rtreichl/Wordclock/02_Electronics/Bilder/Platine_3D_schraeg_unten.png

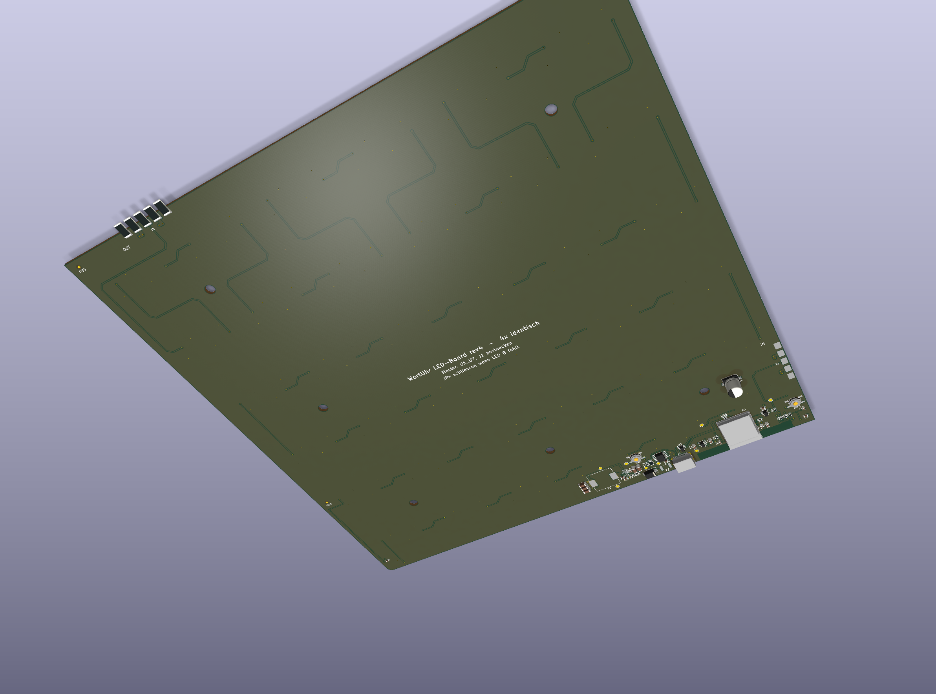
02_Electronics/Bilder/Platine_3D_schraeg_unten.png
