rtreichl/Wordclock/05_Production/03_Gitter_3D-Druck/QUALIFIKATION.md

# Qualifikationsbericht – Lichtgitter Q1–Q4

| | |
|---|---|
| Bauteil | Lichtgitter Q1–Q4 |
| Fertiger | P1S, JLC3DP |
| Datum | 2026-11-10 |
| Stand | Git `a8529da` |
| Pruefung | automatisch, `05_Production/tools/` |
| Ergebnis | **Bambu Lab P1S: FREIGEGEBEN** · **JLC3DP: FREIGEGEBEN** |

## Pruefergebnisse

| Kategorie | Pruefung | Kriterium | Messwert | P1S | JLC3DP |
|---|---|---|---|---|---|
| Geometrie | Gitter Q1 (P1S-Variante): Gueltiger Volumenkoerper | 1 gueltiger Solid | valid=True, solids=1 | ✅ bestanden | – |
| Netz | Gitter Q1 (P1S-Variante): Geschlossen und mannigfaltig | solid, keine nicht-mannigfaltigen Kanten, keine Selbstdurchdringung | solid=True, nonmanifold=False, selfint=False | ✅ bestanden | – |
| Bauraum | Gitter Q1 (P1S-Variante): Groesse in Druckorientierung | P1S <= 256^3; JLC3DP <= 250 x 250 x 300, >= 30 x 30 x 10 | 244.1 x 243.5 x 25.0 mm | ✅ bestanden | – |
| Bauraum | Gitter Q1 (P1S-Variante): Flach auf dem Druckbett | Auflageflaeche > 20 cm^2 bei z = 0 | 242 cm^2 | ✅ bestanden | – |
| Wandstaerke | Gitter Q1 (P1S-Variante): Duennste Wand (Strahlmessung, 20000 Punkte) | >= 0.84 mm | 2.50 mm bei (12.5, -173.3, 1.7) | ✅ bestanden | – |
| Bohrungen | Gitter Q1 (P1S-Variante): Kleinste Bohrung | >= 1.5 mm | Kernloch M3 2,6 mm; Magnet 3,2 mm; Lichtleiter 2,8 mm | ✅ bestanden | – |
| Passung | Gitter Q1 (P1S-Variante): Kollision mit Platine (inkl. Bauteile) | 0 mm^3 | 0.000 mm^3 | ✅ bestanden | – |
| Passung | Gitter Q1 (P1S-Variante): Ueberschneidung mit Nachbarteilen | 0 mm^3 | 0.000 mm^3 | ✅ bestanden | – |
| Passung | Gitter Q1 (P1S-Variante): Spiel Schwalbenschwanz | >= 0,15 mm (P1S, 0,4-mm-Duese) | 0,19 mm normal zur Flanke, 0,3 mm an der Stirn | ✅ bestanden | – |
| Masshaltigkeit | Gitter Q1 (P1S-Variante): Lochbild gegen Platine | Druckabweichung ~+-0,2 mm <= Lochspiel 0.65 mm | +-0,2 mm | ✅ bestanden | – |
| Geometrie | Gitter Q2 (P1S-Variante): Gueltiger Volumenkoerper | 1 gueltiger Solid | valid=True, solids=1 | ✅ bestanden | – |
| Netz | Gitter Q2 (P1S-Variante): Geschlossen und mannigfaltig | solid, keine nicht-mannigfaltigen Kanten, keine Selbstdurchdringung | solid=True, nonmanifold=False, selfint=False | ✅ bestanden | – |
| Bauraum | Gitter Q2 (P1S-Variante): Groesse in Druckorientierung | P1S <= 256^3; JLC3DP <= 250 x 250 x 300, >= 30 x 30 x 10 | 239.4 x 243.5 x 25.0 mm | ✅ bestanden | – |
| Bauraum | Gitter Q2 (P1S-Variante): Flach auf dem Druckbett | Auflageflaeche > 20 cm^2 bei z = 0 | 239 cm^2 | ✅ bestanden | – |
| Wandstaerke | Gitter Q2 (P1S-Variante): Duennste Wand (Strahlmessung, 20000 Punkte) | >= 0.84 mm | 2.50 mm bei (254.3, -54.5, 22.9) | ✅ bestanden | – |
| Bohrungen | Gitter Q2 (P1S-Variante): Kleinste Bohrung | >= 1.5 mm | Kernloch M3 2,6 mm; Magnet 3,2 mm; Lichtleiter 2,8 mm | ✅ bestanden | – |
| Passung | Gitter Q2 (P1S-Variante): Kollision mit Platine (inkl. Bauteile) | 0 mm^3 | 0.000 mm^3 | ✅ bestanden | – |
| Passung | Gitter Q2 (P1S-Variante): Ueberschneidung mit Nachbarteilen | 0 mm^3 | 0.000 mm^3 | ✅ bestanden | – |
| Passung | Gitter Q2 (P1S-Variante): Spiel Schwalbenschwanz | >= 0,15 mm (P1S, 0,4-mm-Duese) | 0,19 mm normal zur Flanke, 0,3 mm an der Stirn | ✅ bestanden | – |
| Masshaltigkeit | Gitter Q2 (P1S-Variante): Lochbild gegen Platine | Druckabweichung ~+-0,2 mm <= Lochspiel 0.65 mm | +-0,2 mm | ✅ bestanden | – |
| Geometrie | Gitter Q3 (P1S-Variante): Gueltiger Volumenkoerper | 1 gueltiger Solid | valid=True, solids=1 | ✅ bestanden | – |
| Netz | Gitter Q3 (P1S-Variante): Geschlossen und mannigfaltig | solid, keine nicht-mannigfaltigen Kanten, keine Selbstdurchdringung | solid=True, nonmanifold=False, selfint=False | ✅ bestanden | – |
| Bauraum | Gitter Q3 (P1S-Variante): Groesse in Druckorientierung | P1S <= 256^3; JLC3DP <= 250 x 250 x 300, >= 30 x 30 x 10 | 244.1 x 240.0 x 25.0 mm | ✅ bestanden | – |
| Bauraum | Gitter Q3 (P1S-Variante): Flach auf dem Druckbett | Auflageflaeche > 20 cm^2 bei z = 0 | 242 cm^2 | ✅ bestanden | – |
| Wandstaerke | Gitter Q3 (P1S-Variante): Duennste Wand (Strahlmessung, 20000 Punkte) | >= 0.84 mm | 2.50 mm bei (54.4, -253.5, 22.9) | ✅ bestanden | – |
| Bohrungen | Gitter Q3 (P1S-Variante): Kleinste Bohrung | >= 1.5 mm | Kernloch M3 2,6 mm; Magnet 3,2 mm; Lichtleiter 2,8 mm | ✅ bestanden | – |
| Passung | Gitter Q3 (P1S-Variante): Kollision mit Platine (inkl. Bauteile) | 0 mm^3 | 0.000 mm^3 | ✅ bestanden | – |
| Passung | Gitter Q3 (P1S-Variante): Ueberschneidung mit Nachbarteilen | 0 mm^3 | 0.000 mm^3 | ✅ bestanden | – |
| Passung | Gitter Q3 (P1S-Variante): Spiel Schwalbenschwanz | >= 0,15 mm (P1S, 0,4-mm-Duese) | 0,19 mm normal zur Flanke, 0,3 mm an der Stirn | ✅ bestanden | – |
| Masshaltigkeit | Gitter Q3 (P1S-Variante): Lochbild gegen Platine | Druckabweichung ~+-0,2 mm <= Lochspiel 0.65 mm | +-0,2 mm | ✅ bestanden | – |
| Geometrie | Gitter Q4 (P1S-Variante): Gueltiger Volumenkoerper | 1 gueltiger Solid | valid=True, solids=1 | ✅ bestanden | – |
| Netz | Gitter Q4 (P1S-Variante): Geschlossen und mannigfaltig | solid, keine nicht-mannigfaltigen Kanten, keine Selbstdurchdringung | solid=True, nonmanifold=False, selfint=False | ✅ bestanden | – |
| Bauraum | Gitter Q4 (P1S-Variante): Groesse in Druckorientierung | P1S <= 256^3; JLC3DP <= 250 x 250 x 300, >= 30 x 30 x 10 | 239.4 x 240.0 x 25.0 mm | ✅ bestanden | – |
| Bauraum | Gitter Q4 (P1S-Variante): Flach auf dem Druckbett | Auflageflaeche > 20 cm^2 bei z = 0 | 239 cm^2 | ✅ bestanden | – |
| Wandstaerke | Gitter Q4 (P1S-Variante): Duennste Wand (Strahlmessung, 20000 Punkte) | >= 0.84 mm | 2.50 mm bei (285.4, -253.8, 22.9) | ✅ bestanden | – |
| Bohrungen | Gitter Q4 (P1S-Variante): Kleinste Bohrung | >= 1.5 mm | Kernloch M3 2,6 mm; Magnet 3,2 mm; Lichtleiter 2,8 mm | ✅ bestanden | – |
| Passung | Gitter Q4 (P1S-Variante): Kollision mit Platine (inkl. Bauteile) | 0 mm^3 | 0.000 mm^3 | ✅ bestanden | – |
| Passung | Gitter Q4 (P1S-Variante): Ueberschneidung mit Nachbarteilen | 0 mm^3 | 0.000 mm^3 | ✅ bestanden | – |
| Passung | Gitter Q4 (P1S-Variante): Spiel Schwalbenschwanz | >= 0,15 mm (P1S, 0,4-mm-Duese) | 0,19 mm normal zur Flanke, 0,3 mm an der Stirn | ✅ bestanden | – |
| Masshaltigkeit | Gitter Q4 (P1S-Variante): Lochbild gegen Platine | Druckabweichung ~+-0,2 mm <= Lochspiel 0.65 mm | +-0,2 mm | ✅ bestanden | – |
| Geometrie | Gitter Q1 (JLC3DP-Variante): Gueltiger Volumenkoerper | 1 gueltiger Solid | valid=True, solids=1 | – | ✅ bestanden |
| Netz | Gitter Q1 (JLC3DP-Variante): Geschlossen und mannigfaltig | solid, keine nicht-mannigfaltigen Kanten, keine Selbstdurchdringung | solid=True, nonmanifold=False, selfint=False | – | ✅ bestanden |
| Bauraum | Gitter Q1 (JLC3DP-Variante): Groesse in Druckorientierung | P1S <= 256^3; JLC3DP <= 250 x 250 x 300, >= 30 x 30 x 10 | 243.9 x 243.3 x 25.0 mm | – | ✅ bestanden |
| Bauraum | Gitter Q1 (JLC3DP-Variante): Flach auf dem Druckbett | Auflageflaeche > 20 cm^2 bei z = 0 | 240 cm^2 | – | ✅ bestanden |
| Wandstaerke | Gitter Q1 (JLC3DP-Variante): Duennste Wand (Strahlmessung, 20000 Punkte) | >= 2.5 mm | 2.50 mm bei (12.5, -173.2, 1.7) | – | ✅ bestanden |
| Bohrungen | Gitter Q1 (JLC3DP-Variante): Kleinste Bohrung | >= 1.5 mm | Kernloch M3 2,6 mm; Magnet 3,2 mm; Lichtleiter 2,8 mm | – | ✅ bestanden |
| Passung | Gitter Q1 (JLC3DP-Variante): Kollision mit Platine (inkl. Bauteile) | 0 mm^3 | 0.000 mm^3 | – | ✅ bestanden |
| Passung | Gitter Q1 (JLC3DP-Variante): Ueberschneidung mit Nachbarteilen | 0 mm^3 | 0.000 mm^3 | – | ✅ bestanden |
| Passung | Gitter Q1 (JLC3DP-Variante): Spiel zwischen den Teilen (gemessen) | >= 0.5 mm Montagespiel | 0.500 mm | – | ✅ bestanden |
| Masshaltigkeit | Gitter Q1 (JLC3DP-Variante): Lochbild gegen Platine | +-0,4 % auf 218 mm, halbe Abweichung <= Lochspiel 0.65 mm | 0.44 mm | – | ✅ bestanden |
| Masshaltigkeit | Gitter Q1 (JLC3DP-Variante): Versatz der Schwalbenschwaenze entlang der Fuge | 0,4 % auf 77 mm <= Seitenspiel 0.53 mm | 0.31 mm | – | ✅ bestanden |
| Masshaltigkeit | Gitter Q1 (JLC3DP-Variante): Fuge bei Uebermass | Uebermass ueber halbe Fuge <= Lochspiel 0.65 mm | 0.23 mm | – | ✅ bestanden |
| Geometrie | Gitter Q2 (JLC3DP-Variante): Gueltiger Volumenkoerper | 1 gueltiger Solid | valid=True, solids=1 | – | ✅ bestanden |
| Netz | Gitter Q2 (JLC3DP-Variante): Geschlossen und mannigfaltig | solid, keine nicht-mannigfaltigen Kanten, keine Selbstdurchdringung | solid=True, nonmanifold=False, selfint=False | – | ✅ bestanden |
| Bauraum | Gitter Q2 (JLC3DP-Variante): Groesse in Druckorientierung | P1S <= 256^3; JLC3DP <= 250 x 250 x 300, >= 30 x 30 x 10 | 239.1 x 243.3 x 25.0 mm | – | ✅ bestanden |
| Bauraum | Gitter Q2 (JLC3DP-Variante): Flach auf dem Druckbett | Auflageflaeche > 20 cm^2 bei z = 0 | 237 cm^2 | – | ✅ bestanden |
| Wandstaerke | Gitter Q2 (JLC3DP-Variante): Duennste Wand (Strahlmessung, 20000 Punkte) | >= 2.5 mm | 2.50 mm bei (254.1, -131.1, 22.9) | – | ✅ bestanden |
| Bohrungen | Gitter Q2 (JLC3DP-Variante): Kleinste Bohrung | >= 1.5 mm | Kernloch M3 2,6 mm; Magnet 3,2 mm; Lichtleiter 2,8 mm | – | ✅ bestanden |
| Passung | Gitter Q2 (JLC3DP-Variante): Kollision mit Platine (inkl. Bauteile) | 0 mm^3 | 0.000 mm^3 | – | ✅ bestanden |
| Passung | Gitter Q2 (JLC3DP-Variante): Ueberschneidung mit Nachbarteilen | 0 mm^3 | 0.000 mm^3 | – | ✅ bestanden |
| Passung | Gitter Q2 (JLC3DP-Variante): Spiel zwischen den Teilen (gemessen) | >= 0.5 mm Montagespiel | 0.500 mm | – | ✅ bestanden |
| Masshaltigkeit | Gitter Q2 (JLC3DP-Variante): Lochbild gegen Platine | +-0,4 % auf 218 mm, halbe Abweichung <= Lochspiel 0.65 mm | 0.44 mm | – | ✅ bestanden |
| Masshaltigkeit | Gitter Q2 (JLC3DP-Variante): Versatz der Schwalbenschwaenze entlang der Fuge | 0,4 % auf 77 mm <= Seitenspiel 0.53 mm | 0.31 mm | – | ✅ bestanden |
| Masshaltigkeit | Gitter Q2 (JLC3DP-Variante): Fuge bei Uebermass | Uebermass ueber halbe Fuge <= Lochspiel 0.65 mm | 0.23 mm | – | ✅ bestanden |
| Geometrie | Gitter Q3 (JLC3DP-Variante): Gueltiger Volumenkoerper | 1 gueltiger Solid | valid=True, solids=1 | – | ✅ bestanden |
| Netz | Gitter Q3 (JLC3DP-Variante): Geschlossen und mannigfaltig | solid, keine nicht-mannigfaltigen Kanten, keine Selbstdurchdringung | solid=True, nonmanifold=False, selfint=False | – | ✅ bestanden |
| Bauraum | Gitter Q3 (JLC3DP-Variante): Groesse in Druckorientierung | P1S <= 256^3; JLC3DP <= 250 x 250 x 300, >= 30 x 30 x 10 | 243.9 x 239.8 x 25.0 mm | – | ✅ bestanden |
| Bauraum | Gitter Q3 (JLC3DP-Variante): Flach auf dem Druckbett | Auflageflaeche > 20 cm^2 bei z = 0 | 240 cm^2 | – | ✅ bestanden |
| Wandstaerke | Gitter Q3 (JLC3DP-Variante): Duennste Wand (Strahlmessung, 20000 Punkte) | >= 2.5 mm | 2.50 mm bei (138.6, -253.7, 22.9) | – | ✅ bestanden |
| Bohrungen | Gitter Q3 (JLC3DP-Variante): Kleinste Bohrung | >= 1.5 mm | Kernloch M3 2,6 mm; Magnet 3,2 mm; Lichtleiter 2,8 mm | – | ✅ bestanden |
| Passung | Gitter Q3 (JLC3DP-Variante): Kollision mit Platine (inkl. Bauteile) | 0 mm^3 | 0.000 mm^3 | – | ✅ bestanden |
| Passung | Gitter Q3 (JLC3DP-Variante): Ueberschneidung mit Nachbarteilen | 0 mm^3 | 0.000 mm^3 | – | ✅ bestanden |
| Passung | Gitter Q3 (JLC3DP-Variante): Spiel zwischen den Teilen (gemessen) | >= 0.5 mm Montagespiel | 0.500 mm | – | ✅ bestanden |
| Masshaltigkeit | Gitter Q3 (JLC3DP-Variante): Lochbild gegen Platine | +-0,4 % auf 218 mm, halbe Abweichung <= Lochspiel 0.65 mm | 0.44 mm | – | ✅ bestanden |
| Masshaltigkeit | Gitter Q3 (JLC3DP-Variante): Versatz der Schwalbenschwaenze entlang der Fuge | 0,4 % auf 77 mm <= Seitenspiel 0.53 mm | 0.31 mm | – | ✅ bestanden |
| Masshaltigkeit | Gitter Q3 (JLC3DP-Variante): Fuge bei Uebermass | Uebermass ueber halbe Fuge <= Lochspiel 0.65 mm | 0.23 mm | – | ✅ bestanden |
| Geometrie | Gitter Q4 (JLC3DP-Variante): Gueltiger Volumenkoerper | 1 gueltiger Solid | valid=True, solids=1 | – | ✅ bestanden |
| Netz | Gitter Q4 (JLC3DP-Variante): Geschlossen und mannigfaltig | solid, keine nicht-mannigfaltigen Kanten, keine Selbstdurchdringung | solid=True, nonmanifold=False, selfint=False | – | ✅ bestanden |
| Bauraum | Gitter Q4 (JLC3DP-Variante): Groesse in Druckorientierung | P1S <= 256^3; JLC3DP <= 250 x 250 x 300, >= 30 x 30 x 10 | 239.1 x 239.8 x 25.0 mm | – | ✅ bestanden |
| Bauraum | Gitter Q4 (JLC3DP-Variante): Flach auf dem Druckbett | Auflageflaeche > 20 cm^2 bei z = 0 | 237 cm^2 | – | ✅ bestanden |
| Wandstaerke | Gitter Q4 (JLC3DP-Variante): Duennste Wand (Strahlmessung, 20000 Punkte) | >= 2.5 mm | 2.50 mm bei (254.2, -445.6, 22.9) | – | ✅ bestanden |
| Bohrungen | Gitter Q4 (JLC3DP-Variante): Kleinste Bohrung | >= 1.5 mm | Kernloch M3 2,6 mm; Magnet 3,2 mm; Lichtleiter 2,8 mm | – | ✅ bestanden |
| Passung | Gitter Q4 (JLC3DP-Variante): Kollision mit Platine (inkl. Bauteile) | 0 mm^3 | 0.000 mm^3 | – | ✅ bestanden |
| Passung | Gitter Q4 (JLC3DP-Variante): Ueberschneidung mit Nachbarteilen | 0 mm^3 | 0.000 mm^3 | – | ✅ bestanden |
| Passung | Gitter Q4 (JLC3DP-Variante): Spiel zwischen den Teilen (gemessen) | >= 0.5 mm Montagespiel | 0.500 mm | – | ✅ bestanden |
| Masshaltigkeit | Gitter Q4 (JLC3DP-Variante): Lochbild gegen Platine | +-0,4 % auf 218 mm, halbe Abweichung <= Lochspiel 0.65 mm | 0.44 mm | – | ✅ bestanden |
| Masshaltigkeit | Gitter Q4 (JLC3DP-Variante): Versatz der Schwalbenschwaenze entlang der Fuge | 0,4 % auf 77 mm <= Seitenspiel 0.53 mm | 0.31 mm | – | ✅ bestanden |
| Masshaltigkeit | Gitter Q4 (JLC3DP-Variante): Fuge bei Uebermass | Uebermass ueber halbe Fuge <= Lochspiel 0.65 mm | 0.23 mm | – | ✅ bestanden |

## Hinweise und offene Punkte

- **Gitter Q1 (P1S-Variante): Duennste Wand (Strahlmessung, 20000 Punkte):** Duenne Stellen: Waende der Schwalbenschwanz-Taschen und um die Magnetbohrungen.
- **Gitter Q1 (P1S-Variante): Kleinste Bohrung:** FDM-Bohrungen fallen etwas kleiner aus: Magnetbohrungen ggf. mit 3,2-mm-Bohrer nacharbeiten.
- **Gitter Q2 (P1S-Variante): Duennste Wand (Strahlmessung, 20000 Punkte):** Duenne Stellen: Waende der Schwalbenschwanz-Taschen und um die Magnetbohrungen.
- **Gitter Q2 (P1S-Variante): Kleinste Bohrung:** FDM-Bohrungen fallen etwas kleiner aus: Magnetbohrungen ggf. mit 3,2-mm-Bohrer nacharbeiten.
- **Gitter Q3 (P1S-Variante): Duennste Wand (Strahlmessung, 20000 Punkte):** Duenne Stellen: Waende der Schwalbenschwanz-Taschen und um die Magnetbohrungen.
- **Gitter Q3 (P1S-Variante): Kleinste Bohrung:** FDM-Bohrungen fallen etwas kleiner aus: Magnetbohrungen ggf. mit 3,2-mm-Bohrer nacharbeiten.
- **Gitter Q4 (P1S-Variante): Duennste Wand (Strahlmessung, 20000 Punkte):** Duenne Stellen: Waende der Schwalbenschwanz-Taschen und um die Magnetbohrungen.
- **Gitter Q4 (P1S-Variante): Kleinste Bohrung:** FDM-Bohrungen fallen etwas kleiner aus: Magnetbohrungen ggf. mit 3,2-mm-Bohrer nacharbeiten.
- **Gitter Q1 (JLC3DP-Variante): Duennste Wand (Strahlmessung, 20000 Punkte):** Duenne Stellen: Waende der Schwalbenschwanz-Taschen und um die Magnetbohrungen.
- **Gitter Q1 (JLC3DP-Variante): Kleinste Bohrung:** FDM-Bohrungen fallen etwas kleiner aus: Magnetbohrungen ggf. mit 3,2-mm-Bohrer nacharbeiten.
- **Gitter Q1 (JLC3DP-Variante): Spiel zwischen den Teilen (gemessen):** Zapfen parallel zur Tasche verkleinert, Fuge 0,5 mm; Hinterschnitt 0,5 mm je Seite.
- **Gitter Q1 (JLC3DP-Variante): Versatz der Schwalbenschwaenze entlang der Fuge:** Annahme: alle 4 Teile in einer Bestellung aus demselben Material, Teile richten sich am mittleren Zapfen jeder Fuge aus.
- **Gitter Q2 (JLC3DP-Variante): Duennste Wand (Strahlmessung, 20000 Punkte):** Duenne Stellen: Waende der Schwalbenschwanz-Taschen und um die Magnetbohrungen.
- **Gitter Q2 (JLC3DP-Variante): Kleinste Bohrung:** FDM-Bohrungen fallen etwas kleiner aus: Magnetbohrungen ggf. mit 3,2-mm-Bohrer nacharbeiten.
- **Gitter Q2 (JLC3DP-Variante): Spiel zwischen den Teilen (gemessen):** Zapfen parallel zur Tasche verkleinert, Fuge 0,5 mm; Hinterschnitt 0,5 mm je Seite.
- **Gitter Q2 (JLC3DP-Variante): Versatz der Schwalbenschwaenze entlang der Fuge:** Annahme: alle 4 Teile in einer Bestellung aus demselben Material, Teile richten sich am mittleren Zapfen jeder Fuge aus.
- **Gitter Q3 (JLC3DP-Variante): Duennste Wand (Strahlmessung, 20000 Punkte):** Duenne Stellen: Waende der Schwalbenschwanz-Taschen und um die Magnetbohrungen.
- **Gitter Q3 (JLC3DP-Variante): Kleinste Bohrung:** FDM-Bohrungen fallen etwas kleiner aus: Magnetbohrungen ggf. mit 3,2-mm-Bohrer nacharbeiten.
- **Gitter Q3 (JLC3DP-Variante): Spiel zwischen den Teilen (gemessen):** Zapfen parallel zur Tasche verkleinert, Fuge 0,5 mm; Hinterschnitt 0,5 mm je Seite.
- **Gitter Q3 (JLC3DP-Variante): Versatz der Schwalbenschwaenze entlang der Fuge:** Annahme: alle 4 Teile in einer Bestellung aus demselben Material, Teile richten sich am mittleren Zapfen jeder Fuge aus.
- **Gitter Q4 (JLC3DP-Variante): Duennste Wand (Strahlmessung, 20000 Punkte):** Duenne Stellen: Waende der Schwalbenschwanz-Taschen und um die Magnetbohrungen.
- **Gitter Q4 (JLC3DP-Variante): Kleinste Bohrung:** FDM-Bohrungen fallen etwas kleiner aus: Magnetbohrungen ggf. mit 3,2-mm-Bohrer nacharbeiten.
- **Gitter Q4 (JLC3DP-Variante): Spiel zwischen den Teilen (gemessen):** Zapfen parallel zur Tasche verkleinert, Fuge 0,5 mm; Hinterschnitt 0,5 mm je Seite.
- **Gitter Q4 (JLC3DP-Variante): Versatz der Schwalbenschwaenze entlang der Fuge:** Annahme: alle 4 Teile in einer Bestellung aus demselben Material, Teile richten sich am mittleren Zapfen jeder Fuge aus.
- Druck: PLA, 0,4-mm-Duese, Gitter mit der Vorderseite (z = 25) auf dem Bett, Rueckrahmen mit der Wandseite auf dem Bett.

## Freigegebene Dateien

| Datei | SHA256 |
|---|---|
| `Gitter_Q1_obenlinks.step` | `7725c478193fb764…` |
| `Gitter_Q1_obenlinks_JLC3DP.step` | `16964a987c3249e7…` |
| `Gitter_Q1_obenlinks_JLC3DP_druckfertig.3mf` | `90f5346fd77986e1…` |
| `Gitter_Q1_obenlinks_druckfertig.3mf` | `179a4d64ef6c6e47…` |
| `Gitter_Q2_obenrechts.step` | `113b9d3d01cc0ba6…` |
| `Gitter_Q2_obenrechts_JLC3DP.step` | `8c0787b24e400f75…` |
| `Gitter_Q2_obenrechts_JLC3DP_druckfertig.3mf` | `8688b861642d8da3…` |
| `Gitter_Q2_obenrechts_druckfertig.3mf` | `f466d78a61dc06a5…` |
| `Gitter_Q3_untenlinks.step` | `57159257ab917b6e…` |
| `Gitter_Q3_untenlinks_JLC3DP.step` | `51162a58c96c1e39…` |
| `Gitter_Q3_untenlinks_JLC3DP_druckfertig.3mf` | `dc0893f47630a0c0…` |
| `Gitter_Q3_untenlinks_druckfertig.3mf` | `17754dc1e6e4d6c3…` |
| `Gitter_Q4_untenrechts.step` | `a61be4029f274bc2…` |
| `Gitter_Q4_untenrechts_JLC3DP.step` | `d2efce433491f0bc…` |
| `Gitter_Q4_untenrechts_JLC3DP_druckfertig.3mf` | `432d5da8599d5e3b…` |
| `Gitter_Q4_untenrechts_druckfertig.3mf` | `a79ab730cee3b6b5…` |

## Grundlage (Fertigerangaben, abgerufen 2026-11-07)

- [Bambu Lab P1S Spezifikation](https://wiki.bambulab.com/en/p1/manual/unboxing-p1s)
- [JLC3DP 3D Printing Design Guideline](https://jlc3dp.com/help/article/3D-Printing-Design-Guideline)
