rtreichl/Wordclock/05_Production/04_Rueckrahmen_3D-Druck/QUALIFIKATION.md

# Qualifikationsbericht – Rückrahmen (8 Leisten, 2 Druckplatten)

| | |
|---|---|
| Bauteil | Rückrahmen (8 Leisten, 2 Druckplatten) |
| Fertiger | P1S, JLC3DP |
| Datum | 2026-11-10 |
| Stand | Git `a8529da` |
| Pruefung | automatisch, `05_Production/tools/` |
| Ergebnis | **Bambu Lab P1S: FREIGEGEBEN** · **JLC3DP: FREIGEGEBEN** |

## Pruefergebnisse

| Kategorie | Pruefung | Kriterium | Messwert | P1S | JLC3DP |
|---|---|---|---|---|---|
| Geometrie | Rueckrahmen Q1_obenlinks_lang: Gueltiger Volumenkoerper | 1 gueltiger Solid | valid=True, solids=1 | ✅ bestanden | ✅ bestanden |
| Netz | Rueckrahmen Q1_obenlinks_lang: Geschlossen und mannigfaltig | solid, keine nicht-mannigfaltigen Kanten, keine Selbstdurchdringung | solid=True, nonmanifold=False, selfint=False | ✅ bestanden | ✅ bestanden |
| Bauraum | Rueckrahmen Q1_obenlinks_lang: Groesse in Druckorientierung | P1S <= 256^3; JLC3DP <= 250 x 250 x 300, >= 30 x 30 x 10 | 240.4 x 56.0 x 13.4 mm | ✅ bestanden | ✅ bestanden |
| Bauraum | Rueckrahmen Q1_obenlinks_lang: Flach auf dem Druckbett | Auflageflaeche > 20 cm^2 bei z = 0 | 132 cm^2 | ✅ bestanden | ✅ bestanden |
| Wandstaerke | Rueckrahmen Q1_obenlinks_lang: Duennste Wand (Strahlmessung, 1792 Punkte) | P1S >= 0.84 mm; JLC3DP >= 2.5 mm | 2.54 mm bei (216.4, -57.5, 2.3) | ✅ bestanden | ✅ bestanden |
| Passung | Rueckrahmen Q1_obenlinks_lang: Kollision mit Gitter | 0 mm^3 | 0.000 mm^3 | ✅ bestanden | ✅ bestanden |
| Bohrungen | Rueckrahmen Q1_obenlinks_lang: Kleinste Bohrung | JLC3DP >= 1.5 mm | Durchgang M3 3,4 mm; Schluesselloch 4,6/9 mm | ✅ bestanden | ✅ bestanden |
| Geometrie | Rueckrahmen Q1_obenlinks_kurz: Gueltiger Volumenkoerper | 1 gueltiger Solid | valid=True, solids=1 | ✅ bestanden | ✅ bestanden |
| Netz | Rueckrahmen Q1_obenlinks_kurz: Geschlossen und mannigfaltig | solid, keine nicht-mannigfaltigen Kanten, keine Selbstdurchdringung | solid=True, nonmanifold=False, selfint=False | ✅ bestanden | ✅ bestanden |
| Bauraum | Rueckrahmen Q1_obenlinks_kurz: Groesse in Druckorientierung | P1S <= 256^3; JLC3DP <= 250 x 250 x 300, >= 30 x 30 x 10 | 56.0 x 183.6 x 13.4 mm | ✅ bestanden | ✅ bestanden |
| Bauraum | Rueckrahmen Q1_obenlinks_kurz: Flach auf dem Druckbett | Auflageflaeche > 20 cm^2 bei z = 0 | 102 cm^2 | ✅ bestanden | ✅ bestanden |
| Wandstaerke | Rueckrahmen Q1_obenlinks_kurz: Duennste Wand (Strahlmessung, 1028 Punkte) | P1S >= 0.84 mm; JLC3DP >= 2.5 mm | 2.54 mm bei (59.5, -138.7, 2.3) | ✅ bestanden | ✅ bestanden |
| Passung | Rueckrahmen Q1_obenlinks_kurz: Kollision mit Gitter | 0 mm^3 | 0.000 mm^3 | ✅ bestanden | ✅ bestanden |
| Bohrungen | Rueckrahmen Q1_obenlinks_kurz: Kleinste Bohrung | JLC3DP >= 1.5 mm | Durchgang M3 3,4 mm; Schluesselloch 4,6/9 mm | ✅ bestanden | ✅ bestanden |
| Geometrie | Rueckrahmen Q2_obenrechts_lang: Gueltiger Volumenkoerper | 1 gueltiger Solid | valid=True, solids=1 | ✅ bestanden | ✅ bestanden |
| Netz | Rueckrahmen Q2_obenrechts_lang: Geschlossen und mannigfaltig | solid, keine nicht-mannigfaltigen Kanten, keine Selbstdurchdringung | solid=True, nonmanifold=False, selfint=False | ✅ bestanden | ✅ bestanden |
| Bauraum | Rueckrahmen Q2_obenrechts_lang: Groesse in Druckorientierung | P1S <= 256^3; JLC3DP <= 250 x 250 x 300, >= 30 x 30 x 10 | 239.2 x 56.0 x 13.4 mm | ✅ bestanden | ✅ bestanden |
| Bauraum | Rueckrahmen Q2_obenrechts_lang: Flach auf dem Druckbett | Auflageflaeche > 20 cm^2 bei z = 0 | 132 cm^2 | ✅ bestanden | ✅ bestanden |
| Wandstaerke | Rueckrahmen Q2_obenrechts_lang: Duennste Wand (Strahlmessung, 1772 Punkte) | P1S >= 0.84 mm; JLC3DP >= 2.5 mm | 2.54 mm bei (369.9, -56.0, 1.2) | ✅ bestanden | ✅ bestanden |
| Passung | Rueckrahmen Q2_obenrechts_lang: Kollision mit Gitter | 0 mm^3 | 0.000 mm^3 | ✅ bestanden | ✅ bestanden |
| Bohrungen | Rueckrahmen Q2_obenrechts_lang: Kleinste Bohrung | JLC3DP >= 1.5 mm | Durchgang M3 3,4 mm; Schluesselloch 4,6/9 mm | ✅ bestanden | ✅ bestanden |
| Geometrie | Rueckrahmen Q2_obenrechts_kurz: Gueltiger Volumenkoerper | 1 gueltiger Solid | valid=True, solids=1 | ✅ bestanden | ✅ bestanden |
| Netz | Rueckrahmen Q2_obenrechts_kurz: Geschlossen und mannigfaltig | solid, keine nicht-mannigfaltigen Kanten, keine Selbstdurchdringung | solid=True, nonmanifold=False, selfint=False | ✅ bestanden | ✅ bestanden |
| Bauraum | Rueckrahmen Q2_obenrechts_kurz: Groesse in Druckorientierung | P1S <= 256^3; JLC3DP <= 250 x 250 x 300, >= 30 x 30 x 10 | 56.0 x 183.6 x 13.4 mm | ✅ bestanden | ✅ bestanden |
| Bauraum | Rueckrahmen Q2_obenrechts_kurz: Flach auf dem Druckbett | Auflageflaeche > 20 cm^2 bei z = 0 | 101 cm^2 | ✅ bestanden | ✅ bestanden |
| Wandstaerke | Rueckrahmen Q2_obenrechts_kurz: Duennste Wand (Strahlmessung, 1048 Punkte) | P1S >= 0.84 mm; JLC3DP >= 2.5 mm | 2.54 mm bei (441.8, -138.7, 1.2) | ✅ bestanden | ✅ bestanden |
| Passung | Rueckrahmen Q2_obenrechts_kurz: Kollision mit Gitter | 0 mm^3 | 0.000 mm^3 | ✅ bestanden | ✅ bestanden |
| Bohrungen | Rueckrahmen Q2_obenrechts_kurz: Kleinste Bohrung | JLC3DP >= 1.5 mm | Durchgang M3 3,4 mm; Schluesselloch 4,6/9 mm | ✅ bestanden | ✅ bestanden |
| Geometrie | Rueckrahmen Q3_untenlinks_lang: Gueltiger Volumenkoerper | 1 gueltiger Solid | valid=True, solids=1 | ✅ bestanden | ✅ bestanden |
| Netz | Rueckrahmen Q3_untenlinks_lang: Geschlossen und mannigfaltig | solid, keine nicht-mannigfaltigen Kanten, keine Selbstdurchdringung | solid=True, nonmanifold=False, selfint=False | ✅ bestanden | ✅ bestanden |
| Bauraum | Rueckrahmen Q3_untenlinks_lang: Groesse in Druckorientierung | P1S <= 256^3; JLC3DP <= 250 x 250 x 300, >= 30 x 30 x 10 | 240.4 x 56.0 x 13.4 mm | ✅ bestanden | ✅ bestanden |
| Bauraum | Rueckrahmen Q3_untenlinks_lang: Flach auf dem Druckbett | Auflageflaeche > 20 cm^2 bei z = 0 | 134 cm^2 | ✅ bestanden | ✅ bestanden |
| Wandstaerke | Rueckrahmen Q3_untenlinks_lang: Duennste Wand (Strahlmessung, 1536 Punkte) | P1S >= 0.84 mm; JLC3DP >= 2.5 mm | 2.54 mm bei (133.3, -446.1, 2.3) | ✅ bestanden | ✅ bestanden |
| Passung | Rueckrahmen Q3_untenlinks_lang: Kollision mit Gitter | 0 mm^3 | 0.000 mm^3 | ✅ bestanden | ✅ bestanden |
| Bohrungen | Rueckrahmen Q3_untenlinks_lang: Kleinste Bohrung | JLC3DP >= 1.5 mm | Durchgang M3 3,4 mm; Schluesselloch 4,6/9 mm | ✅ bestanden | ✅ bestanden |
| Geometrie | Rueckrahmen Q3_untenlinks_kurz: Gueltiger Volumenkoerper | 1 gueltiger Solid | valid=True, solids=1 | ✅ bestanden | ✅ bestanden |
| Netz | Rueckrahmen Q3_untenlinks_kurz: Geschlossen und mannigfaltig | solid, keine nicht-mannigfaltigen Kanten, keine Selbstdurchdringung | solid=True, nonmanifold=False, selfint=False | ✅ bestanden | ✅ bestanden |
| Bauraum | Rueckrahmen Q3_untenlinks_kurz: Groesse in Druckorientierung | P1S <= 256^3; JLC3DP <= 250 x 250 x 300, >= 30 x 30 x 10 | 56.0 x 183.6 x 13.4 mm | ✅ bestanden | ✅ bestanden |
| Bauraum | Rueckrahmen Q3_untenlinks_kurz: Flach auf dem Druckbett | Auflageflaeche > 20 cm^2 bei z = 0 | 101 cm^2 | ✅ bestanden | ✅ bestanden |
| Wandstaerke | Rueckrahmen Q3_untenlinks_kurz: Duennste Wand (Strahlmessung, 1048 Punkte) | P1S >= 0.84 mm; JLC3DP >= 2.5 mm | 2.54 mm bei (58.2, -284.2, 2.3) | ✅ bestanden | ✅ bestanden |
| Passung | Rueckrahmen Q3_untenlinks_kurz: Kollision mit Gitter | 0 mm^3 | 0.000 mm^3 | ✅ bestanden | ✅ bestanden |
| Bohrungen | Rueckrahmen Q3_untenlinks_kurz: Kleinste Bohrung | JLC3DP >= 1.5 mm | Durchgang M3 3,4 mm; Schluesselloch 4,6/9 mm | ✅ bestanden | ✅ bestanden |
| Geometrie | Rueckrahmen Q4_untenrechts_lang: Gueltiger Volumenkoerper | 1 gueltiger Solid | valid=True, solids=1 | ✅ bestanden | ✅ bestanden |
| Netz | Rueckrahmen Q4_untenrechts_lang: Geschlossen und mannigfaltig | solid, keine nicht-mannigfaltigen Kanten, keine Selbstdurchdringung | solid=True, nonmanifold=False, selfint=False | ✅ bestanden | ✅ bestanden |
| Bauraum | Rueckrahmen Q4_untenrechts_lang: Groesse in Druckorientierung | P1S <= 256^3; JLC3DP <= 250 x 250 x 300, >= 30 x 30 x 10 | 239.2 x 56.0 x 13.4 mm | ✅ bestanden | ✅ bestanden |
| Bauraum | Rueckrahmen Q4_untenrechts_lang: Flach auf dem Druckbett | Auflageflaeche > 20 cm^2 bei z = 0 | 127 cm^2 | ✅ bestanden | ✅ bestanden |
| Wandstaerke | Rueckrahmen Q4_untenrechts_lang: Duennste Wand (Strahlmessung, 1624 Punkte) | P1S >= 0.84 mm; JLC3DP >= 2.5 mm | 2.54 mm bei (369.9, -444.0, 2.3) | ✅ bestanden | ✅ bestanden |
| Passung | Rueckrahmen Q4_untenrechts_lang: Kollision mit Gitter | 0 mm^3 | 0.000 mm^3 | ✅ bestanden | ✅ bestanden |
| Bohrungen | Rueckrahmen Q4_untenrechts_lang: Kleinste Bohrung | JLC3DP >= 1.5 mm | Durchgang M3 3,4 mm; Schluesselloch 4,6/9 mm | ✅ bestanden | ✅ bestanden |
| Geometrie | Rueckrahmen Q4_untenrechts_kurz: Gueltiger Volumenkoerper | 1 gueltiger Solid | valid=True, solids=1 | ✅ bestanden | ✅ bestanden |
| Netz | Rueckrahmen Q4_untenrechts_kurz: Geschlossen und mannigfaltig | solid, keine nicht-mannigfaltigen Kanten, keine Selbstdurchdringung | solid=True, nonmanifold=False, selfint=False | ✅ bestanden | ✅ bestanden |
| Bauraum | Rueckrahmen Q4_untenrechts_kurz: Groesse in Druckorientierung | P1S <= 256^3; JLC3DP <= 250 x 250 x 300, >= 30 x 30 x 10 | 56.0 x 183.6 x 13.4 mm | ✅ bestanden | ✅ bestanden |
| Bauraum | Rueckrahmen Q4_untenrechts_kurz: Flach auf dem Druckbett | Auflageflaeche > 20 cm^2 bei z = 0 | 102 cm^2 | ✅ bestanden | ✅ bestanden |
| Wandstaerke | Rueckrahmen Q4_untenrechts_kurz: Duennste Wand (Strahlmessung, 1028 Punkte) | P1S >= 0.84 mm; JLC3DP >= 2.5 mm | 2.54 mm bei (442.8, -284.2, 2.3) | ✅ bestanden | ✅ bestanden |
| Passung | Rueckrahmen Q4_untenrechts_kurz: Kollision mit Gitter | 0 mm^3 | 0.000 mm^3 | ✅ bestanden | ✅ bestanden |
| Bohrungen | Rueckrahmen Q4_untenrechts_kurz: Kleinste Bohrung | JLC3DP >= 1.5 mm | Durchgang M3 3,4 mm; Schluesselloch 4,6/9 mm | ✅ bestanden | ✅ bestanden |
| Bauraum | Druckplatten P1S: Rueckrahmen_Druckplatte1_lange_Leisten.3mf | <= 256 x 256 mm | 240.4 x 239.0 x 13.4 mm, solid=True | ✅ bestanden | – |
| Bauraum | Druckplatten P1S: Rueckrahmen_Druckplatte2_kurze_Leisten.3mf | <= 256 x 256 mm | 183.6 x 239.0 x 13.4 mm, solid=True | ✅ bestanden | – |

## Hinweise und offene Punkte

- Druck: PLA, 0,4-mm-Duese, Gitter mit der Vorderseite (z = 25) auf dem Bett, Rueckrahmen mit der Wandseite auf dem Bett.

## Freigegebene Dateien

| Datei | SHA256 |
|---|---|
| `Rueckrahmen_Druckplatte1_lange_Leisten.3mf` | `4fffa3f2a7c0ab02…` |
| `Rueckrahmen_Druckplatte2_kurze_Leisten.3mf` | `cd0ee39d4455c04a…` |
| `Rueckrahmen_Q1_obenlinks_kurz.step` | `99528059c08c30a2…` |
| `Rueckrahmen_Q1_obenlinks_lang.step` | `600fd471a78d4eb7…` |
| `Rueckrahmen_Q2_obenrechts_kurz.step` | `e918c6035d7c9521…` |
| `Rueckrahmen_Q2_obenrechts_lang.step` | `7eed7f04a02f106d…` |
| `Rueckrahmen_Q3_untenlinks_kurz.step` | `e402e935e3c285b7…` |
| `Rueckrahmen_Q3_untenlinks_lang.step` | `f9db8c83b3353f21…` |
| `Rueckrahmen_Q4_untenrechts_kurz.step` | `460c64799af1df21…` |
| `Rueckrahmen_Q4_untenrechts_lang.step` | `87ab05c4ed5b20d8…` |

## Grundlage (Fertigerangaben, abgerufen 2026-11-07)

- [Bambu Lab P1S Spezifikation](https://wiki.bambulab.com/en/p1/manual/unboxing-p1s)
- [JLC3DP 3D Printing Design Guideline](https://jlc3dp.com/help/article/3D-Printing-Design-Guideline)
