rtreichl/Wordclock/01_Mechanic/Magnet_Positionen_Zusammenbau.csv

Nr | X_mm | Y_mm | Bohrung
1 | 58.04 | -16.79 | D3.2 x 6.1 tief
2 | 96.56 | -16.79 | D3.2 x 6.1 tief
3 | 173.59 | -16.79 | D3.2 x 6.1 tief
4 | 212.11 | -16.79 | D3.2 x 6.1 tief
5 | 289.15 | -16.79 | D3.2 x 6.1 tief
6 | 327.66 | -16.79 | D3.2 x 6.1 tief
7 | 404.70 | -16.79 | D3.2 x 6.1 tief
8 | 443.22 | -16.79 | D3.2 x 6.1 tief
9 | 58.04 | -483.21 | D3.2 x 6.1 tief
10 | 96.56 | -483.21 | D3.2 x 6.1 tief
11 | 173.59 | -483.21 | D3.2 x 6.1 tief
12 | 212.11 | -483.21 | D3.2 x 6.1 tief
13 | 289.15 | -483.21 | D3.2 x 6.1 tief
14 | 327.66 | -483.21 | D3.2 x 6.1 tief
15 | 404.70 | -483.21 | D3.2 x 6.1 tief
16 | 443.22 | -483.21 | D3.2 x 6.1 tief
17 | 16.79 | -57.98 | D3.2 x 6.1 tief
18 | 16.79 | -96.39 | D3.2 x 6.1 tief
19 | 16.79 | -173.19 | D3.2 x 6.1 tief
20 | 16.79 | -211.60 | D3.2 x 6.1 tief
21 | 16.79 | -288.40 | D3.2 x 6.1 tief
22 | 16.79 | -326.81 | D3.2 x 6.1 tief
23 | 16.79 | -403.61 | D3.2 x 6.1 tief
24 | 16.79 | -442.02 | D3.2 x 6.1 tief
25 | 483.84 | -57.98 | D3.2 x 6.1 tief
26 | 483.84 | -96.39 | D3.2 x 6.1 tief
27 | 483.84 | -173.19 | D3.2 x 6.1 tief
28 | 483.84 | -211.60 | D3.2 x 6.1 tief
29 | 483.84 | -288.40 | D3.2 x 6.1 tief
30 | 483.84 | -326.81 | D3.2 x 6.1 tief
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
