rtreichl/Wordclock/02_Electronics/LED_Sollpositionen_Zusammenbau.csv

Spalte | Zeile | X_mm | Y_mm
1 | 1 | 38.780 | -38.780
2 | 1 | 77.298 | -38.780
3 | 1 | 115.816 | -38.780
4 | 1 | 154.333 | -38.780
5 | 1 | 192.851 | -38.780
6 | 1 | 231.369 | -38.780
7 | 1 | 269.886 | -38.780
8 | 1 | 308.404 | -38.780
9 | 1 | 346.922 | -38.780
10 | 1 | 385.439 | -38.780
11 | 1 | 423.957 | -38.780
12 | 1 | 462.475 | -38.780
1 | 2 | 38.780 | -77.183
2 | 2 | 77.298 | -77.183
3 | 2 | 115.816 | -77.183
4 | 2 | 154.333 | -77.183
5 | 2 | 192.851 | -77.183
6 | 2 | 231.369 | -77.183
7 | 2 | 269.886 | -77.183
8 | 2 | 308.404 | -77.183
9 | 2 | 346.922 | -77.183
10 | 2 | 385.439 | -77.183
11 | 2 | 423.957 | -77.183
12 | 2 | 462.475 | -77.183
1 | 3 | 38.780 | -115.587
2 | 3 | 77.298 | -115.587
3 | 3 | 115.816 | -115.587
4 | 3 | 154.333 | -115.587
5 | 3 | 192.851 | -115.587
6 | 3 | 231.369 | -115.587
7 | 3 | 269.886 | -115.587
8 | 3 | 308.404 | -115.587
9 | 3 | 346.922 | -115.587
10 | 3 | 385.439 | -115.587
11 | 3 | 423.957 | -115.587
12 | 3 | 462.475 | -115.587
1 | 4 | 38.780 | -153.991
2 | 4 | 77.298 | -153.991
3 | 4 | 115.816 | -153.991
4 | 4 | 154.333 | -153.991
5 | 4 | 192.851 | -153.991
6 | 4 | 231.369 | -153.991
7 | 4 | 269.886 | -153.991
8 | 4 | 308.404 | -153.991
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
