rtreichl/Wordclock/02_Electronics/Bilder/Platine_3D_oben.png

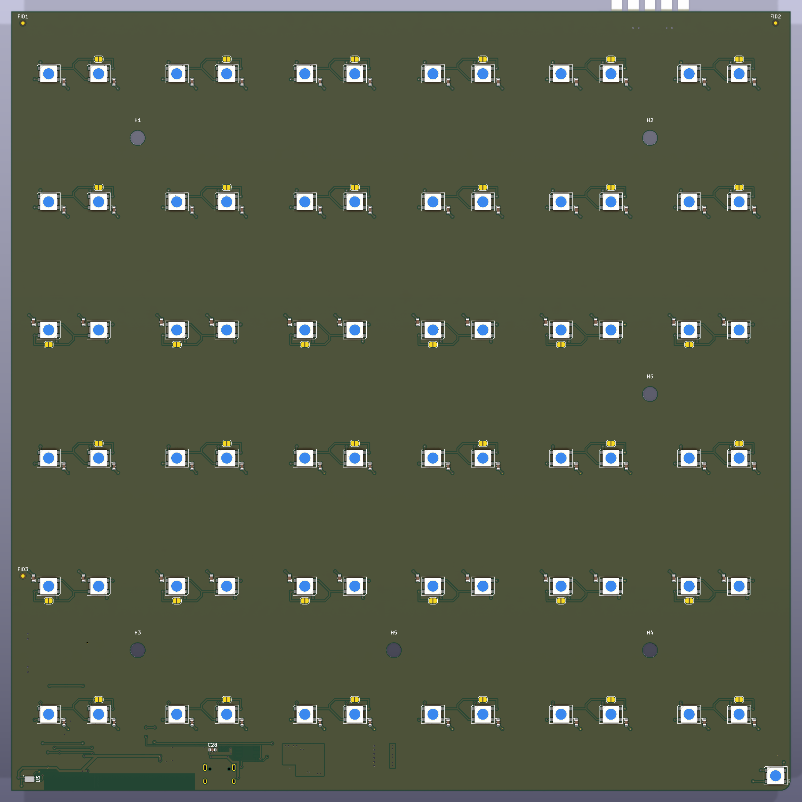
02_Electronics/Bilder/Platine_3D_oben.png
