rtreichl/Wordclock/02_Electronics/Bilder/Platine_3D_unten.png

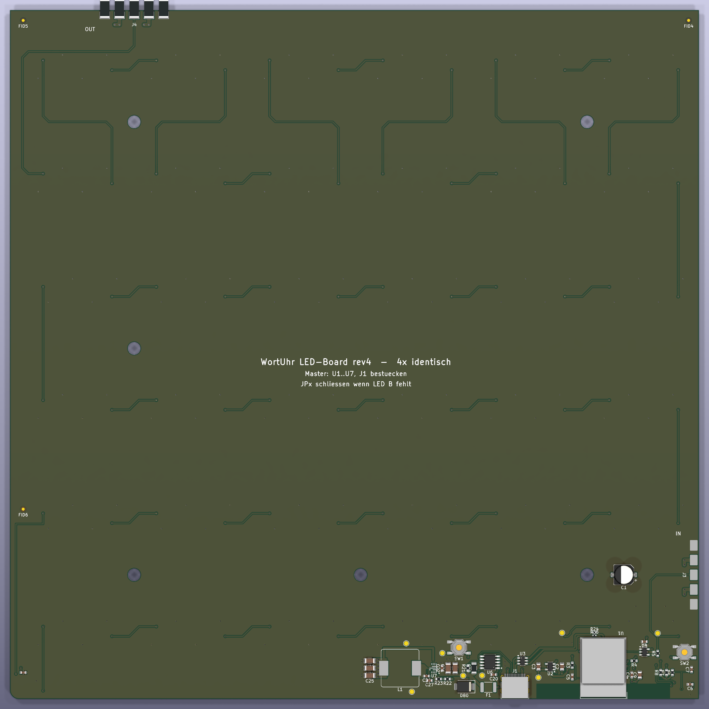
02_Electronics/Bilder/Platine_3D_unten.png
