rtreichl/Wordclock/02_Electronics/Bilder/Platzierung_Wandler_USB.png

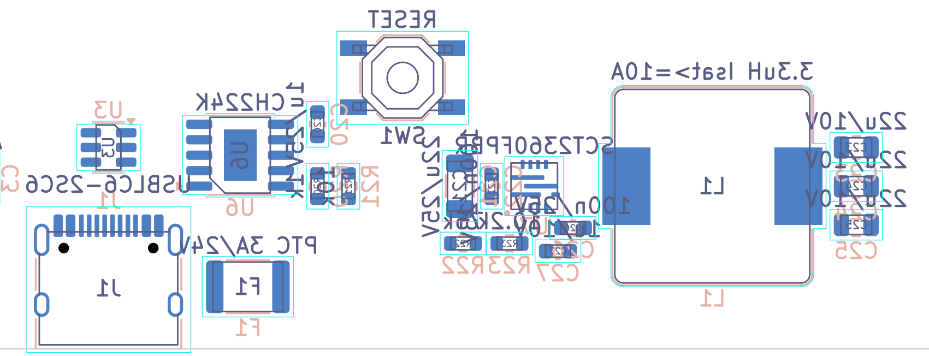
02_Electronics/Bilder/Platzierung_Wandler_USB.png
