rtreichl/Wordclock/02_Electronics/Bilder/Routing_Master_Oberseite.png

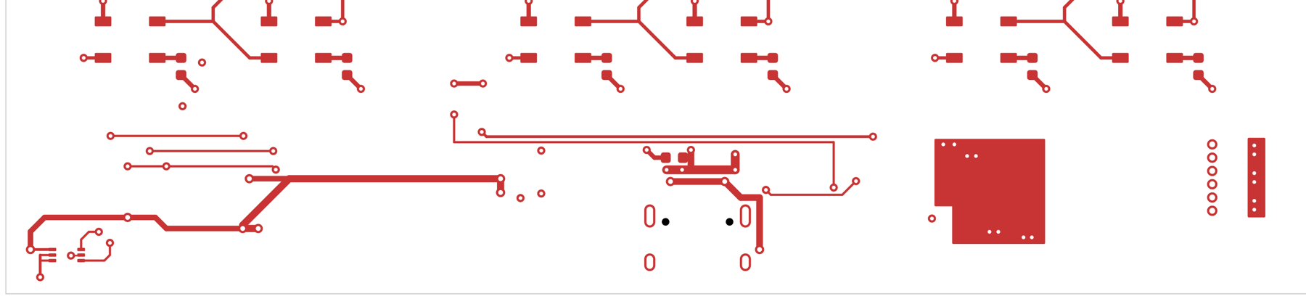
02_Electronics/Bilder/Routing_Master_Oberseite.png
