rtreichl/Wordclock/02_Electronics/Bilder/Routing_Master_Unterseite.png

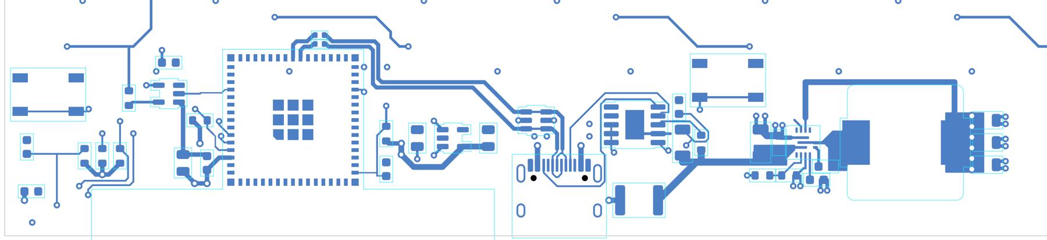
02_Electronics/Bilder/Routing_Master_Unterseite.png
