rtreichl/Wordclock/02_Electronics/Bilder/Routing_USB_Oberseite.png

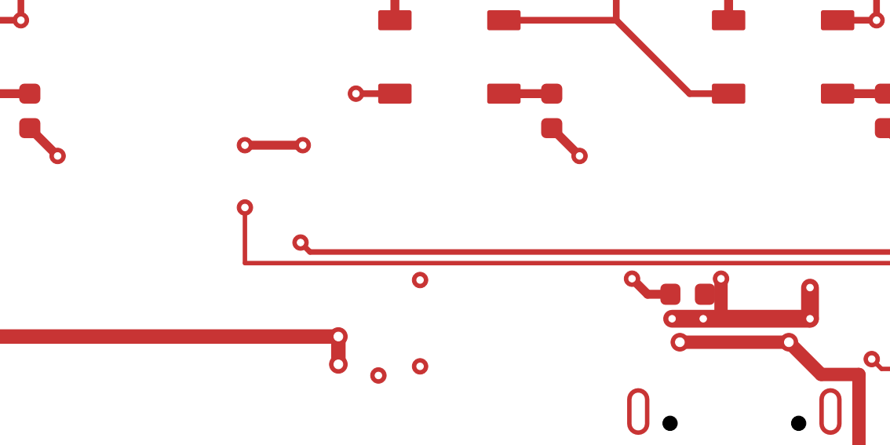
02_Electronics/Bilder/Routing_USB_Oberseite.png
