rtreichl/Wordclock/02_Electronics/Bilder/Routing_USB_Unterseite.png

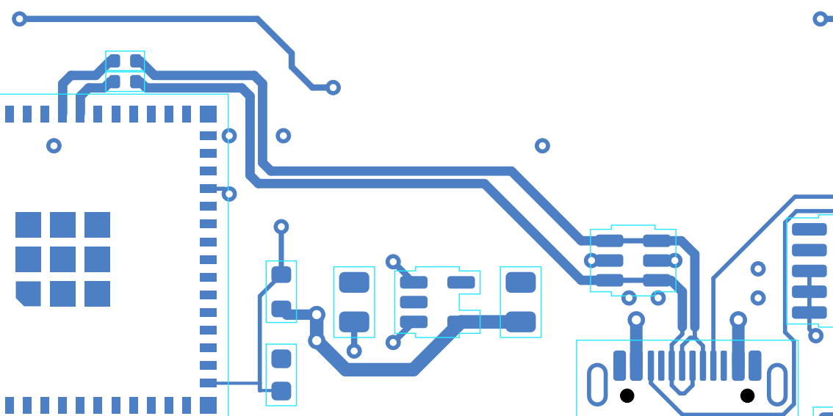
02_Electronics/Bilder/Routing_USB_Unterseite.png
