rtreichl/Wordclock/02_Electronics/Bilder/Routing_Wandler_Oberseite.png

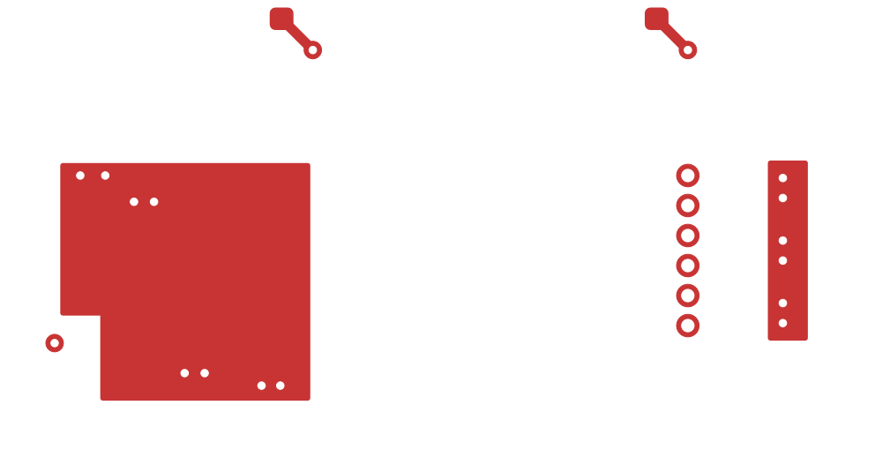
02_Electronics/Bilder/Routing_Wandler_Oberseite.png
