rtreichl/Wordclock/02_Electronics/Bilder/Routing_Wandler_Unterseite.png

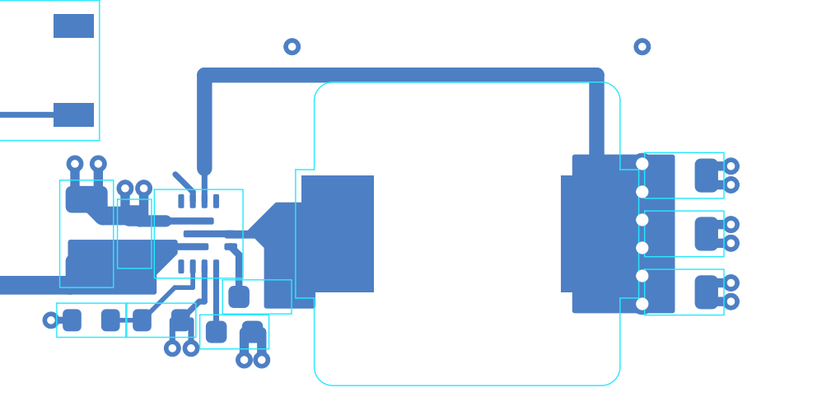
02_Electronics/Bilder/Routing_Wandler_Unterseite.png
