rtreichl/Wordclock/04_Rendering/WortUhr_angle.png

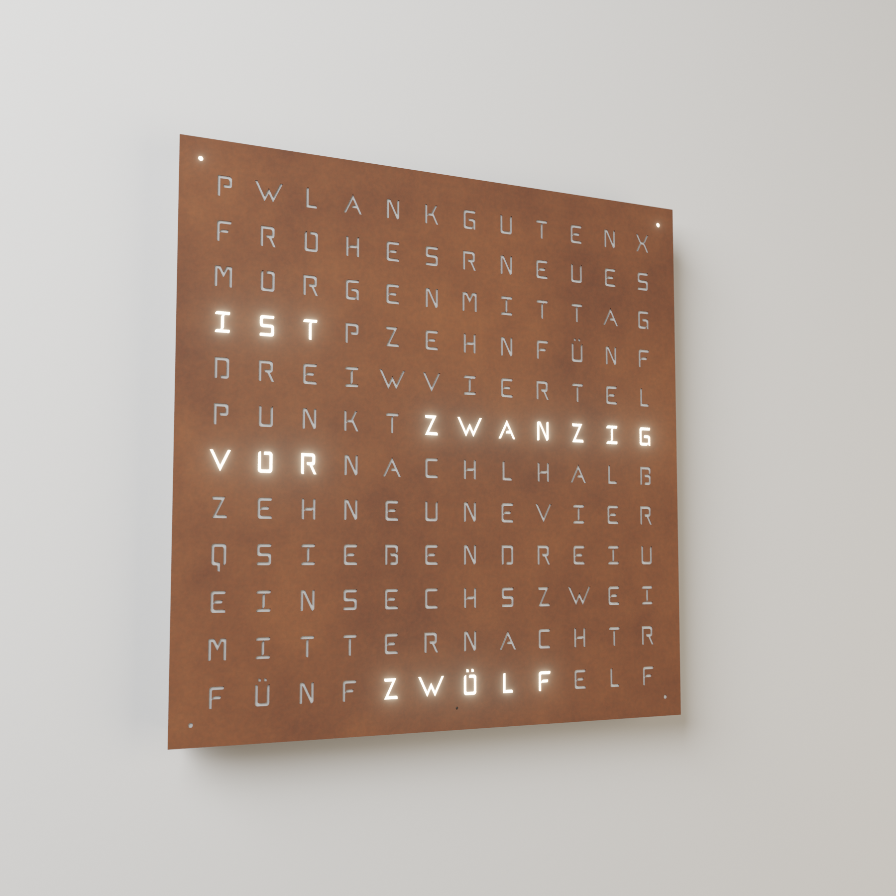
04_Rendering/WortUhr_angle.png
