rtreichl/Wordclock/04_Rendering/WortUhr_front.png

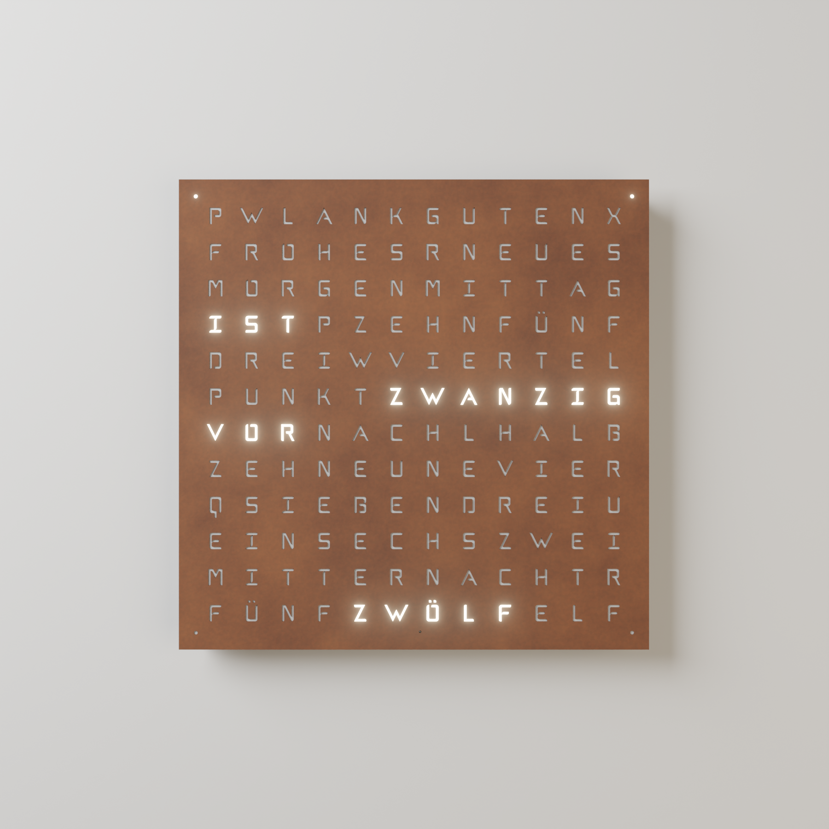
04_Rendering/WortUhr_front.png
