rtreichl/Wordclock/04_Rendering/WortUhr_front_blau_dunkel.png

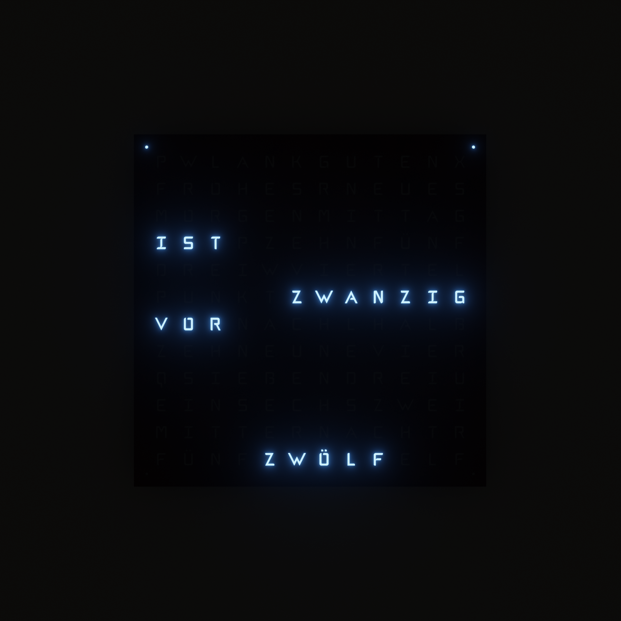
04_Rendering/WortUhr_front_blau_dunkel.png
