rtreichl/Wordclock/05_Production/05_Platine_JLCPCB/BOM_DigiKey.csv

Digi-Key Part Number | Manufacturer Part Number | Quantity | Customer Reference | Description
493-2165-1-ND | UWT1A101MCL1GB | 4 | C1 | 100u/10V CP_Elec_6.3x7.7
587-6025-1-ND | TMK212BBJ106MG-T | 2 | C2,C3 | 10u C_0805_2012Metric
399-C0603C104K5RACTUCT-ND | C0603C104K5RACTU | 296 | C4,C6,C8,C28,C101,C102,C103,C104,C105,C106,C107,C108,C109,C1 | 100n C_0603_1608Metric
399-C0603C105K3RACTUCT-ND | C0603C105K3RACTU | 2 | C5,C7 | 1u C_0603_1608Metric
399-C0805C226M8PACTUCT-ND | C0805C226M8PACTU | 1 | C9 | 22u/10V C_0805_2012Metric
399-C0603C105K3RACTUCT-ND | C0603C105K3RACTU | 1 | C20 | 1u/25V C_0603_1608Metric
311-3522-1-ND | CC1206MKX5R8BB226 | 5 | C21,C23,C24,C25,C29 | 22u/25V C_1206_3216Metric
399-C0603C104K5RACTUCT-ND | C0603C104K5RACTU | 2 | C22,C26 | 100n/25V C_0603_1608Metric
399-C0603C105K3RACTUCT-ND | C0603C105K3RACTU | 1 | C27 | 1u/10V C_0603_1608Metric
18-1812L300/24SLERCT-ND | 1812L300/24SLER | 1 | F1 | 1812L300/24SLER Fuse_1812_4532Metric
SRP1265A-3R3MCT-ND | SRP1265A-3R3M | 1 | L1 | SRP1265A-3R3M L_Bourns_SRP1245A
P10.0KHCT-ND | ERJ-3EKF1002V | 3 | R3,R4,R21 | 10k R_0603_1608Metric
P33.0HCT-ND | ERJ-3EKF33R0V | 1 | R5 | 33 R_0603_1608Metric
P1.00KHCT-ND | ERJ-3EKF1001V | 1 | R6 | 1k R_0603_1608Metric
P4.70KHCT-ND | ERJ-3EKF4701V | 2 | R7,R8 | 4k7 R_0603_1608Metric
311-1.00KFRCT-ND | RC1206FR-071KL | 1 | R20 | 1k R_1206_3216Metric
P75.0KHCT-ND | ERJ-3EKF7502V | 1 | R22 | 75k R_0603_1608Metric
P10.2KHCT-ND | ERJ-3EKF1022V | 1 | R23 | 10.2k R_0603_1608Metric
P22.0LCT-ND | ERJ-2RKF22R0X | 2 | R24,R25 | 22 R_0402_1005Metric
EG2531CT-ND | TL3342F160QG/TR | 1 | SW1 | RESET SW_SPST_TL3342
EG2531CT-ND | TL3342F160QG/TR | 1 | SW2 | BOOT SW_SPST_TL3342
5407-ESP32-S3-MINI-1-N8CT-ND | ESP32-S3-MINI-1-N8 | 1 | U1 | ESP32-S3-MINI-1-N8 ESP32-S2-MINI-1
AP2112K-3.3TRG1DICT-ND | AP2112K-3.3TRG1 | 1 | U2 | AP2112K-3.3 SOT-23-5
497-5235-1-ND | USBLC6-2SC6 | 1 | U3 | USBLC6-2SC6 SOT-23-6
296-4708-1-ND | SN74AHCT1G125DBVR | 1 | U4 | 74AHCT1G125 SOT-23-5
BH1750FVICT-ND | BH1750FVI-TR | 1 | U5 | BH1750FVI WSOF6I_BH1750
