rtreichl/Wordclock/05_Production/05_Platine_JLCPCB/BOM_Master.csv

Comment | Designator | Footprint | Quantity | LCSC Part #
100u/10V | C1 | CP_Elec_6.3x7.7 | 1
10u | C2,C3 | C_0805_2012Metric | 2
100n | C4,C6,C8,C28,C101,C102,C103,C104,C105,C106,C107,C108,C109,C110,C111,C112,C113,C114,C115,C116,C117,C118,C119,C120,C121,C122,C123,C124,C125,C126,C127,C128,C129,C130,C131,C132,C133,C134,C135,C136,C137,C138,C139,C140,C141,C142,C143,C144,C145,C146,C147,C148,C149,C150,C151,C152,C153,C154,C155,C156,C157,C158,C159,C160,C161,C162,C163,C164,C165,C166,C167,C168,C169,C170,C171,C172,C175 | C_0603_1608Metric | 77
1u | C5,C7 | C_0603_1608Metric | 2
22u/10V | C9 | C_0805_2012Metric | 1
1u/25V | C20 | C_0603_1608Metric | 1
22u/25V | C21,C23,C24,C25,C29 | C_1206_3216Metric | 5
100n/25V | C22,C26 | C_0603_1608Metric | 2
1u/10V | C27 | C_0603_1608Metric | 1
SK6812RGBW | D1,D2,D3,D4,D5,D6,D7,D8,D9,D10,D11,D12,D13,D14,D15,D16,D17,D18,D19,D20,D21,D22,D23,D24,D25,D26,D27,D28,D29,D30,D31,D32,D33,D34,D35,D36,D37,D38,D39,D40,D41,D42,D43,D44,D45,D46,D47,D48,D49,D50,D51,D52,D53,D54,D55,D56,D57,D58,D59,D60,D61,D62,D63,D64,D65,D66,D67,D68,D69,D70,D71,D72,D75 | LED_WS2812B_PLCC4_5.0x5.0mm_P3.2mm | 73
SMBJ16A | D80 | D_SMB | 1
1812L300/24SLER | F1 | Fuse_1812_4532Metric | 1
USB-C | J1 | USB_C_Receptacle_HRO_TYPE-C-31-M-12 | 1 | C165948
SRP1265A-3R3M | L1 | L_Bourns_SRP1245A | 1 | C1329348
10k | R3,R4,R21 | R_0603_1608Metric | 3
33 | R5 | R_0603_1608Metric | 1
1k | R6 | R_0603_1608Metric | 1
4k7 | R7,R8 | R_0603_1608Metric | 2
1k | R20 | R_1206_3216Metric | 1
75k | R22 | R_0603_1608Metric | 1
10.2k | R23 | R_0603_1608Metric | 1
22 | R24,R25 | R_0402_1005Metric | 2
RESET | SW1 | SW_SPST_TL3342 | 1
BOOT | SW2 | SW_SPST_TL3342 | 1
ESP32-S3-MINI-1-N8 | U1 | ESP32-S2-MINI-1 | 1
AP2112K-3.3 | U2 | SOT-23-5 | 1 | C51118
USBLC6-2SC6 | U3 | SOT-23-6 | 1 | C7519
74AHCT1G125 | U4 | SOT-23-5 | 1
BH1750FVI | U5 | WSOF6I_BH1750 | 1
CH224K | U6 | SSOP-10-1EP_3.9x4.9mm_P1mm_EP2.1x3.3mm | 1 | C970725
SCT2360FPBR | U7 | QFN-12_SCT2360 | 1 | C2693821
