rtreichl/Wordclock/05_Production/05_Platine_JLCPCB/BOM_Separat_Beschaffung.csv

Manufacturer Part Number | Quantity | Reference | Description | LCSC
SMBJ16A | 1 | D80 | SMBJ16A D_SMB
TYPE-C-31-M-12 | 1 | J1 | USB-C USB_C_Receptacle_HRO_TYPE-C-31-M-12 | C165948
CH224K | 1 | U6 | CH224K SSOP-10-1EP_3.9x4.9mm_P1mm_EP2.1x3.3mm | C970725
SCT2360FPBR | 1 | U7 | SCT2360FPBR QFN-12_SCT2360 | C2693821
