rtreichl/Wordclock/00_Design/Frontplatte-500mm-Sencilla.dxf

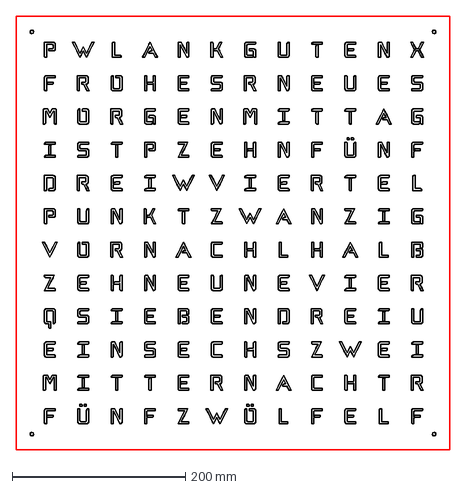
[picture p15: CAD file, 2026-11-08]
00_Design/Frontplatte-500mm-Sencilla.dxf
500.0 x 500.0 mm
