rtreichl/Wordclock/01_Mechanic/Diffusor/Diffusor_Minutenpunkt_D5.6x2.step

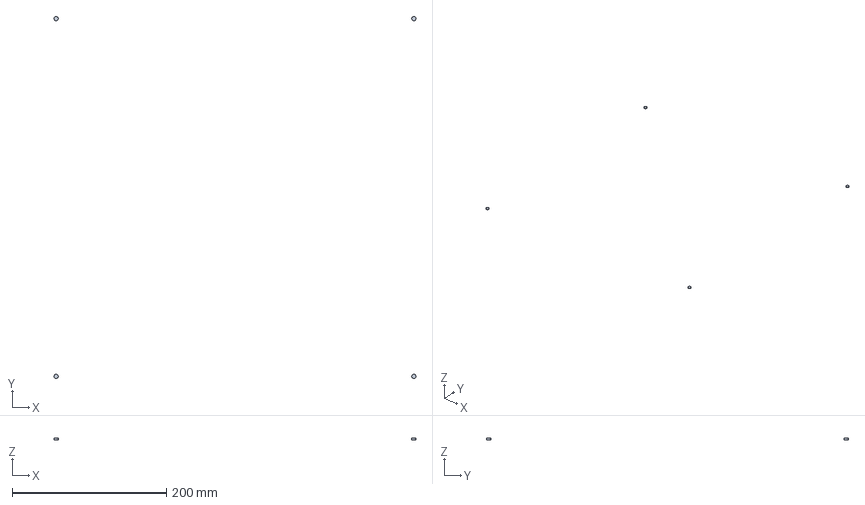
[picture p16: CAD file, 2026-11-08]
01_Mechanic/Diffusor/Diffusor_Minutenpunkt_D5.6x2.step
469.6 x 469.6 x 2.00 mm
