rtreichl/Wordclock/01_Mechanic/FrontPlatte-Bestellung.FCStd

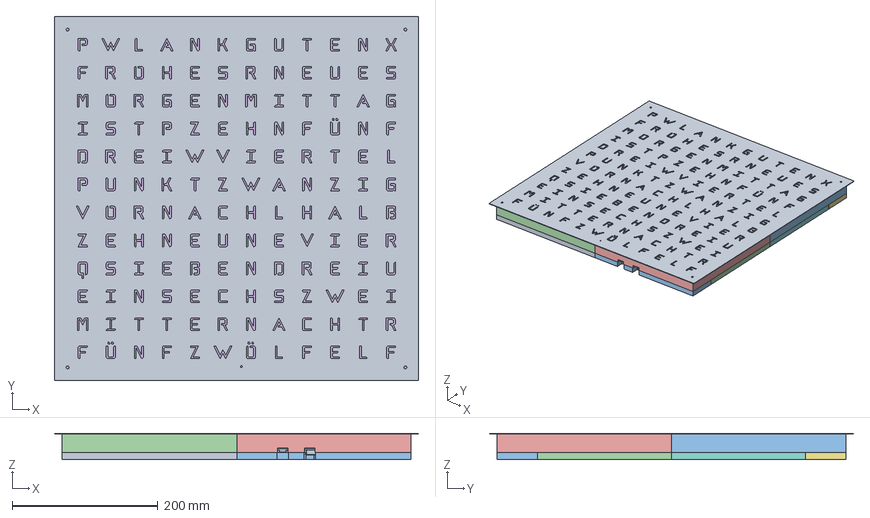
[picture p17: CAD file, 2026-11-10]
01_Mechanic/FrontPlatte-Bestellung.FCStd
500.0 x 500.0 x 36.0 mm
Frontplatte_1mm
Gitter_Q1_obenlinks
Gitter_Q2_obenrechts
Gitter_Q3_untenlinks
Gitter_Q4_untenrechts
Diffusor_144x_30x30x2
Magnete_48x_3x6
Lichtleiter_Mentor_1282.1000
PCB_Q4_Master
PCB_Q2
PCB_Q1
PCB_Q3
Rueckrahmen_Q1_obenlinks_lang
Rueckrahmen_Q1_obenlinks_kurz
Rueckrahmen_Q2_obenrechts_lang
Rueckrahmen_Q2_obenrechts_kurz
Rueckrahmen_Q3_untenlinks_lang
Rueckrahmen_Q3_untenlinks_kurz
Rueckrahmen_Q4_untenrechts_lang
Rueckrahmen_Q4_untenrechts_kurz
Diffusor_Minuten
