rtreichl/Wordclock/01_Mechanic/Frontplatte/Frontplatte_1mm_mit_Lichtleiter.dxf

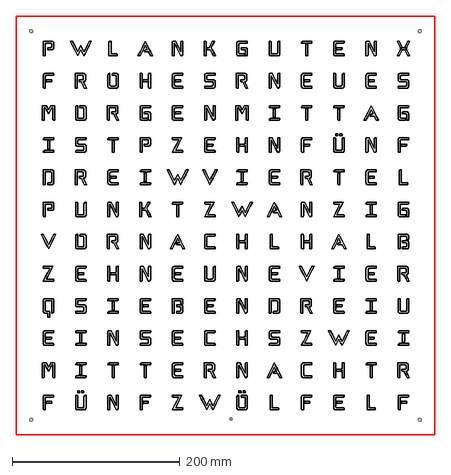
[picture p18: CAD file, 2026-11-08]
01_Mechanic/Frontplatte/Frontplatte_1mm_mit_Lichtleiter.dxf
500.0 x 500.0 mm
