rtreichl/Wordclock/01_Mechanic/Gitter/Gitter_Q2_obenrechts_druckfertig.3mf

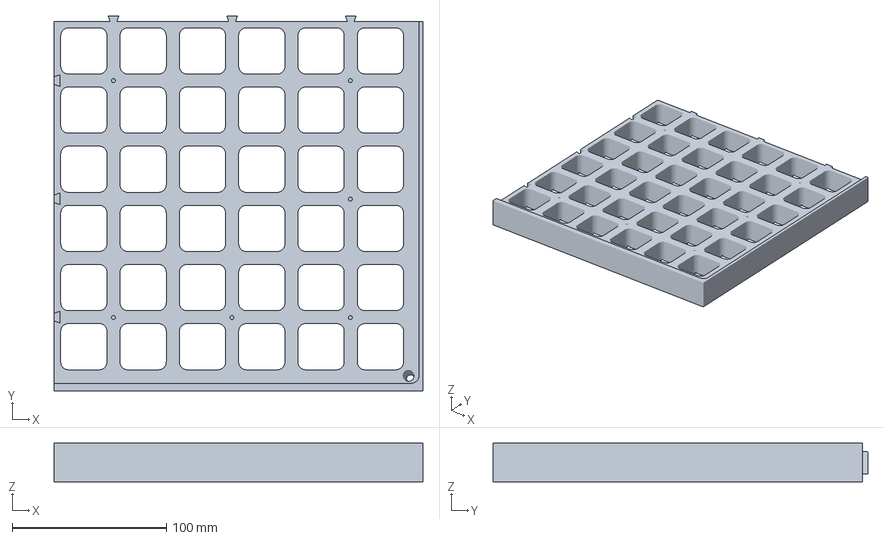
[picture p19: CAD file, 2026-11-08]
01_Mechanic/Gitter/Gitter_Q2_obenrechts_druckfertig.3mf
239.4 x 243.5 x 25.0 mm
