rtreichl/Wordclock/01_Mechanic/Rueckrahmen/Rueckrahmen_Q4_untenrechts_lang.step

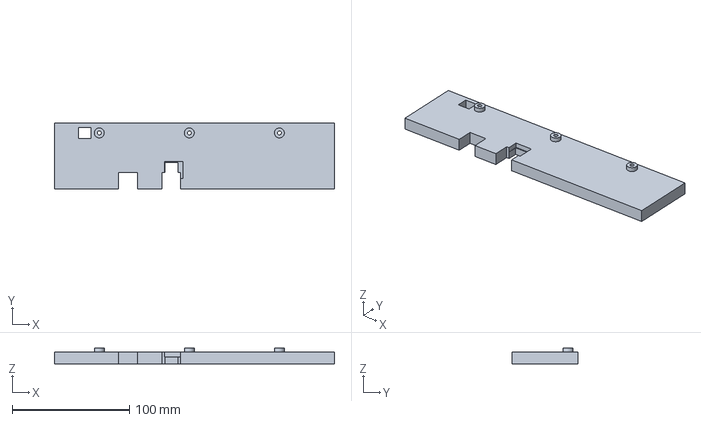
[picture p20: CAD file, 2026-11-09]
01_Mechanic/Rueckrahmen/Rueckrahmen_Q4_untenrechts_lang.step
239.2 x 56.0 x 13.4 mm
