rtreichl/Wordclock/02_Electronics/KiCad/3dmodels/ESP32-S3-MINI-1_Platzhalter.step

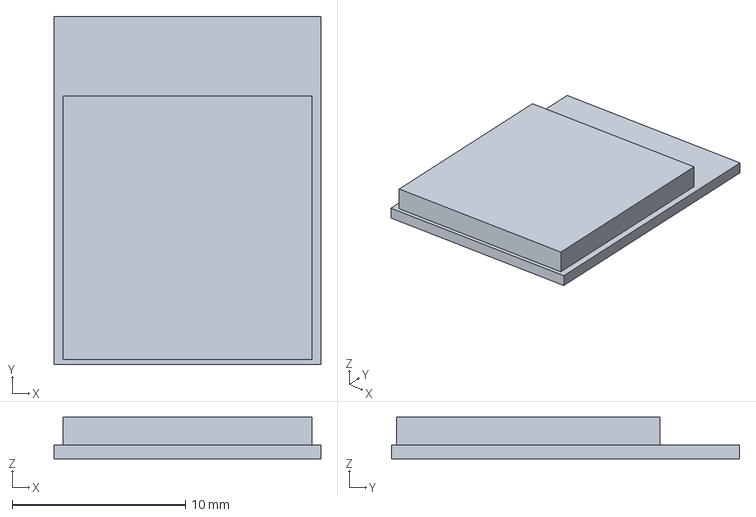
[picture p21: CAD file, 2026-11-07]
02_Electronics/KiCad/3dmodels/ESP32-S3-MINI-1_Platzhalter.step
15.4 x 20.1 x 2.40 mm
