rtreichl/Wordclock/04_Rendering/meshes/pcb_PCB_Q2.stl

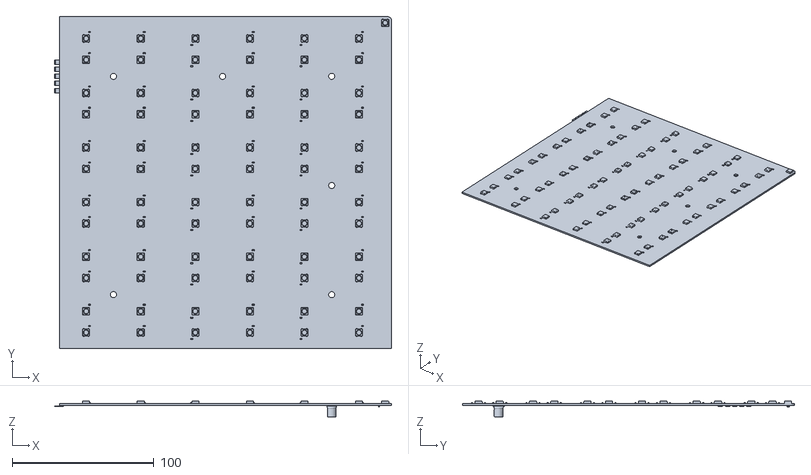
[picture p22: CAD file, 2026-11-10]
04_Rendering/meshes/pcb_PCB_Q2.stl
237.7 x 234.0 x 11.0
