rtreichl/Wordclock/05_Production/01_Frontplatte_Laser/Frontplatte_Corten_1mm_R12.dxf

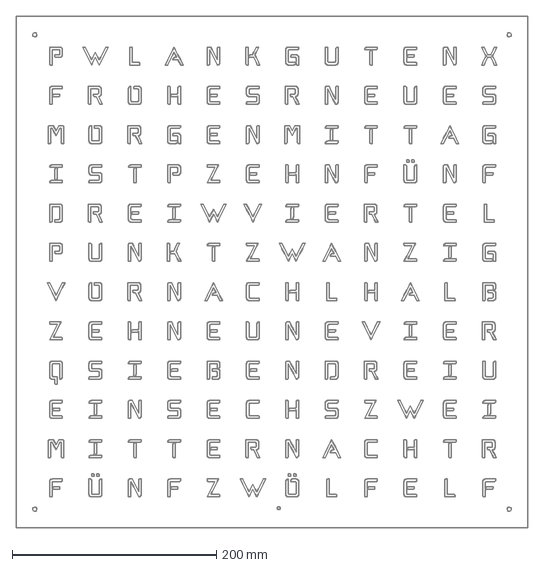
[picture p23: CAD file, 2026-11-08]
05_Production/01_Frontplatte_Laser/Frontplatte_Corten_1mm_R12.dxf
500.0 x 500.0 mm
