rtreichl/Wordclock/05_Production/02_Diffusor_Laser/Diffusor_Minutenpunkt_D5.6_R12.dxf

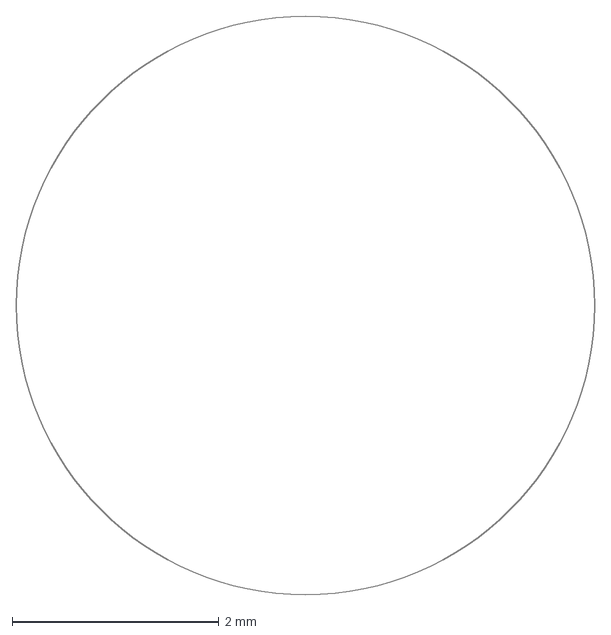
[picture p24: CAD file, 2026-11-08]
05_Production/02_Diffusor_Laser/Diffusor_Minutenpunkt_D5.6_R12.dxf
5.60 x 5.60 mm
