rtreichl/Wordclock/05_Production/04_Rueckrahmen_3D-Druck/Rueckrahmen_Druckplatte1_lange_Leisten.3mf

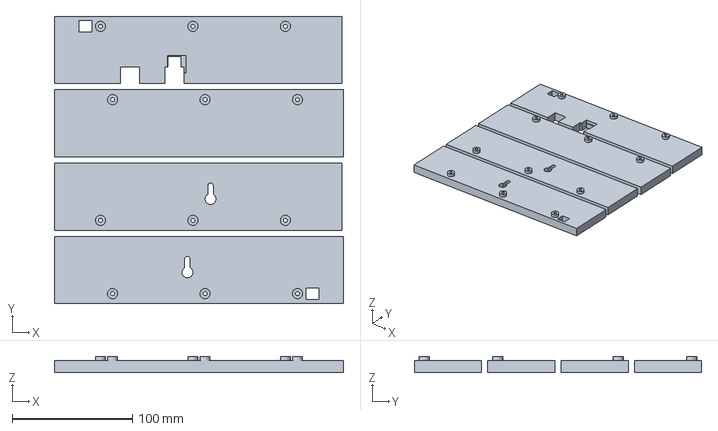
[picture p25: CAD file, 2026-11-09]
05_Production/04_Rueckrahmen_3D-Druck/Rueckrahmen_Druckplatte1_lange_Leisten.3mf
240.4 x 239.0 x 13.4 mm
