rtreichl/Wordclock/Export/Diffusor_35x35.dxf

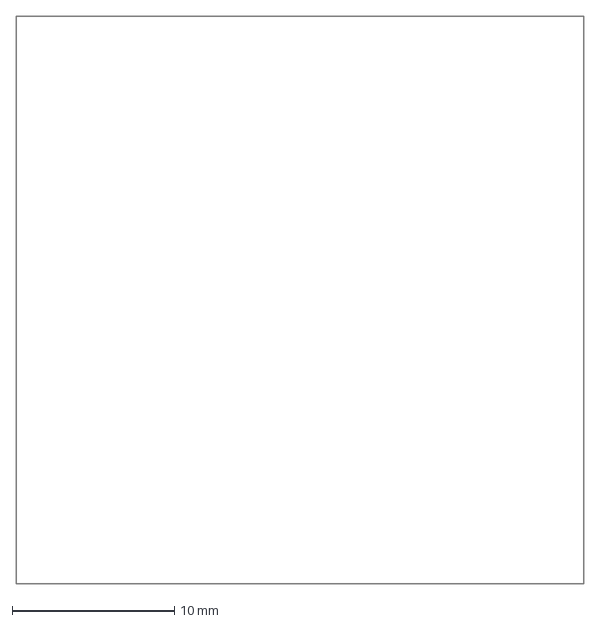
[picture p26: CAD file, 2026-11-07]
Export/Diffusor_35x35.dxf
35.0 x 35.0 mm
