rtreichl/Wordclock/Unbenannt-Slice001.3.step

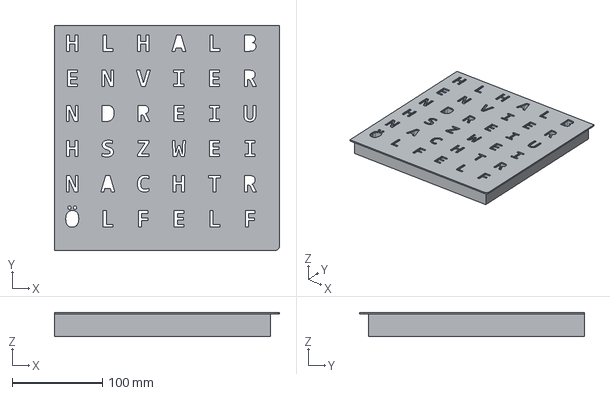
[picture p27: CAD file, 2026-11-07]
Unbenannt-Slice001.3.step
250.0 x 250.0 x 27.0 mm
