rtreichl/Wordclock/01_Mechanic/Diffusor/Diffusor_30x30x2.step

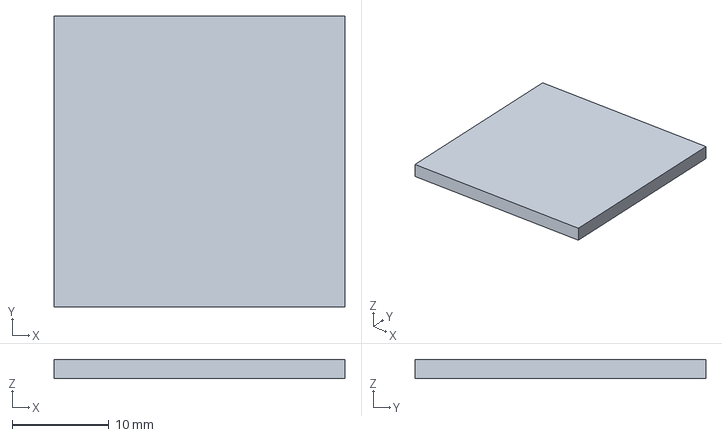
[picture p28: CAD file, 2026-11-07]
01_Mechanic/Diffusor/Diffusor_30x30x2.step
30.0 x 30.0 x 2.00 mm
