rtreichl/Wordclock/01_Mechanic/Frontplatte/Frontplatte_1mm.step

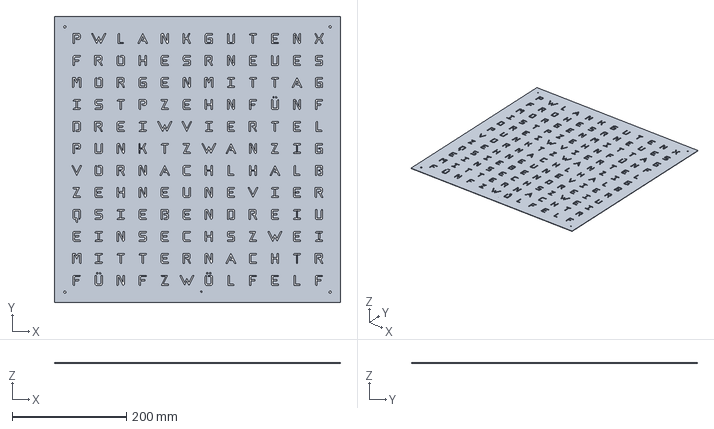
[picture p29: CAD file, 2026-11-08]
01_Mechanic/Frontplatte/Frontplatte_1mm.step
500.0 x 500.0 x 1.00 mm
