rtreichl/Wordclock/02_Electronics/KiCad/3dmodels/BH1750_WSOF6I_Platzhalter.step

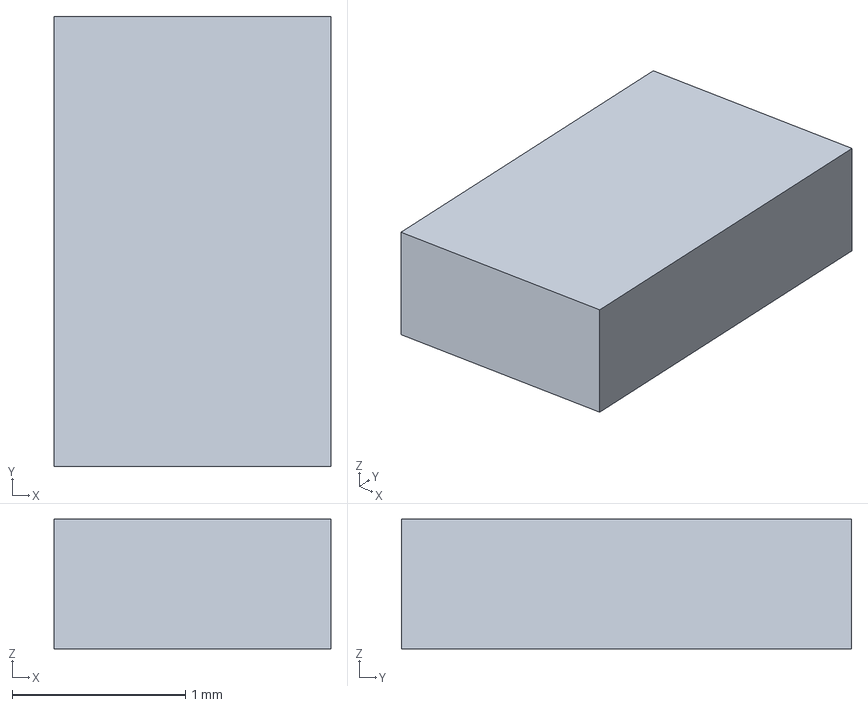
[picture p30: CAD file, 2026-11-07]
02_Electronics/KiCad/3dmodels/BH1750_WSOF6I_Platzhalter.step
1.60 x 2.60 x 0.75 mm
