rtreichl/Wordclock/05_Production/02_Diffusor_Laser/Diffusor_30x30_R12.dxf

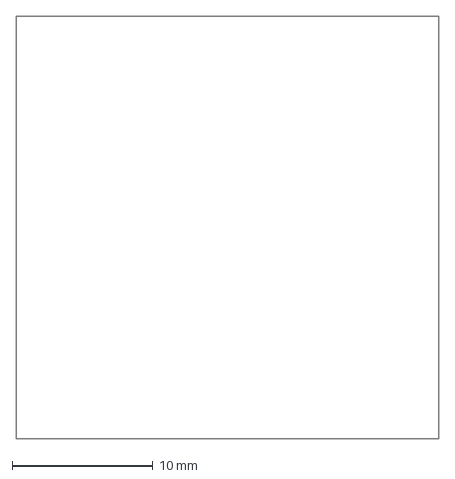
[picture p31: CAD file, 2026-11-08]
05_Production/02_Diffusor_Laser/Diffusor_30x30_R12.dxf
30.0 x 30.0 mm
