rtreichl/Wordclock/Export/Diffusor_35x35x2.step

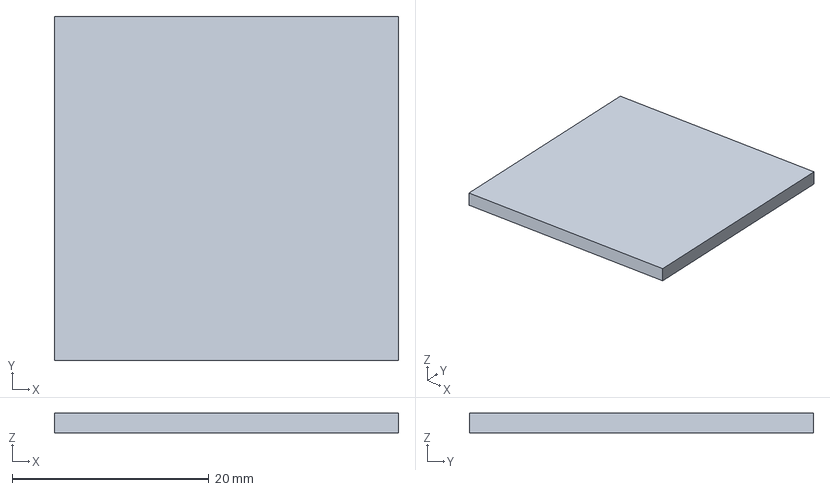
[picture p32: CAD file, 2026-11-07]
Export/Diffusor_35x35x2.step
35.0 x 35.0 x 2.00 mm
