rtreichl/Wordclock/Unbenannt.FCStd

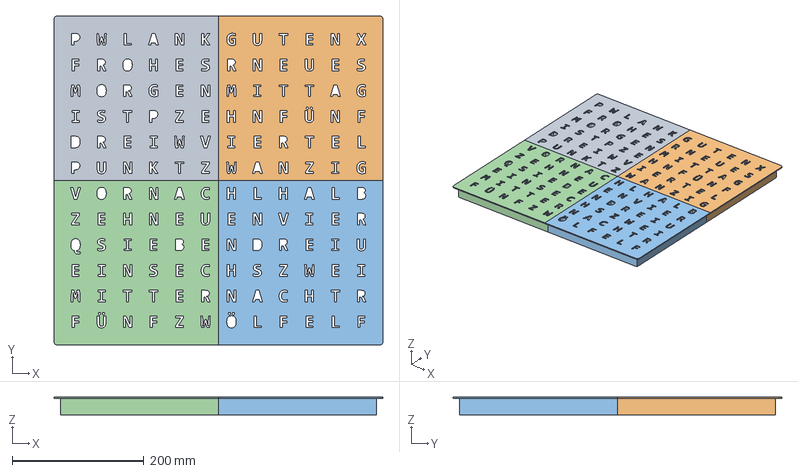
[picture p33: CAD file, 2026-11-07]
Unbenannt.FCStd
500.0 x 500.0 x 27.0 mm
Körper
Körper001
Körper002
Körper003
