rtreichl/Wordclock/01_Mechanic/Diffusor/Diffusor_30x30.dxf

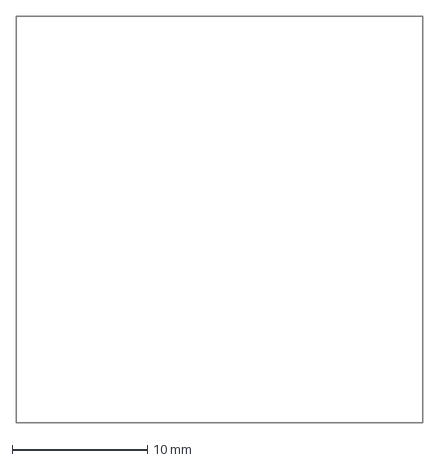
[picture p34: CAD file, 2026-11-07]
01_Mechanic/Diffusor/Diffusor_30x30.dxf
30.0 x 30.0 mm
