rtreichl/Wordclock/02_Electronics/KiCad/3dmodels/USB_C_HRO_TYPE-C-31-M-12_Platzhalter.step

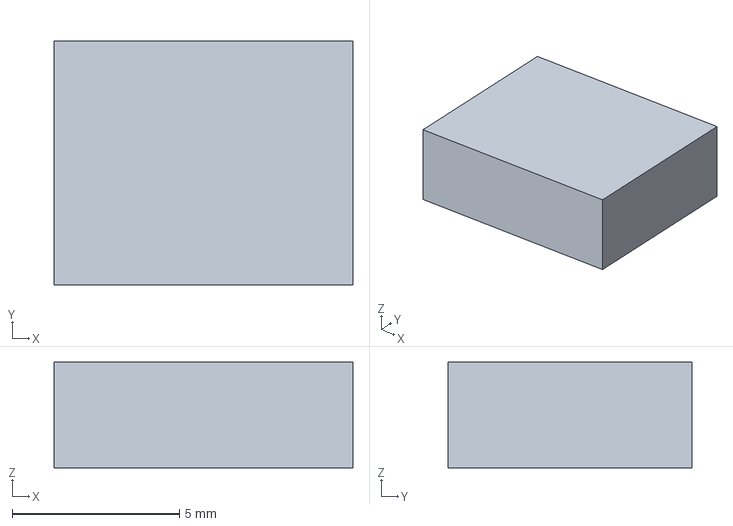
[picture p35: CAD file, 2026-11-07]
02_Electronics/KiCad/3dmodels/USB_C_HRO_TYPE-C-31-M-12_Platzhalter.step
8.94 x 7.30 x 3.16 mm
