rtreichl/Wordclock/05_Production/04_Rueckrahmen_3D-Druck/Rueckrahmen_Q2_obenrechts_kurz.step

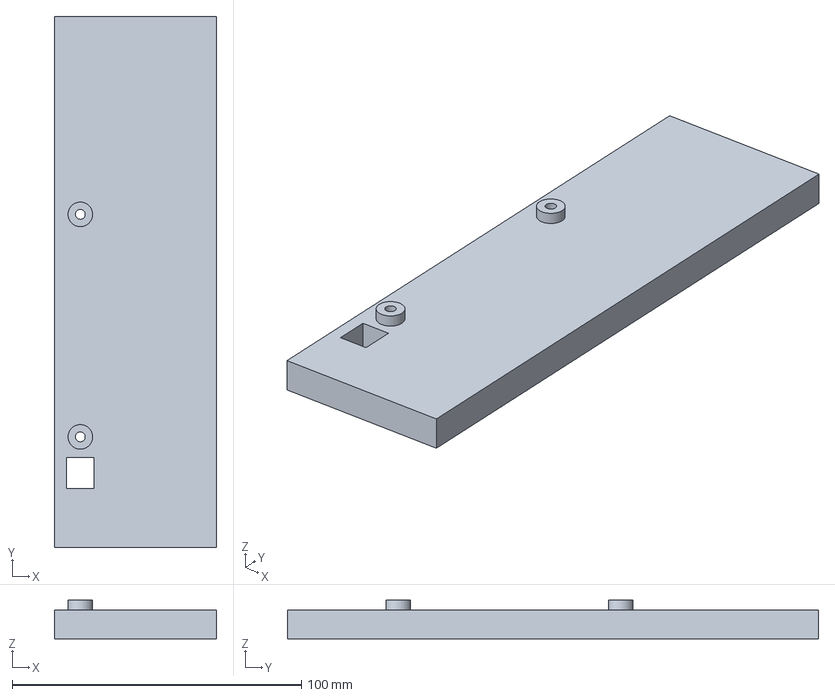
[picture p36: CAD file, 2026-11-07]
05_Production/04_Rueckrahmen_3D-Druck/Rueckrahmen_Q2_obenrechts_kurz.step
56.0 x 183.6 x 13.4 mm
