rtreichl/Wordclock/04_Rendering/meshes/rueckrahmen.stl

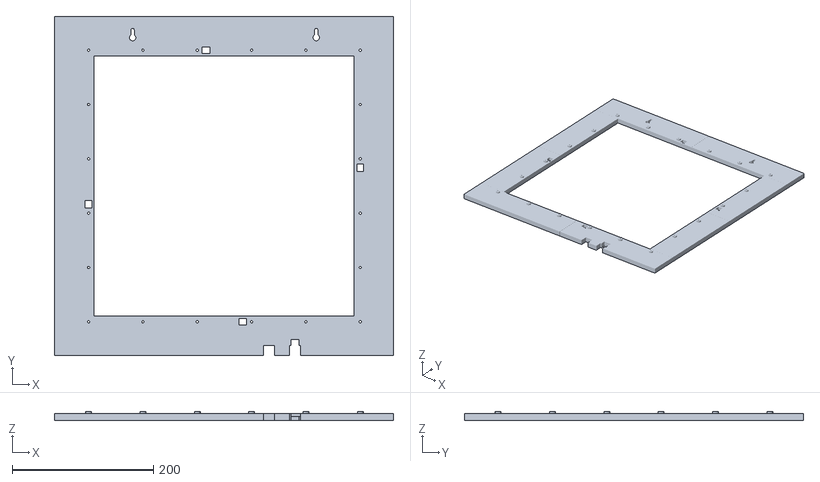
[picture p37: CAD file, 2026-11-10]
04_Rendering/meshes/rueckrahmen.stl
480.0 x 480.0 x 13.5
