rtreichl/Wordclock/05_Production/04_Rueckrahmen_3D-Druck/Rueckrahmen_Q1_obenlinks_lang.step

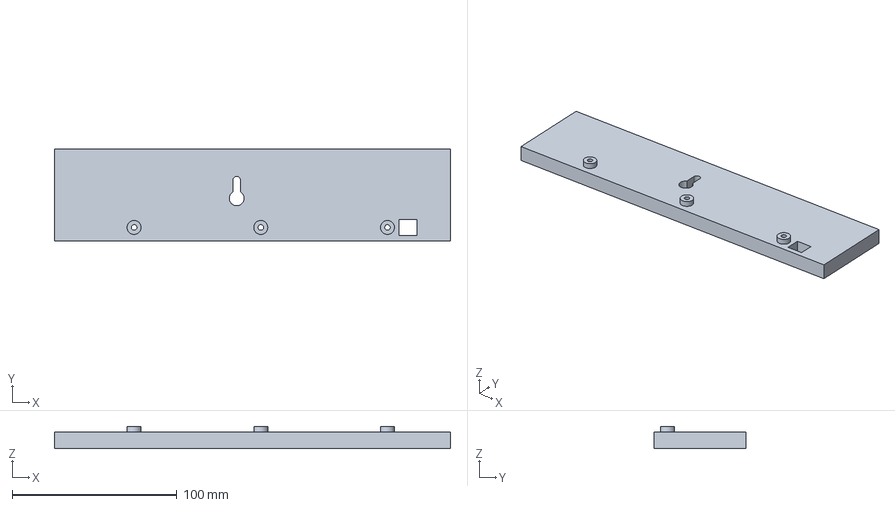
[picture p38: CAD file, 2026-11-07]
05_Production/04_Rueckrahmen_3D-Druck/Rueckrahmen_Q1_obenlinks_lang.step
240.4 x 56.0 x 13.4 mm
