rtreichl/Wordclock/FrontPlatte.FCStd

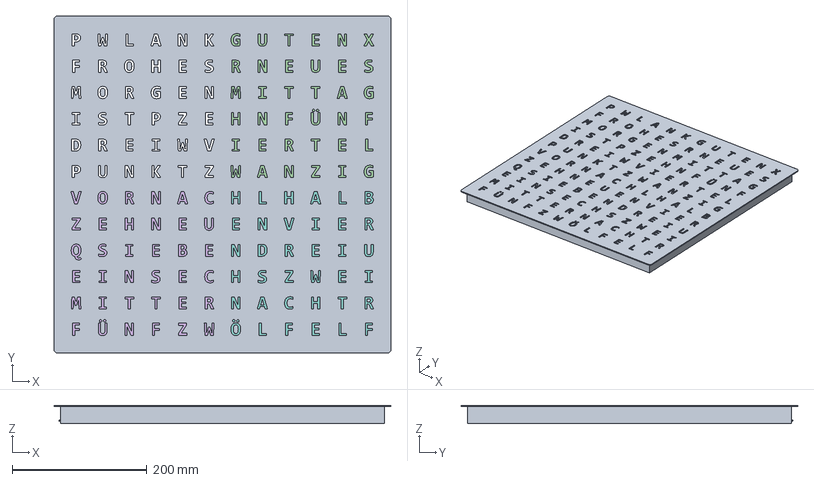
[picture p39: CAD file, 2026-11-07]
FrontPlatte.FCStd
500.0 x 500.0 x 27.0 mm
Körper
LED_WS2812B_PLCC4_5.0x5.0mm_P3.2mm
LED_WS2812B_PLCC4_5.0x5.0mm_P3.2mm003
WortUhr_PCB001
LED_WS2812B_PLCC4_5.0x5.0mm_P3.2mm005
WortUhr_PCB002
LED_WS2812B_PLCC4_5.0x5.0mm_P3.2mm007
WortUhr_PCB003
