rtreichl/Wordclock/FrontPlatte-Körper.step

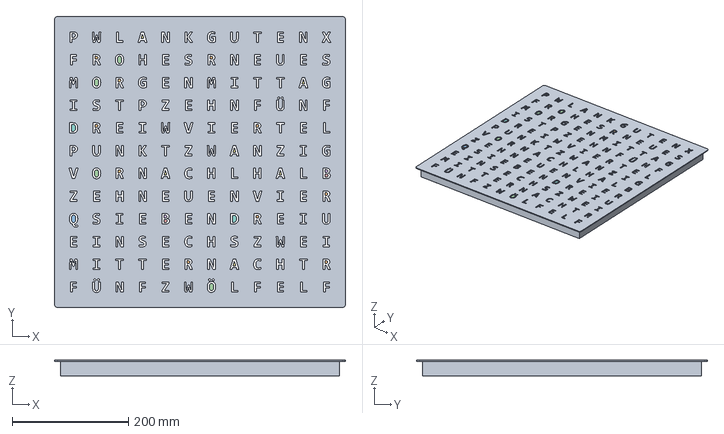
[picture p41: CAD file, 2026-11-07]
FrontPlatte-Körper.step
500.0 x 500.0 x 27.0 mm
