rtreichl/Wordclock/05_Production/04_Rueckrahmen_3D-Druck/Rueckrahmen_Druckplatte2_kurze_Leisten.3mf

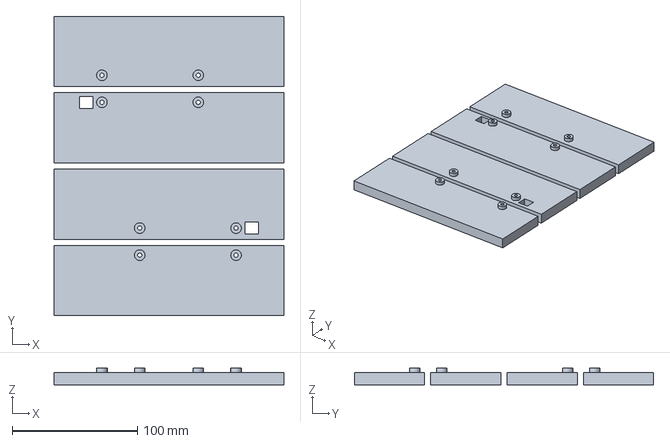
[picture p42: CAD file, 2026-11-07]
05_Production/04_Rueckrahmen_3D-Druck/Rueckrahmen_Druckplatte2_kurze_Leisten.3mf
183.6 x 239.0 x 13.4 mm
