rtreichl/Wordclock/04_Rendering/meshes/diffusor_an.stl

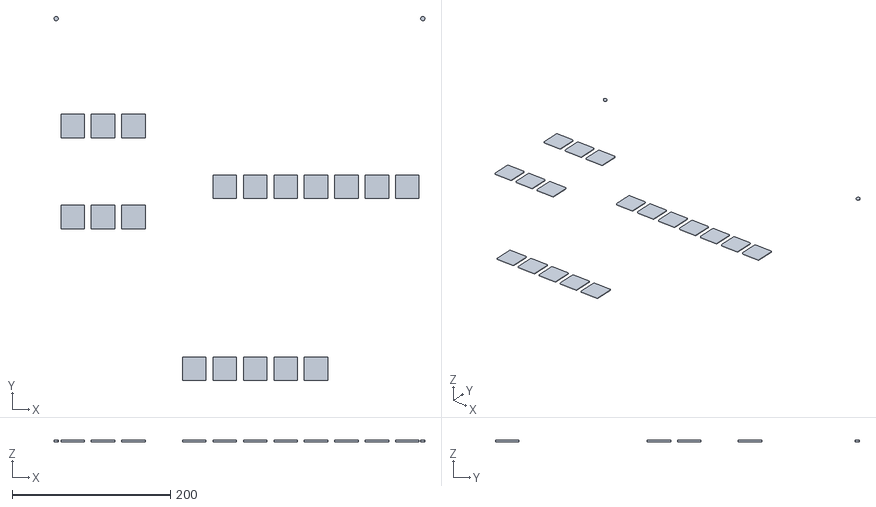
[picture p43: CAD file, 2026-11-08]
04_Rendering/meshes/diffusor_an.stl
469.6 x 461.0 x 2.00
