rtreichl/Wordclock/04_Rendering/meshes/lichtleiter.stl

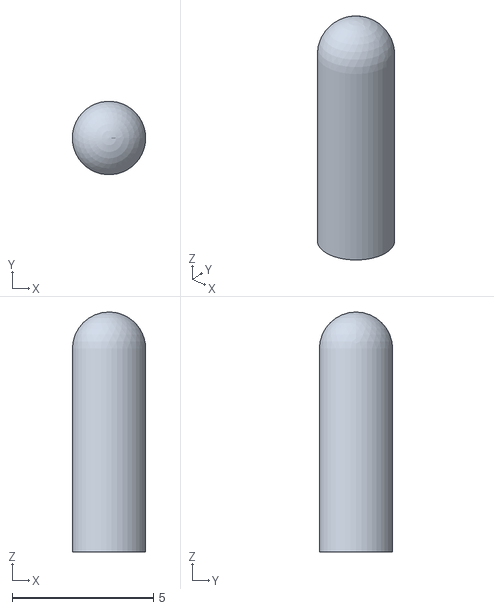
[picture p44: CAD file, 2026-11-07]
04_Rendering/meshes/lichtleiter.stl
2.60 x 2.59 x 8.50
