rtreichl/Wordclock/(list of files, cad)

Other CAD files:
01_Mechanic/Gitter/JLC3DP/Gitter_Q3_untenlinks_JLC3DP_druckfertig.3mf
05_Production/03_Gitter_3D-Druck/Gitter_Q3_untenlinks_JLC3DP_druckfertig.3mf
05_Production/05_Platine_JLCPCB/LED-Board_master.step
01_Mechanic/Gitter/Gitter_Q1_obenlinks_druckfertig.3mf
01_Mechanic/Gitter/JLC3DP/Gitter_Q1_obenlinks_JLC3DP_druckfertig.3mf
04_Rendering/meshes/pcb_PCB_Q3.stl
05_Production/03_Gitter_3D-Druck/Gitter_Q2_obenrechts_JLC3DP_druckfertig.3mf
05_Production/05_Platine_JLCPCB/LED-Board_slave.step
01_Mechanic/Gitter/Gitter_Q2_obenrechts.step
01_Mechanic/Gitter/JLC3DP/Gitter_Q4_untenrechts_JLC3DP.step
04_Rendering/meshes/pcb_PCB_Q1.stl
05_Production/03_Gitter_3D-Druck/Gitter_Q1_obenlinks_JLC3DP.step
Unbenannt-Slice001.1.step
01_Mechanic/Gitter/Gitter_Q3_untenlinks_druckfertig.3mf
01_Mechanic/Gitter/JLC3DP/Gitter_Q3_untenlinks_JLC3DP.step
05_Production/03_Gitter_3D-Druck/Gitter_Q1_obenlinks_druckfertig.3mf
Unbenannt-Slice001.4.step
01_Mechanic/Gitter/Gitter_Q1_obenlinks.step
01_Mechanic/Gitter/JLC3DP/Gitter_Q4_untenrechts_JLC3DP_druckfertig.3mf
04_Rendering/meshes/pcb_PCB_Q4_Master.stl
05_Production/03_Gitter_3D-Druck/Gitter_Q4_untenrechts_JLC3DP.step
05_Production/04_Rueckrahmen_3D-Druck/Rueckrahmen_Q1_obenlinks_kurz.step
01_Mechanic/Gitter/Gitter_Q4_untenrechts_druckfertig.3mf
01_Mechanic/Gitter/JLC3DP/Gitter_Q2_obenrechts_JLC3DP_druckfertig.3mf
04_Rendering/meshes/gitter_Q3_untenlinks.stl
05_Production/03_Gitter_3D-Druck/Gitter_Q1_obenlinks_JLC3DP_druckfertig.3mf
05_Production/04_Rueckrahmen_3D-Druck/Rueckrahmen_Q2_obenrechts_lang.step
Unbenannt-Slice001.2.step
01_Mechanic/Gitter/Gitter_Q3_untenlinks.step
01_Mechanic/Gitter/JLC3DP/Gitter_Q2_obenrechts_JLC3DP.step
05_Production/03_Gitter_3D-Druck/Gitter_Q2_obenrechts.step
05_Production/04_Rueckrahmen_3D-Druck/Rueckrahmen_Q3_untenlinks_lang.step
01_Mechanic/Gitter/Gitter_Q4_untenrechts.step
01_Mechanic/Gitter/JLC3DP/Gitter_Q1_obenlinks_JLC3DP.step
04_Rendering/meshes/gitter_Q2_obenrechts.stl
05_Production/03_Gitter_3D-Druck/Gitter_Q3_untenlinks_druckfertig.3mf
05_Production/04_Rueckrahmen_3D-Druck/Rueckrahmen_Q3_untenlinks_kurz.step
04_Rendering/meshes/gitter_Q4_untenrechts.stl
05_Production/04_Rueckrahmen_3D-Druck/Rueckrahmen_Q4_untenrechts_kurz.step
04_Rendering/meshes/frontplatte.stl
05_Production/03_Gitter_3D-Druck/Gitter_Q1_obenlinks.step
05_Production/03_Gitter_3D-Druck/Gitter_Q2_obenrechts_JLC3DP.step
04_Rendering/meshes/gitter_Q1_obenlinks.stl
05_Production/03_Gitter_3D-Druck/Gitter_Q4_untenrechts.step
05_Production/03_Gitter_3D-Druck/Gitter_Q3_untenlinks_JLC3DP.step
05_Production/03_Gitter_3D-Druck/Gitter_Q4_untenrechts_JLC3DP_druckfertig.3mf
05_Production/03_Gitter_3D-Druck/Gitter_Q4_untenrechts_druckfertig.3mf
05_Production/03_Gitter_3D-Druck/Gitter_Q3_untenlinks.step
04_Rendering/WortUhr_Szene.blend
99_Archive/Unbenannt-Slice001.1.3mf
99_Archive/Unbenannt-Slice001.1.step
99_Archive/Unbenannt-Slice001.2.step
99_Archive/Unbenannt-Slice001.4.step
Unbenannt-Slice001.1.3mf
