rtreichl/Wordclock/02_Electronics/Bilder/Platine_Lagen.pdf

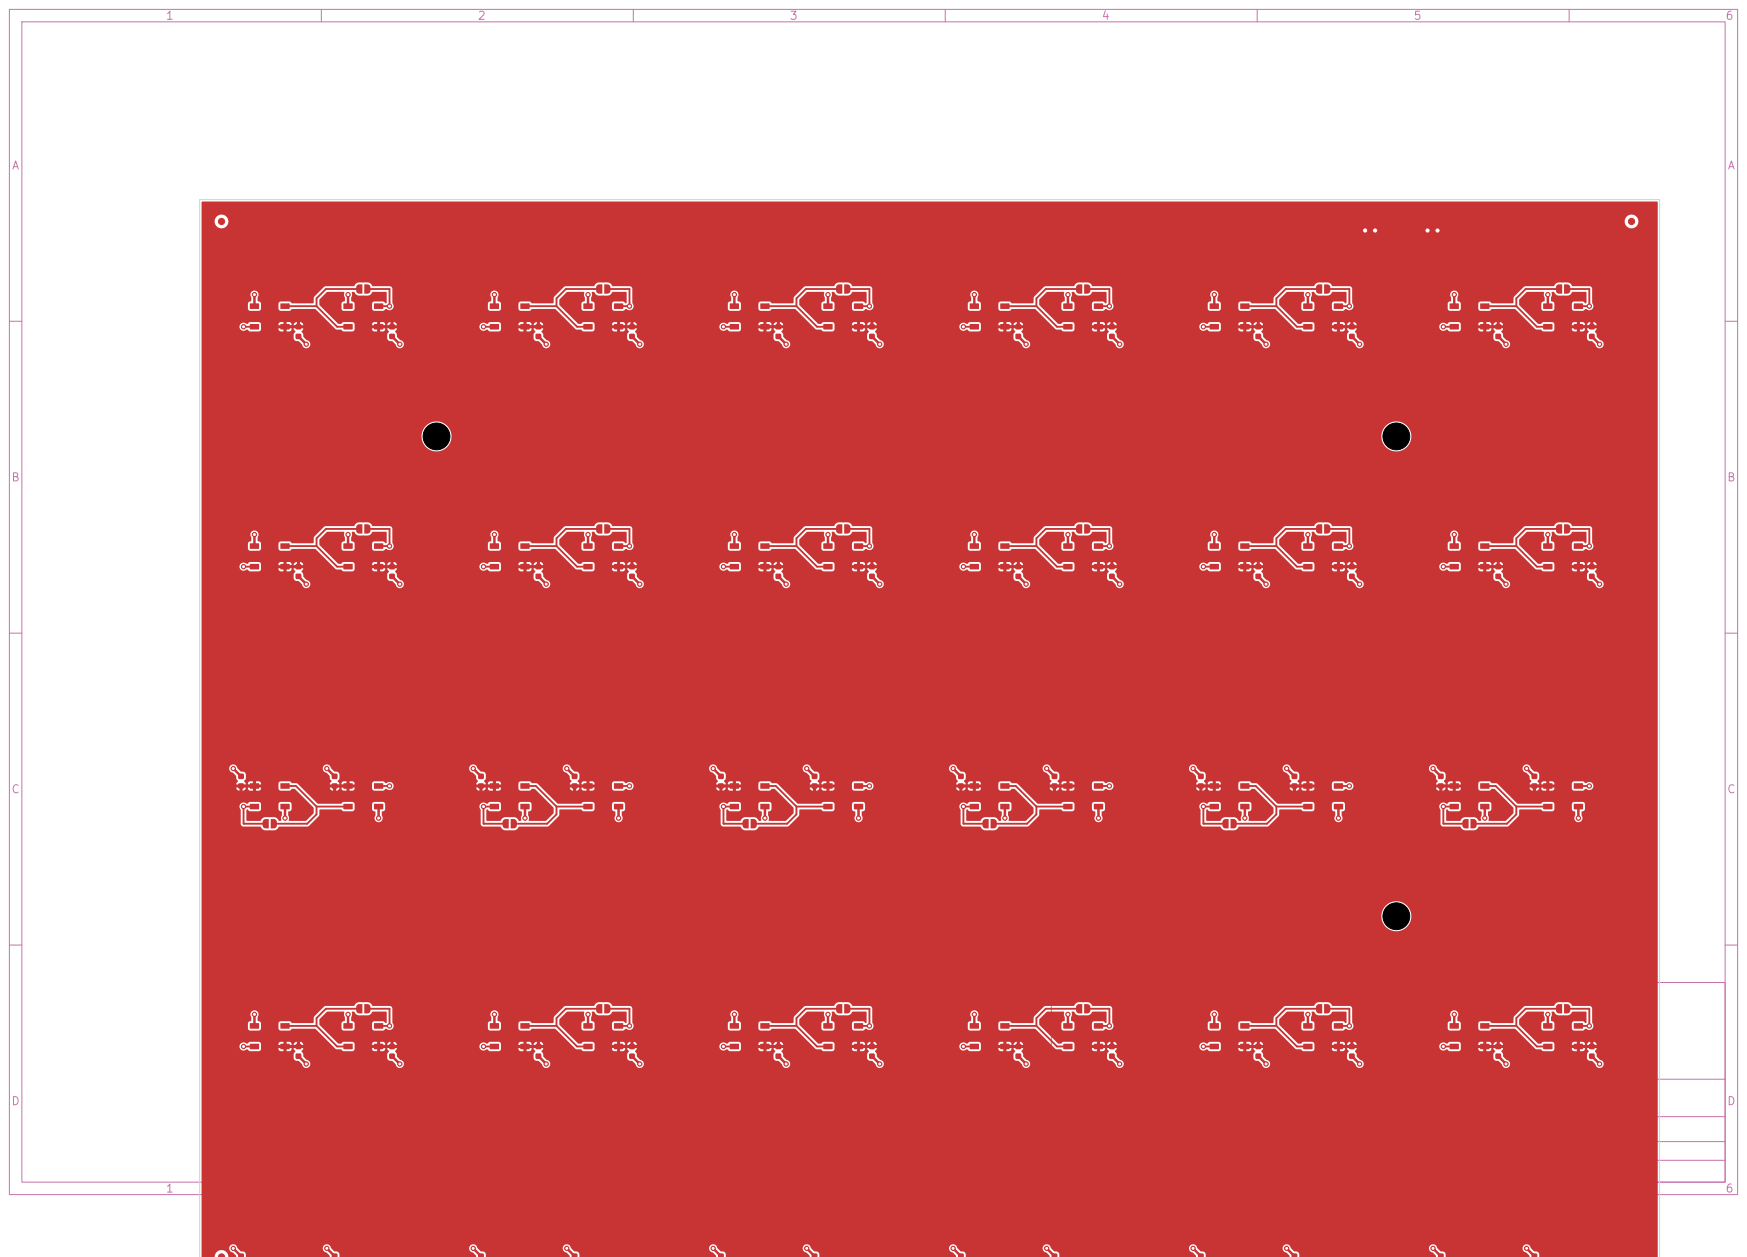
[picture p45: page 1]

Sheet: File: WortUhr.kicad_pcb | D Date:

Title:
Size: A4 | Rev:
KiCad E.D.A. 10.0.6 | Id: 1/8

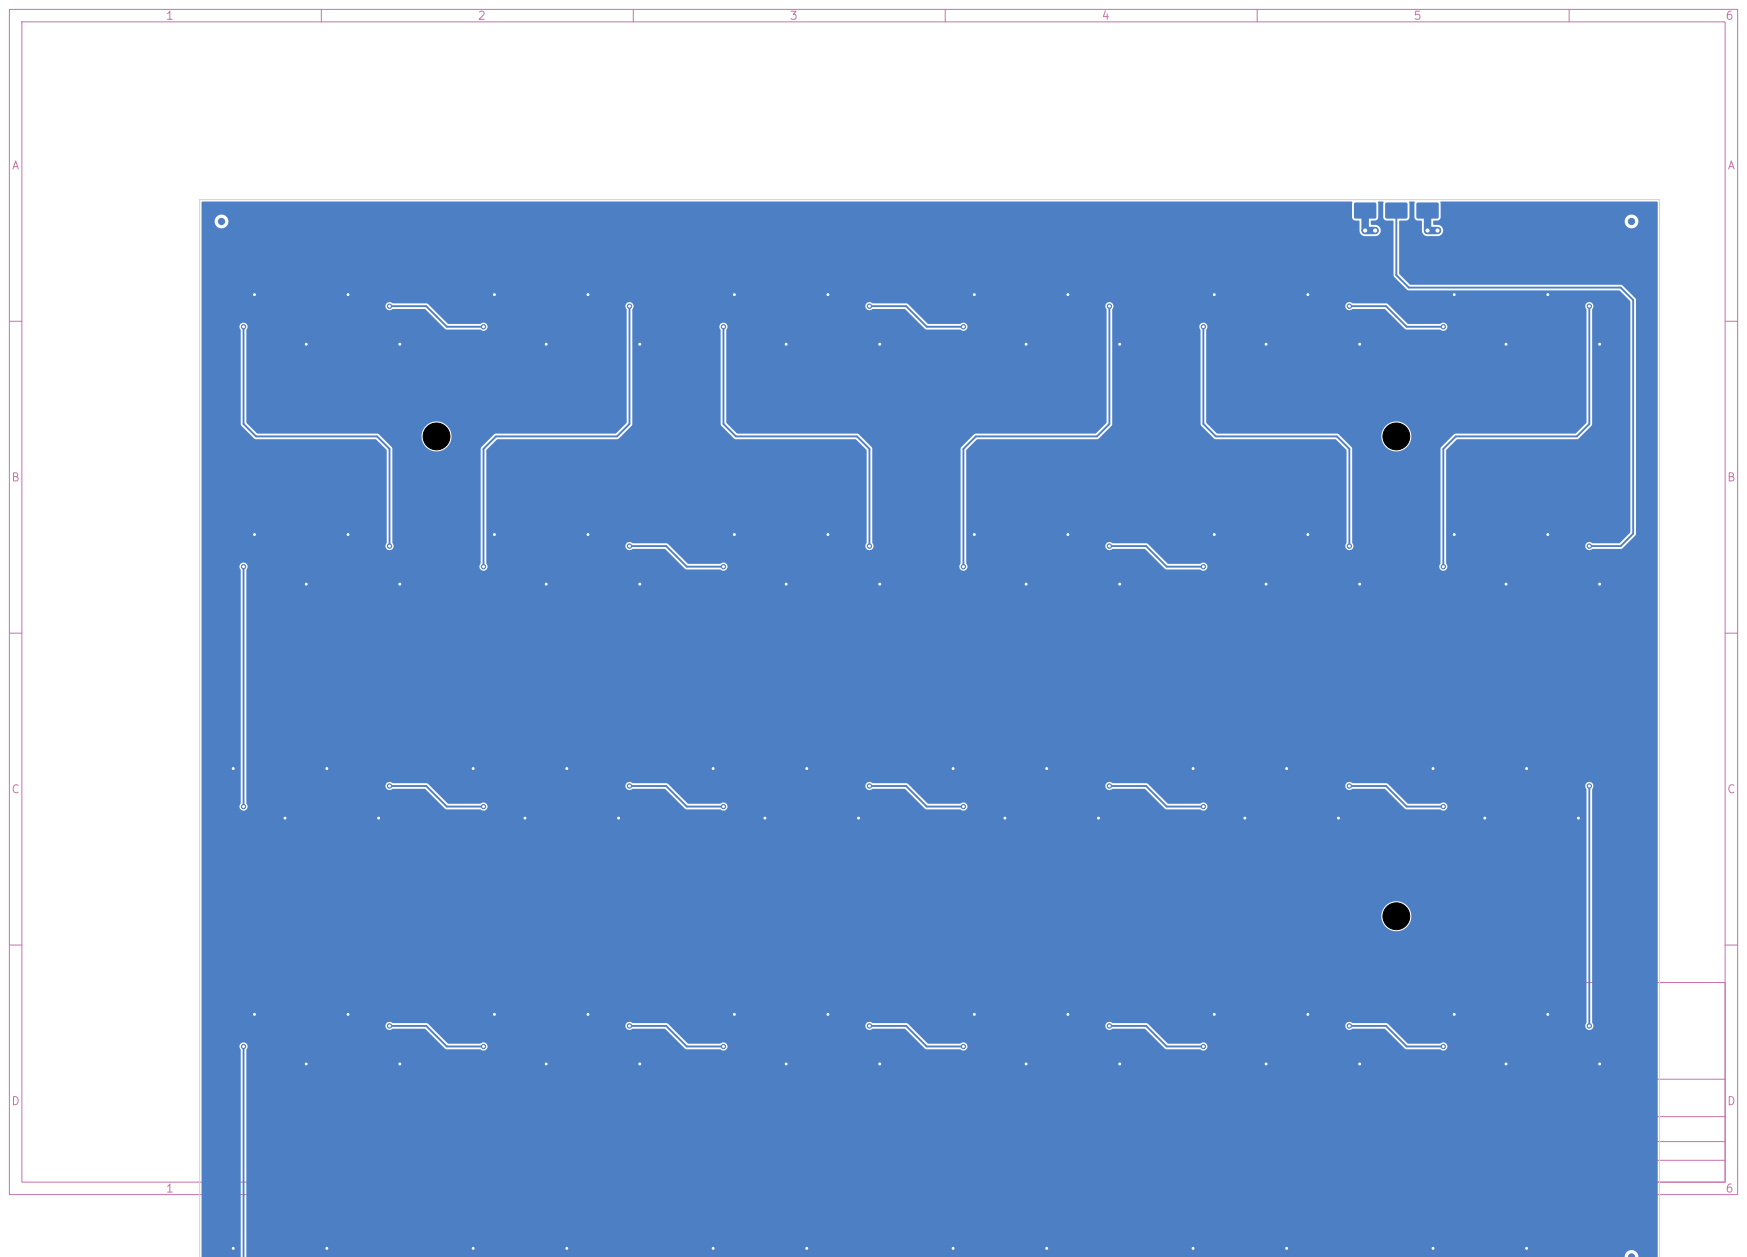
[picture p46: page 2]

Sheet: File: WortUhr.kicad_pcb | D Date:

Title:

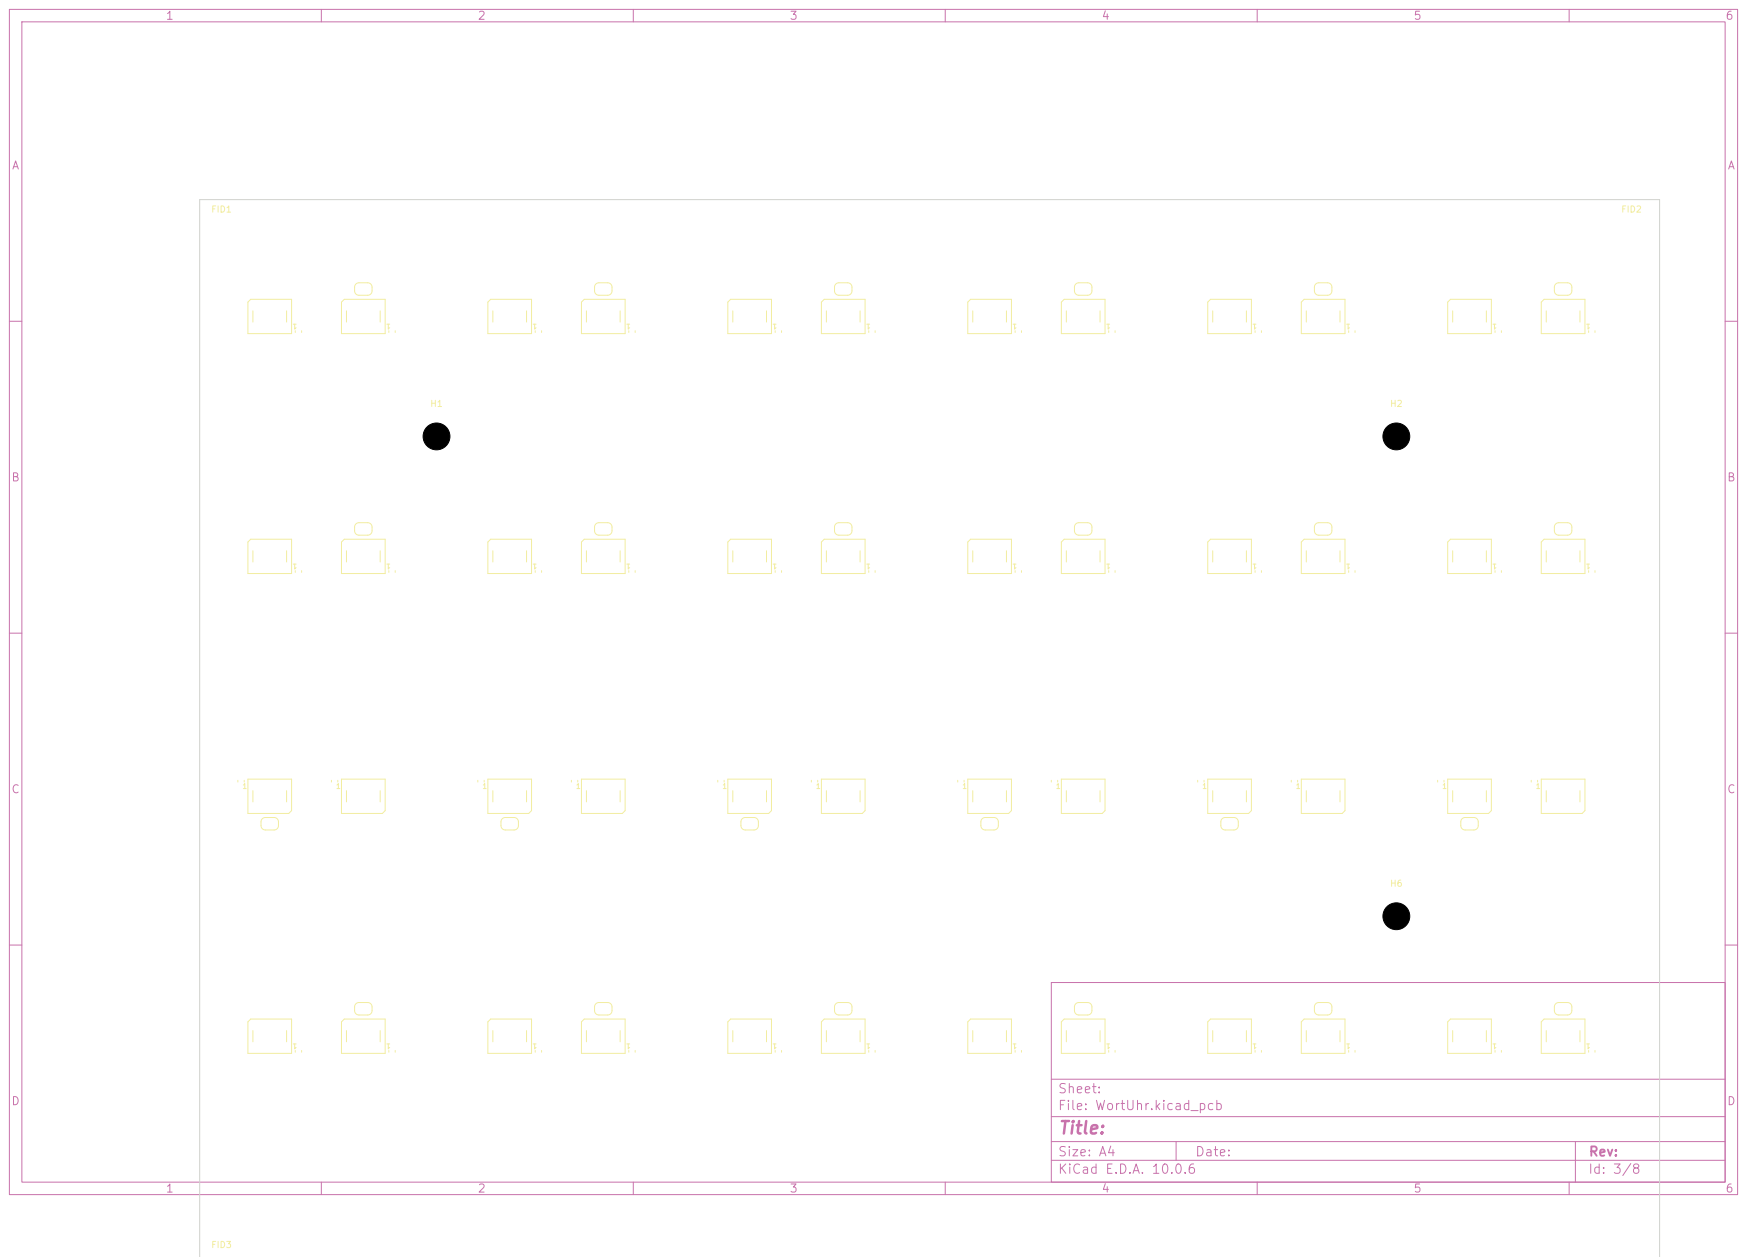
[picture p47: page 3]

Sheet: File: WortUhr.kicad_pcb | D Date:

Title:

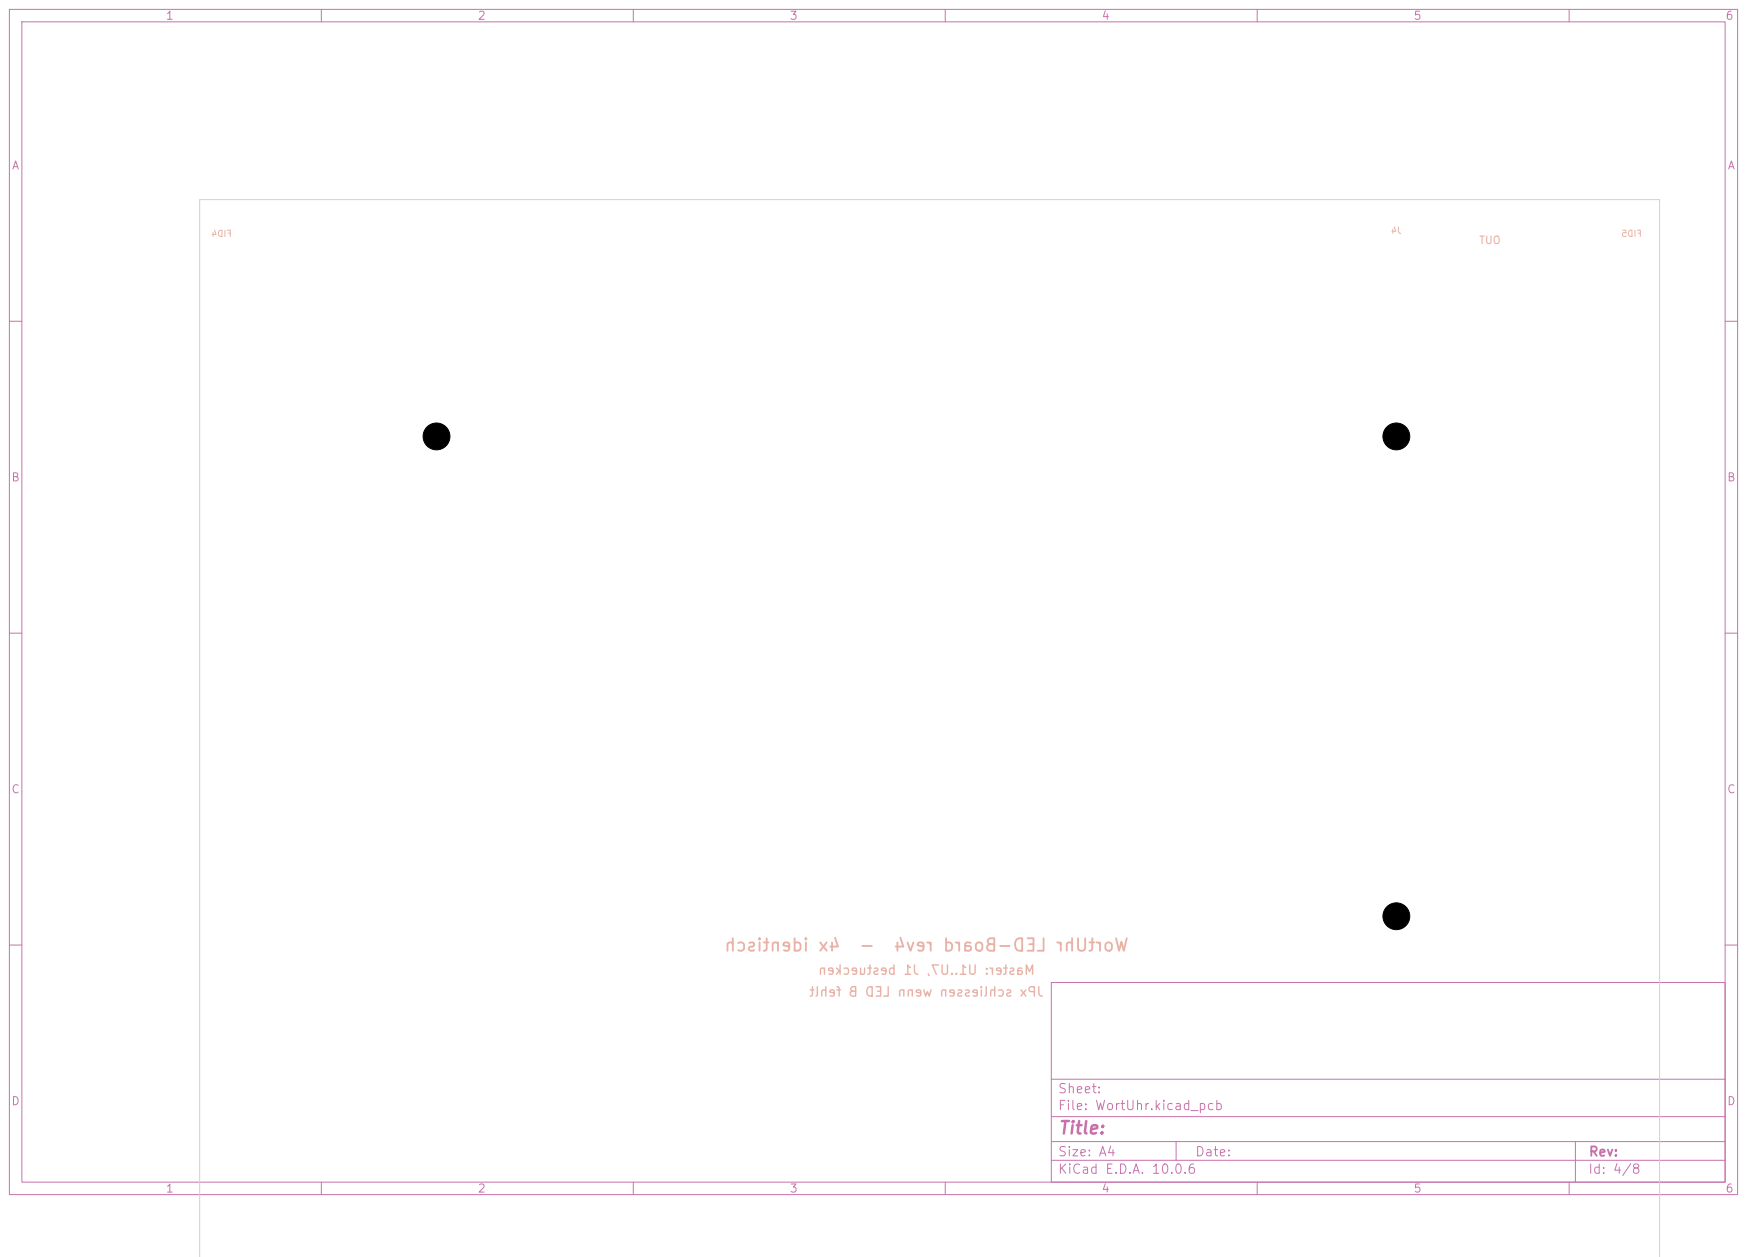
[picture p48: page 4]

Sheet: File: WortUhr.kicad_pcb | D Date:

Title:

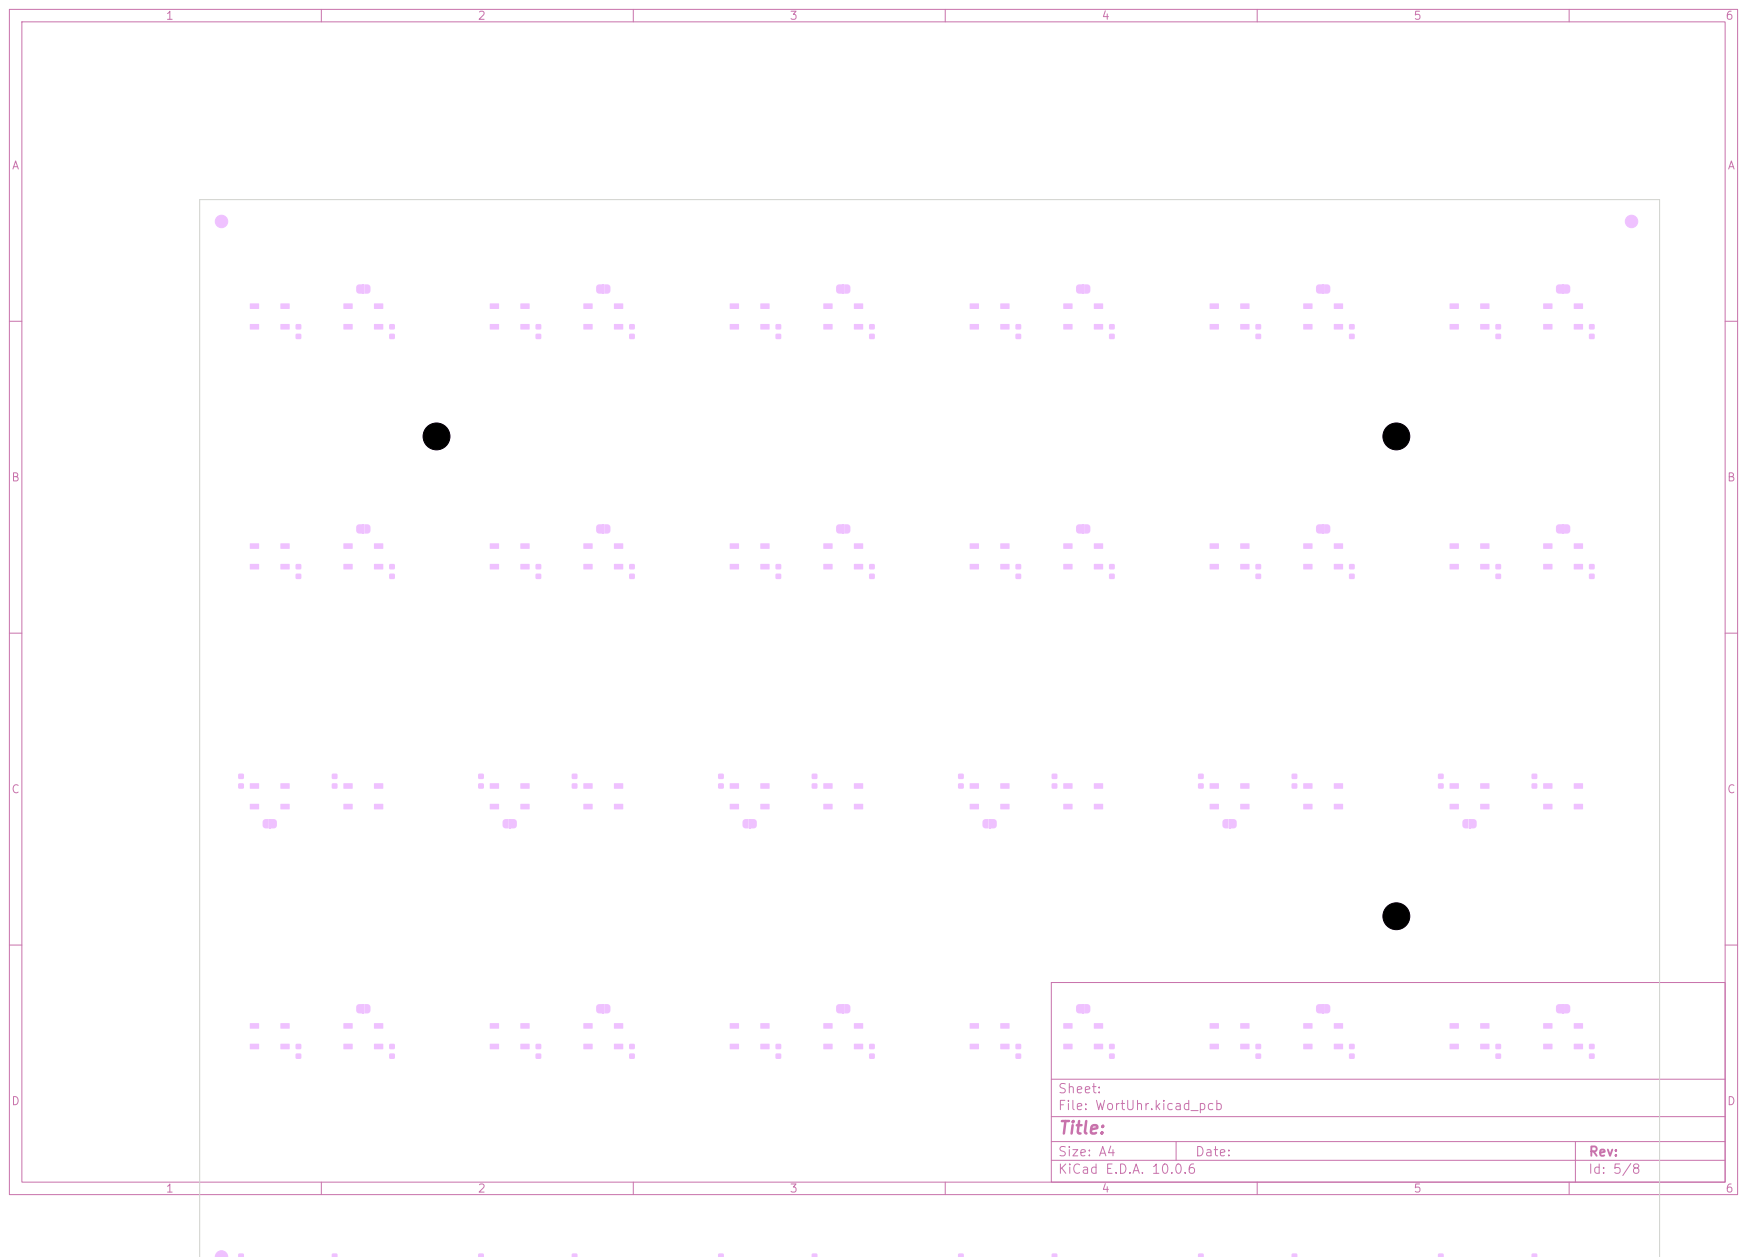
[picture p49: page 5]

Sheet: File: WortUhr.kicad_pcb | D Date:

Title:

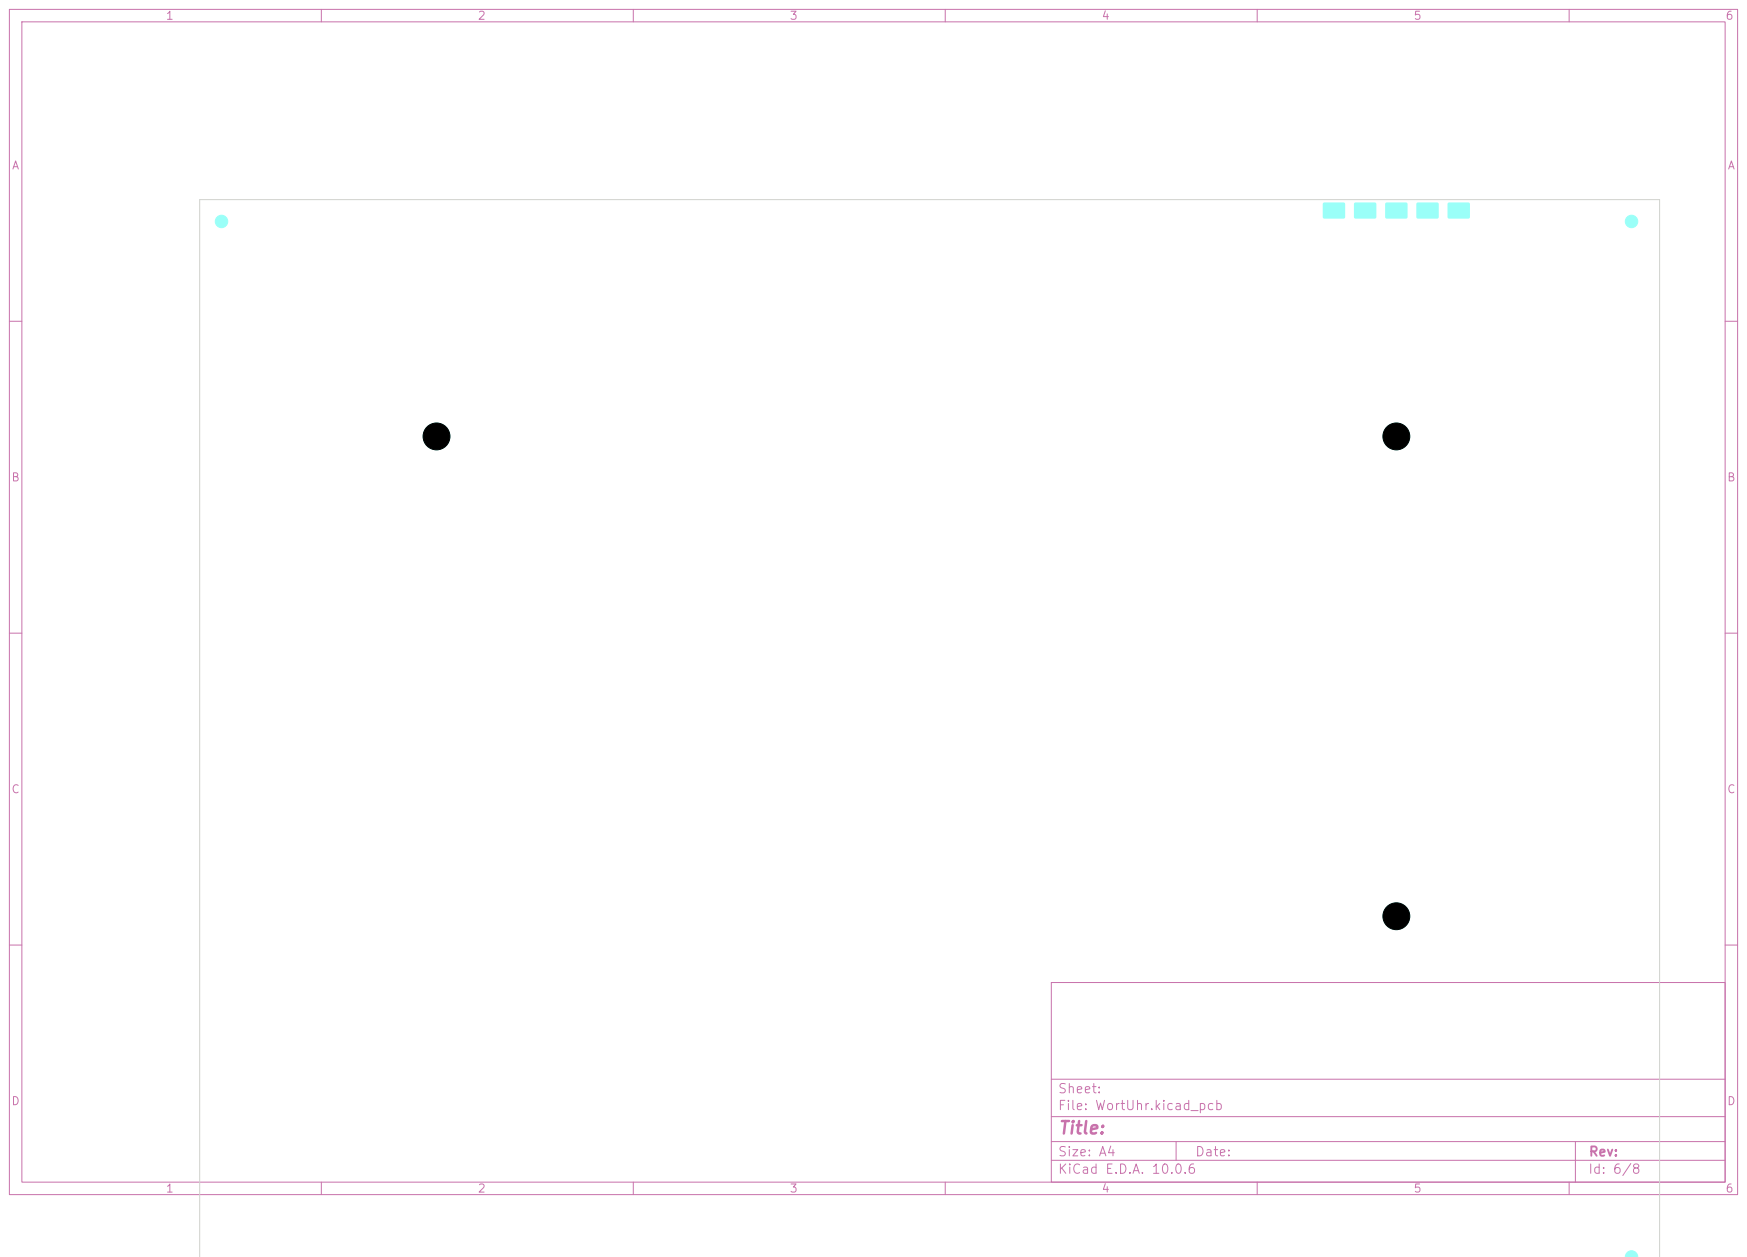
[picture p50: page 6]

Sheet: File: WortUhr.kicad_pcb | D Date:

Title:

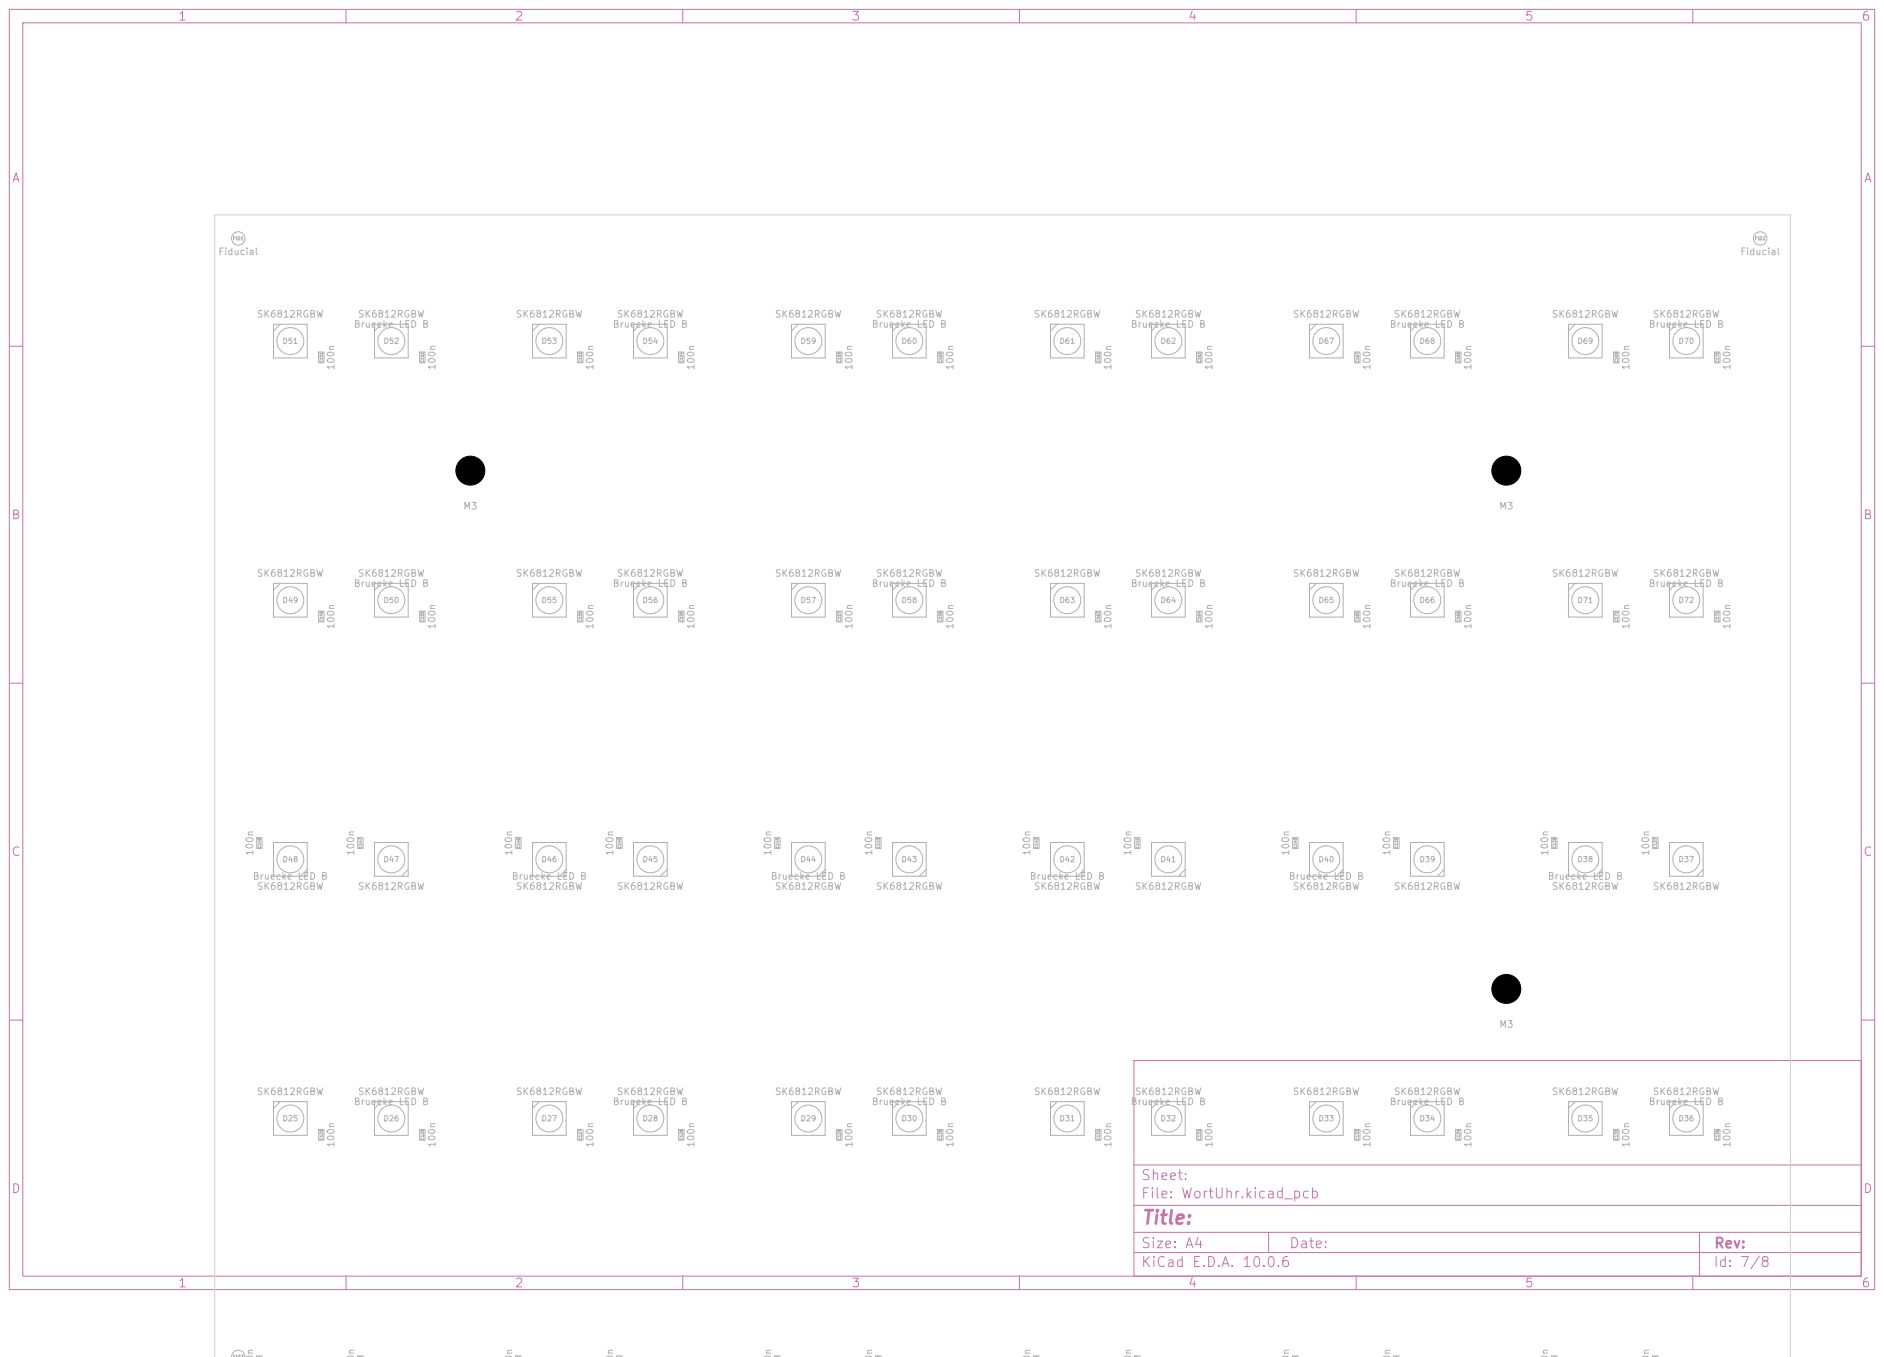
[picture p51: page 7]

File: WortUhr.kicad_pcb | D Date:
Title:

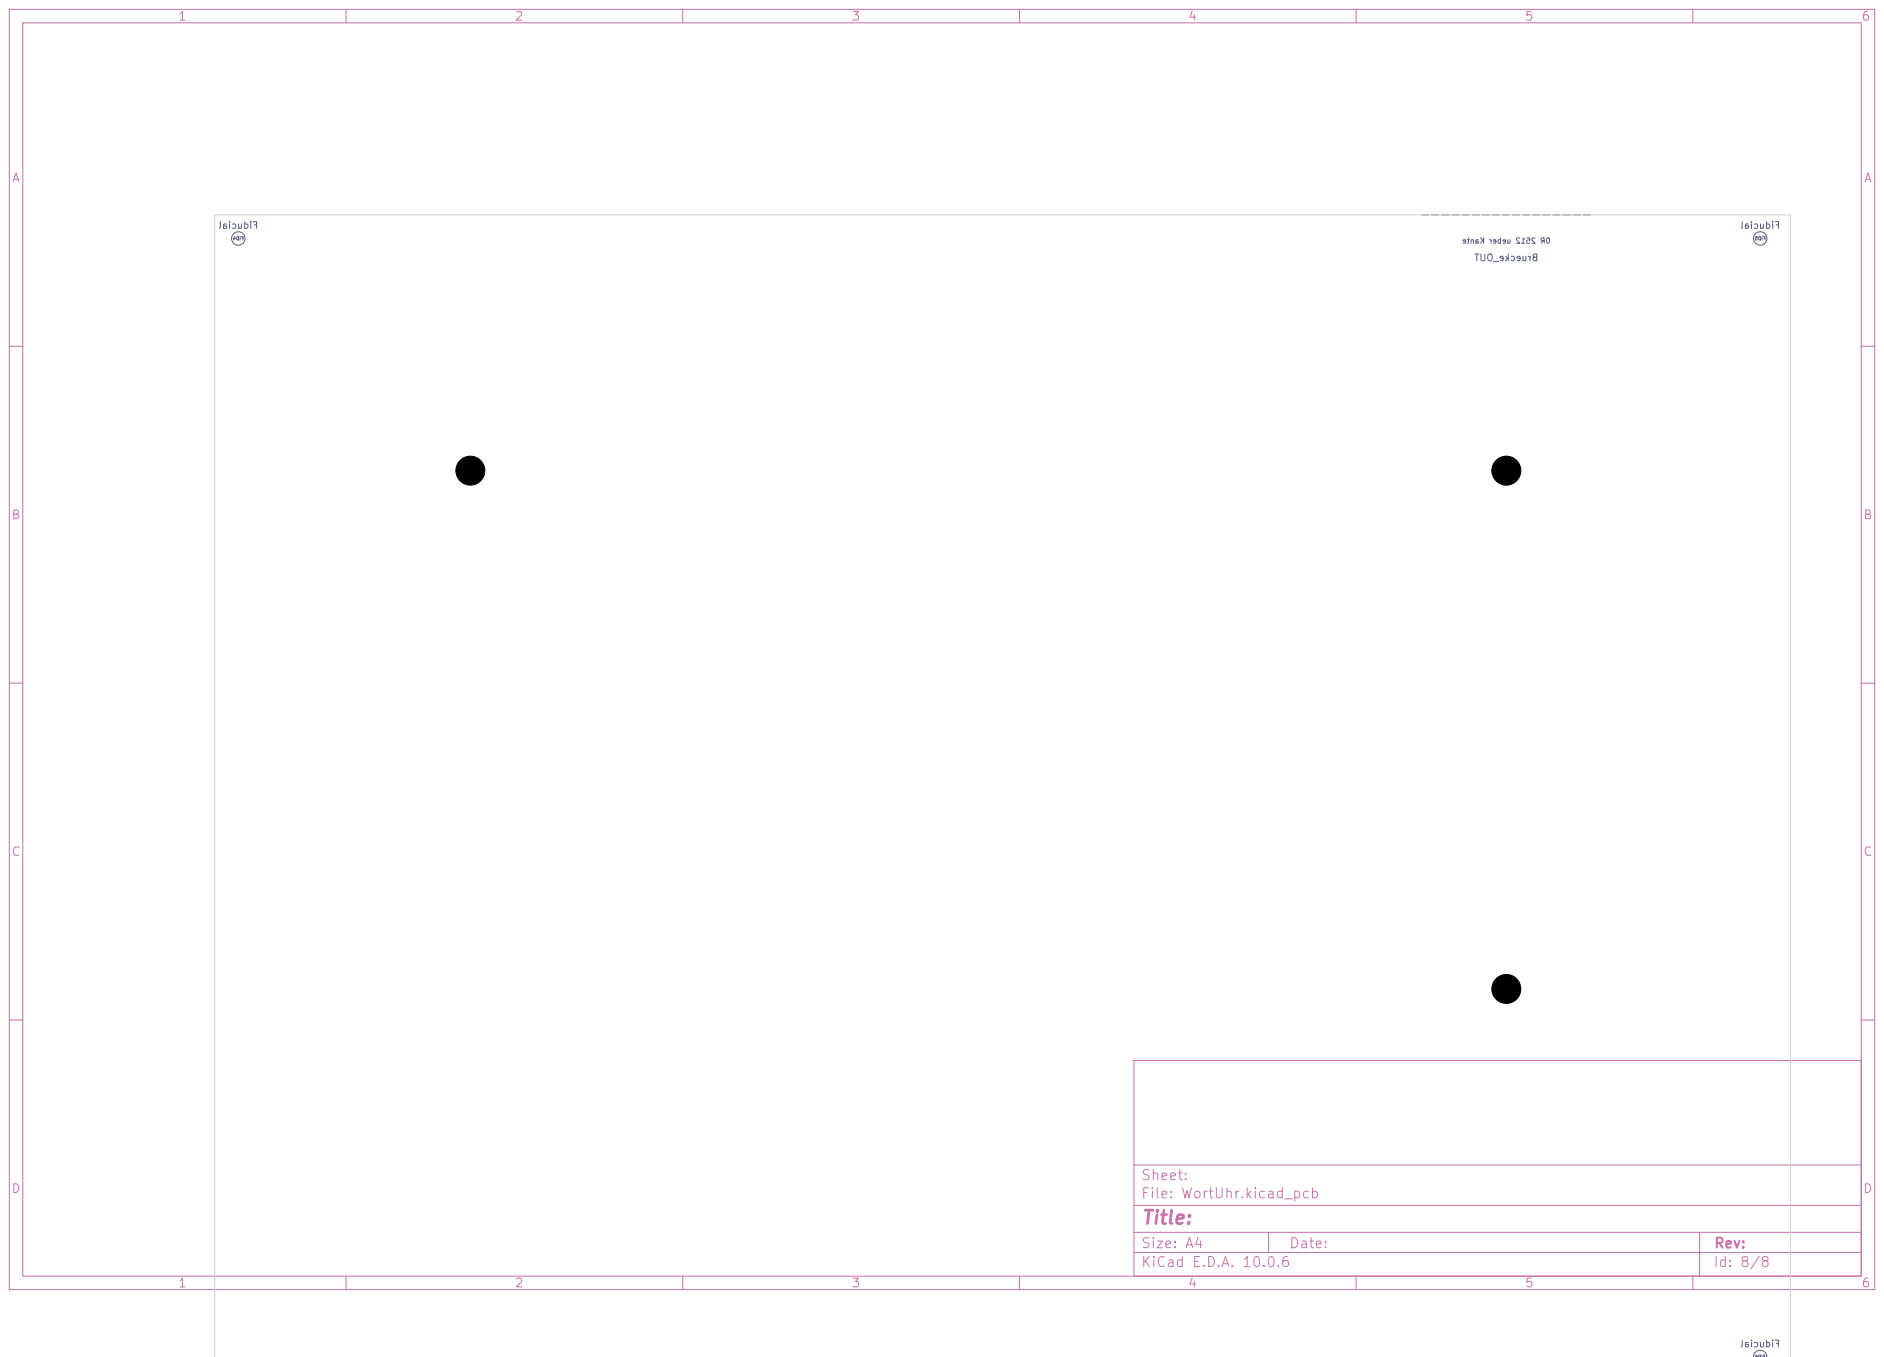
[picture p52: page 8]

Sheet: File: WortUhr.kicad_pcb | D Date:

Title:
