rtreichl/Wordclock/05_Production/05_Platine_JLCPCB/WortUhr_Schaltplan.pdf

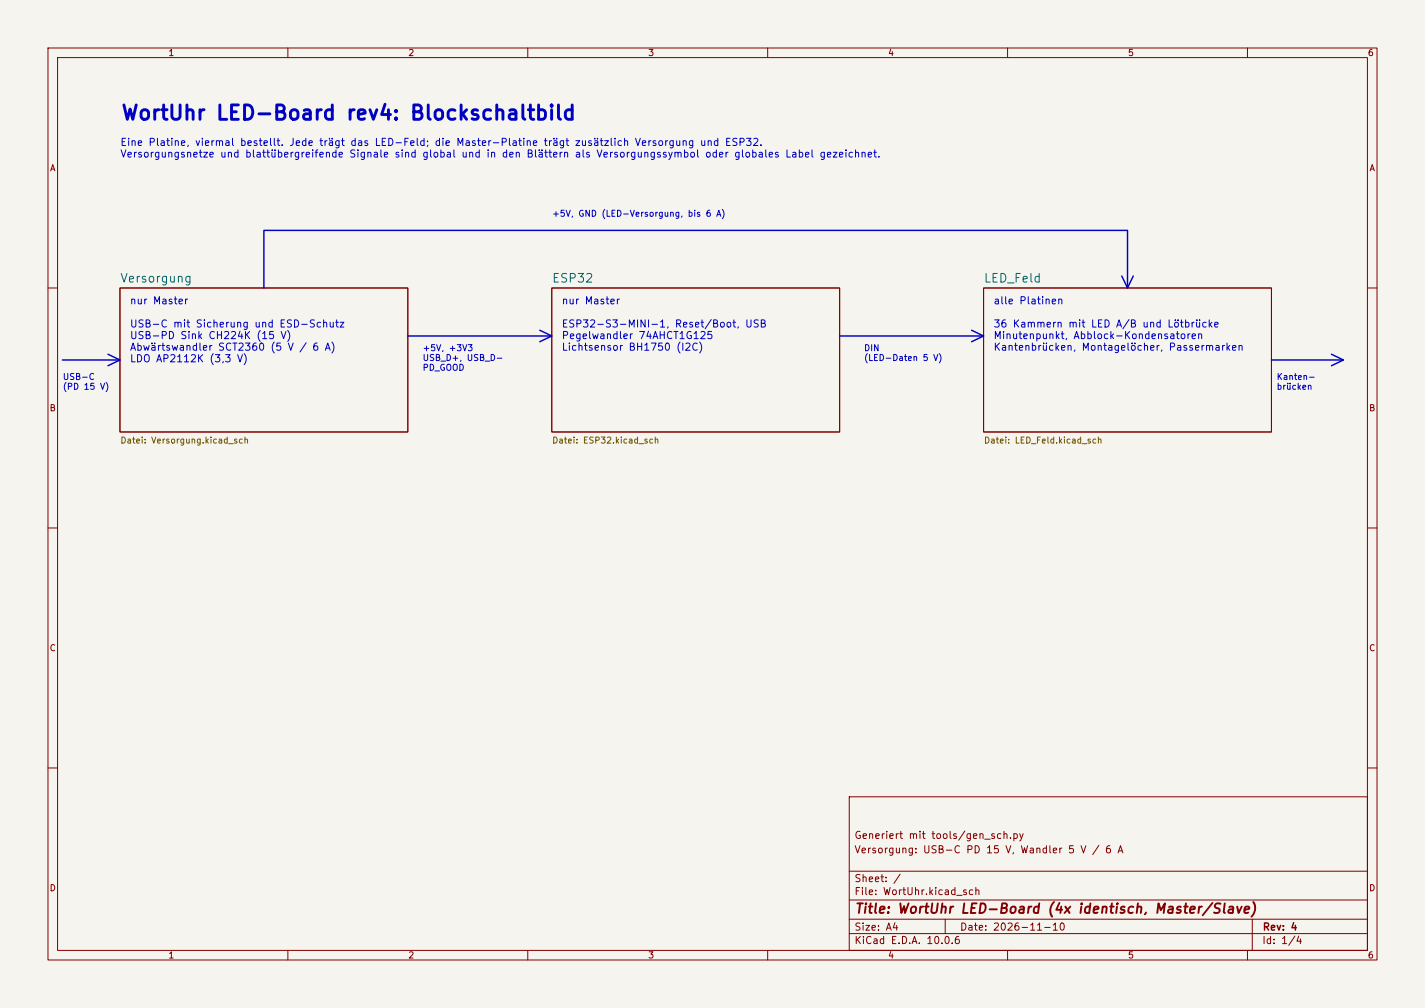
[picture p53: page 1]

Datei: LED_Feld.kicad_sch WortUhr LED-Board rev4: Blockschaltbild

Eine Platine, viermal bestellt. Jede trägt das LED-Feld; die Master-Platine trägt zusätzlich Versorgung und ESP32.
Versorgungsnetze und blattübergreifende Signale sind global und in den Blättern als Versorgungssymbol oder globales Label gezeichnet.

+5V, GND (LED-Versorgung, bis 6 A)

USB-C mit Sicherung und ESD-Schutz
USB-PD Sink CH224K (15 V)
Abwärtswandler SCT2360 (5 V / 6 A)
LDO AP2112K (3,3 V)

ESP32-S3-MINI-1, Reset/Boot, USB
Pegelwandler 74AHCT1G125

36 Kammern mit LED A/B und Lötbrücke
Minutenpunkt, Abblock-Kondensatoren
Kantenbrücken, Montagelöcher, Passermarken

Generiert mit tools/gen_sch.py
Versorgung: USB-C PD 15 V, Wandler 5 V / 6 A

Sheet: /
File: WortUhr.kicad_sch
Title: WortUhr LED-Board (4x identisch, Master/Slave)

Size: A4 | Rev: 4
KiCad E.D.A. 10.0.6 | Id: 1/4

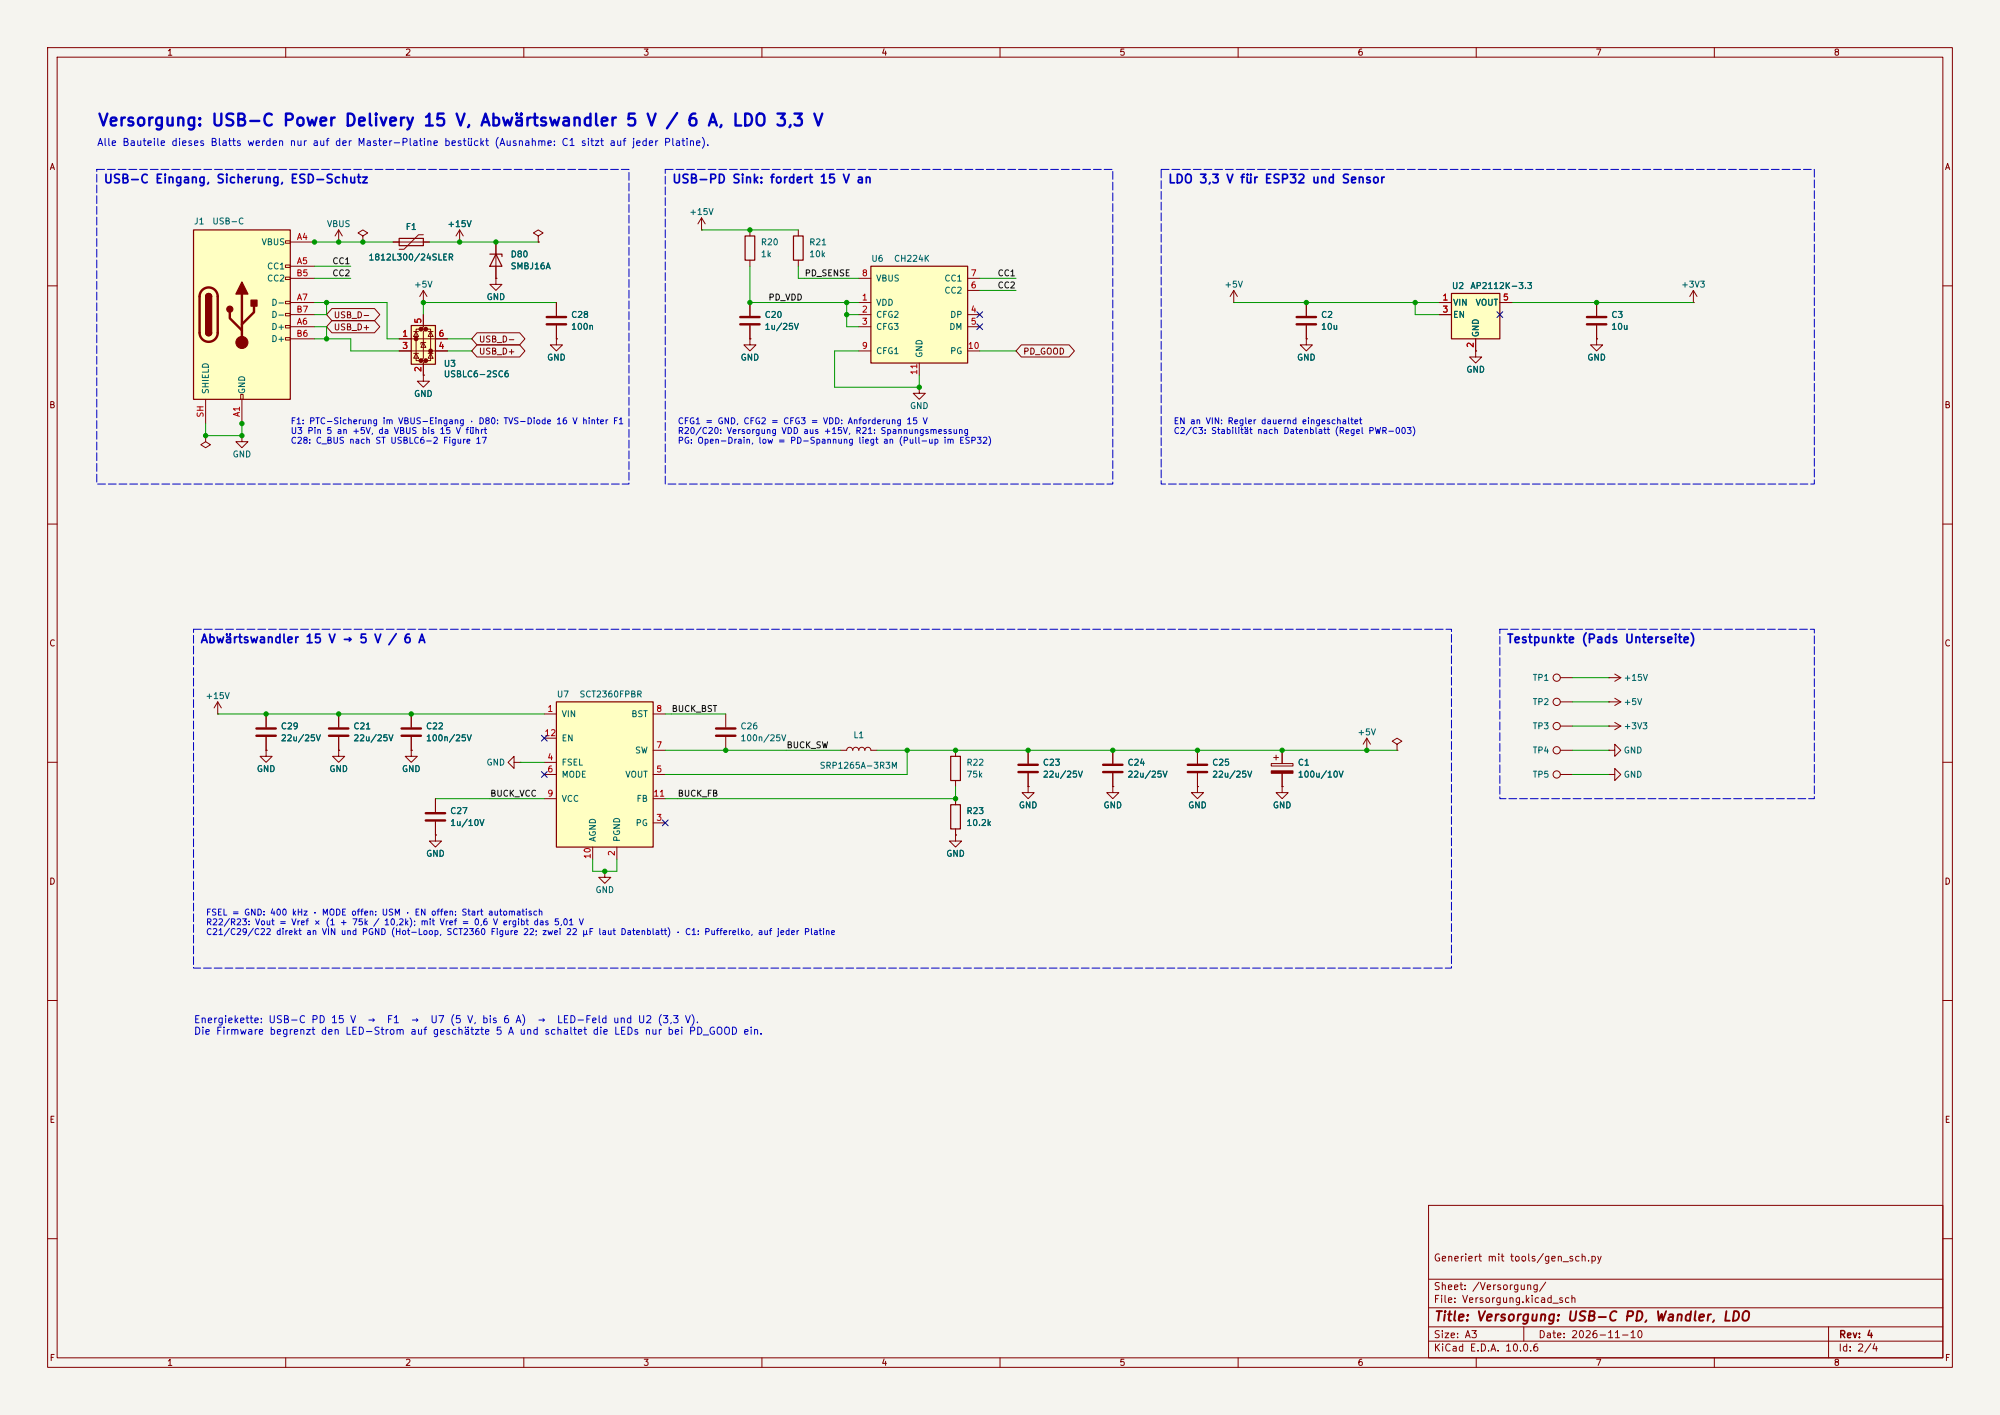
[picture p54: page 2]

Versorgung: USB-C Power Delivery 15 V, Abwärtswandler 5 V / 6 A, LDO 3,3 V

CC2 Alle Bauteile dieses Blatts werden nur auf der Master-Platine bestückt (Ausnahme: C1 sitzt auf jeder Platine).

USB-C Eingang, Sicherung, ESD-Schutz

USB-PD Sink: fordert 15 V an

LDO 3,3 V für ESP32 und Sensor

CFG1 = GND, CFG2 = CFG3 = VDD: Anforderung 15 V R20/C20: Versorgung VDD aus +15V, R21: Spannungsmessung PG: Open-Drain, low = PD-Spannung liegt an (Pull-up im ESP32)

EN an VIN: Regler dauernd eingeschaltet

C2/C3: Stabilität nach Datenblatt (Regel PWR-003) FSEL = GND: 400 kHz · MODE offen: USM · EN offen: Start automatisch R22/R23: Vout = Vref × (1 + 75k / 10,2k); mit Vref = 0,6 V ergibt das 5,01 V C21/C29/C22 direkt an VIN und PGND (Hot-Loop, SCT2360 Figure 22; zwei 22 µF laut Datenblatt) · C1: Pufferelko, auf jeder Platine Energiekette: USB-C PD 15 V → F1 → U7 (5 V, bis 6 A) → LED-Feld und U2 (3,3 V).

Die Firmware begrenzt den LED-Strom auf geschätzte 5 A und schaltet die LEDs nur bei PD_GOOD ein.

Generiert mit tools/gen_sch.py

Sheet: /Versorgung/
File: Versorgung.kicad_sch
Title: Versorgung: USB-C PD, Wandler, LDO

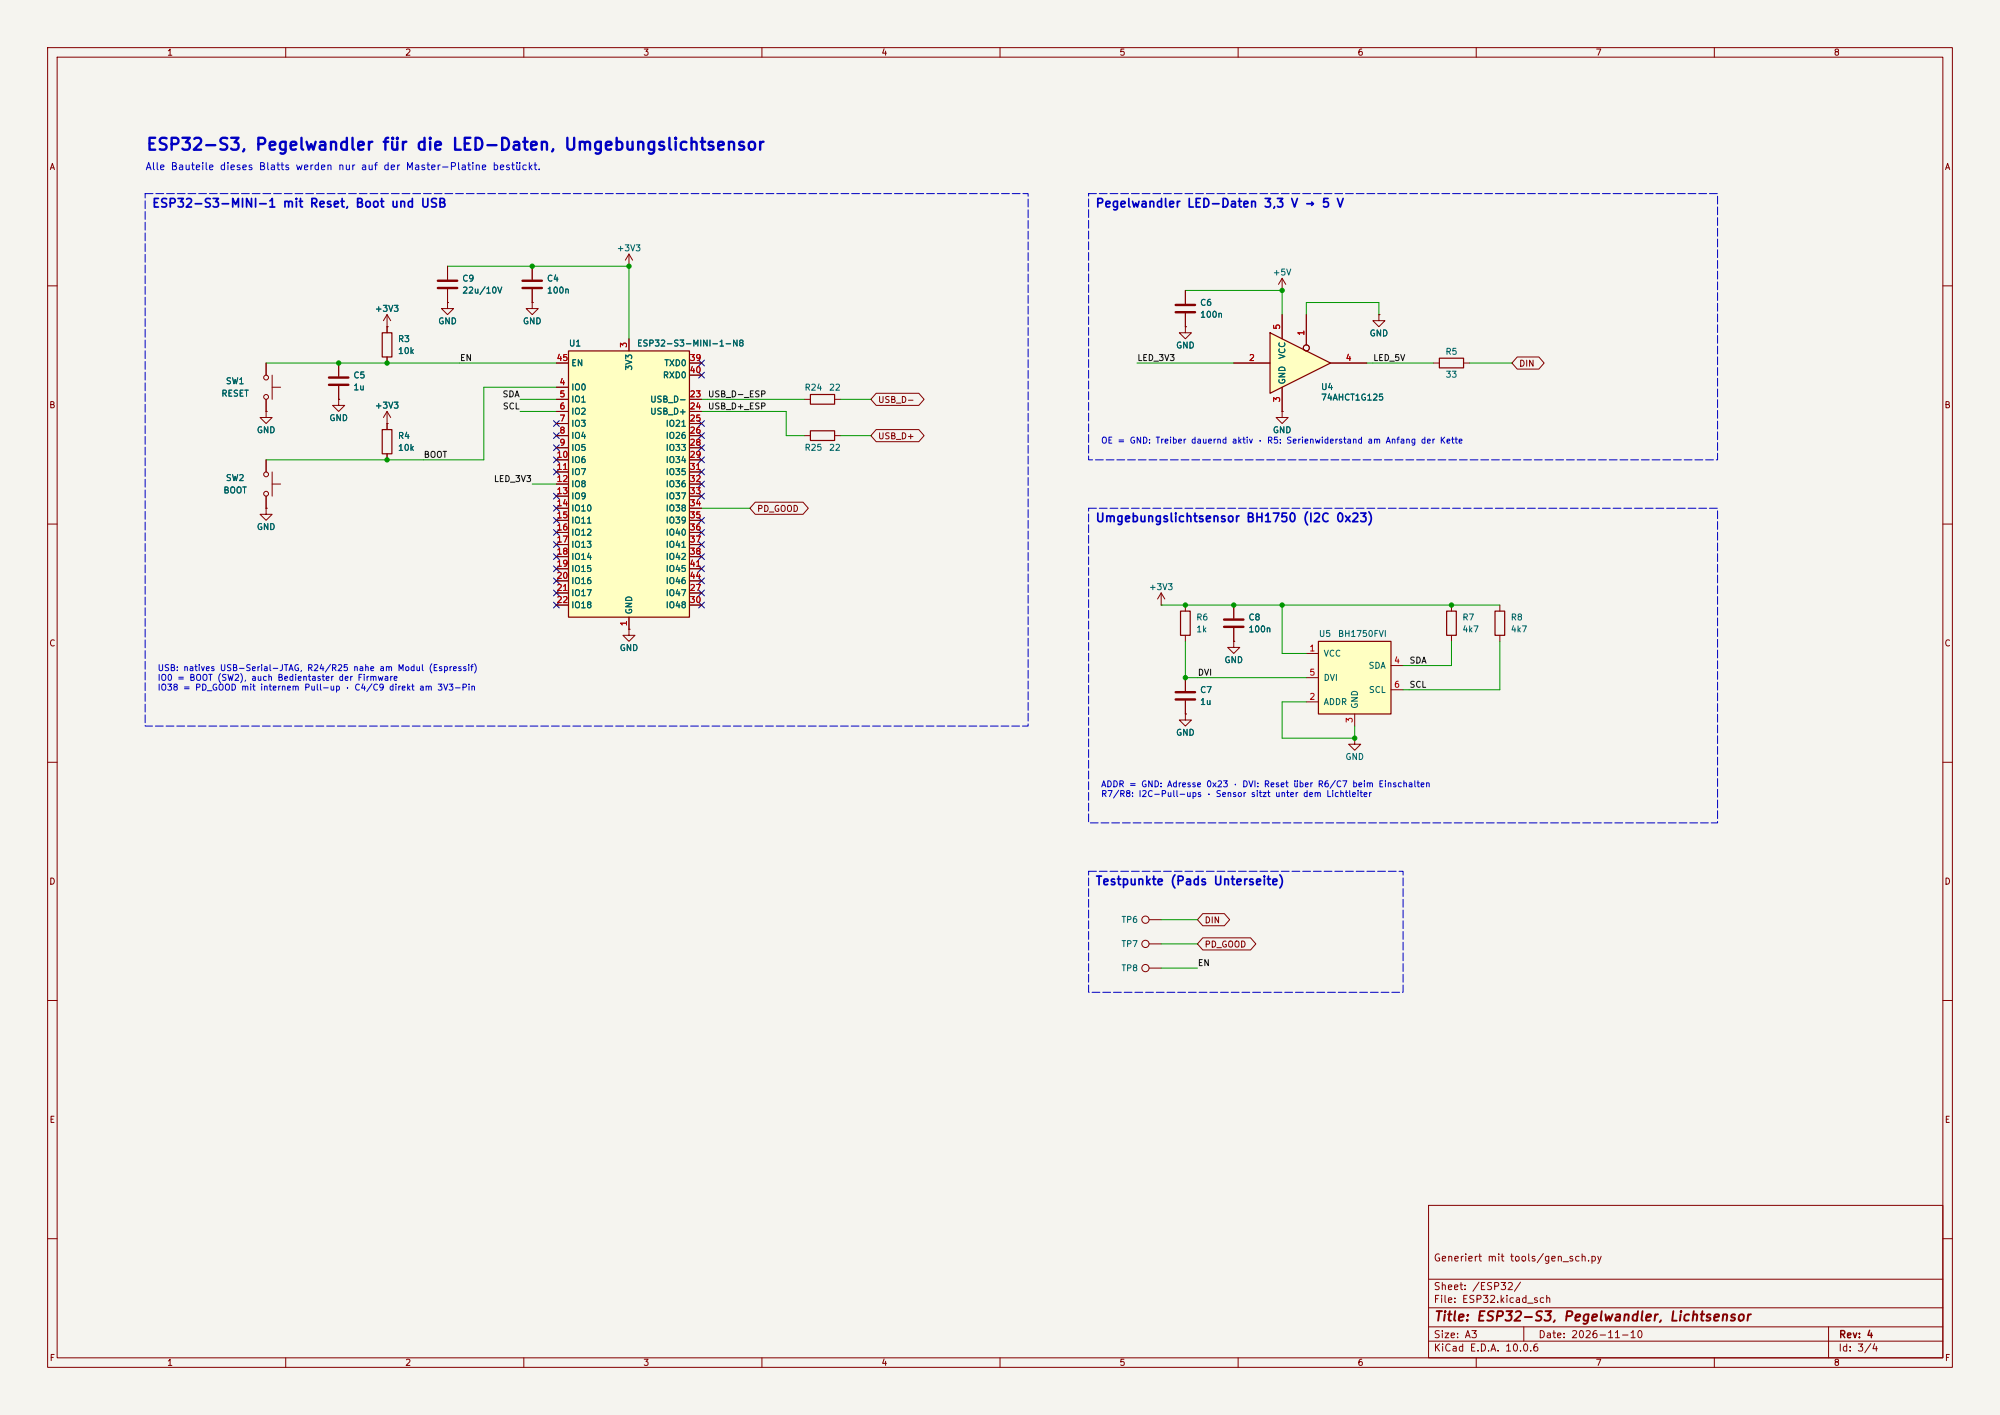
[picture p55: page 3]

ADDR = GND: Adresse 0x23 · DVI: Reset über R6/C7 beim Einschalten R7/R8: I2C-Pull-ups · Sensor sitzt unter dem Lichtleiter ESP32-S3, Pegelwandler für die LED-Daten, Umgebungslichtsensor

Alle Bauteile dieses Blatts werden nur auf der Master-Platine bestückt. USB: natives USB-Serial-JTAG, R24/R25 nahe am Modul (Espressif)

IO38 = PD_GOOD mit internem Pull-up · C4/C9 direkt am 3V3-Pin ESP32-S3-MINI-1 mit Reset, Boot und USB

OE = GND: Treiber dauernd aktiv · R5: Serienwiderstand am Anfang der Kette Testpunkte (Pads Unterseite)

IO0 = BOOT (SW2), auch Bedientaster der Firmware

Generiert mit tools/gen_sch.py

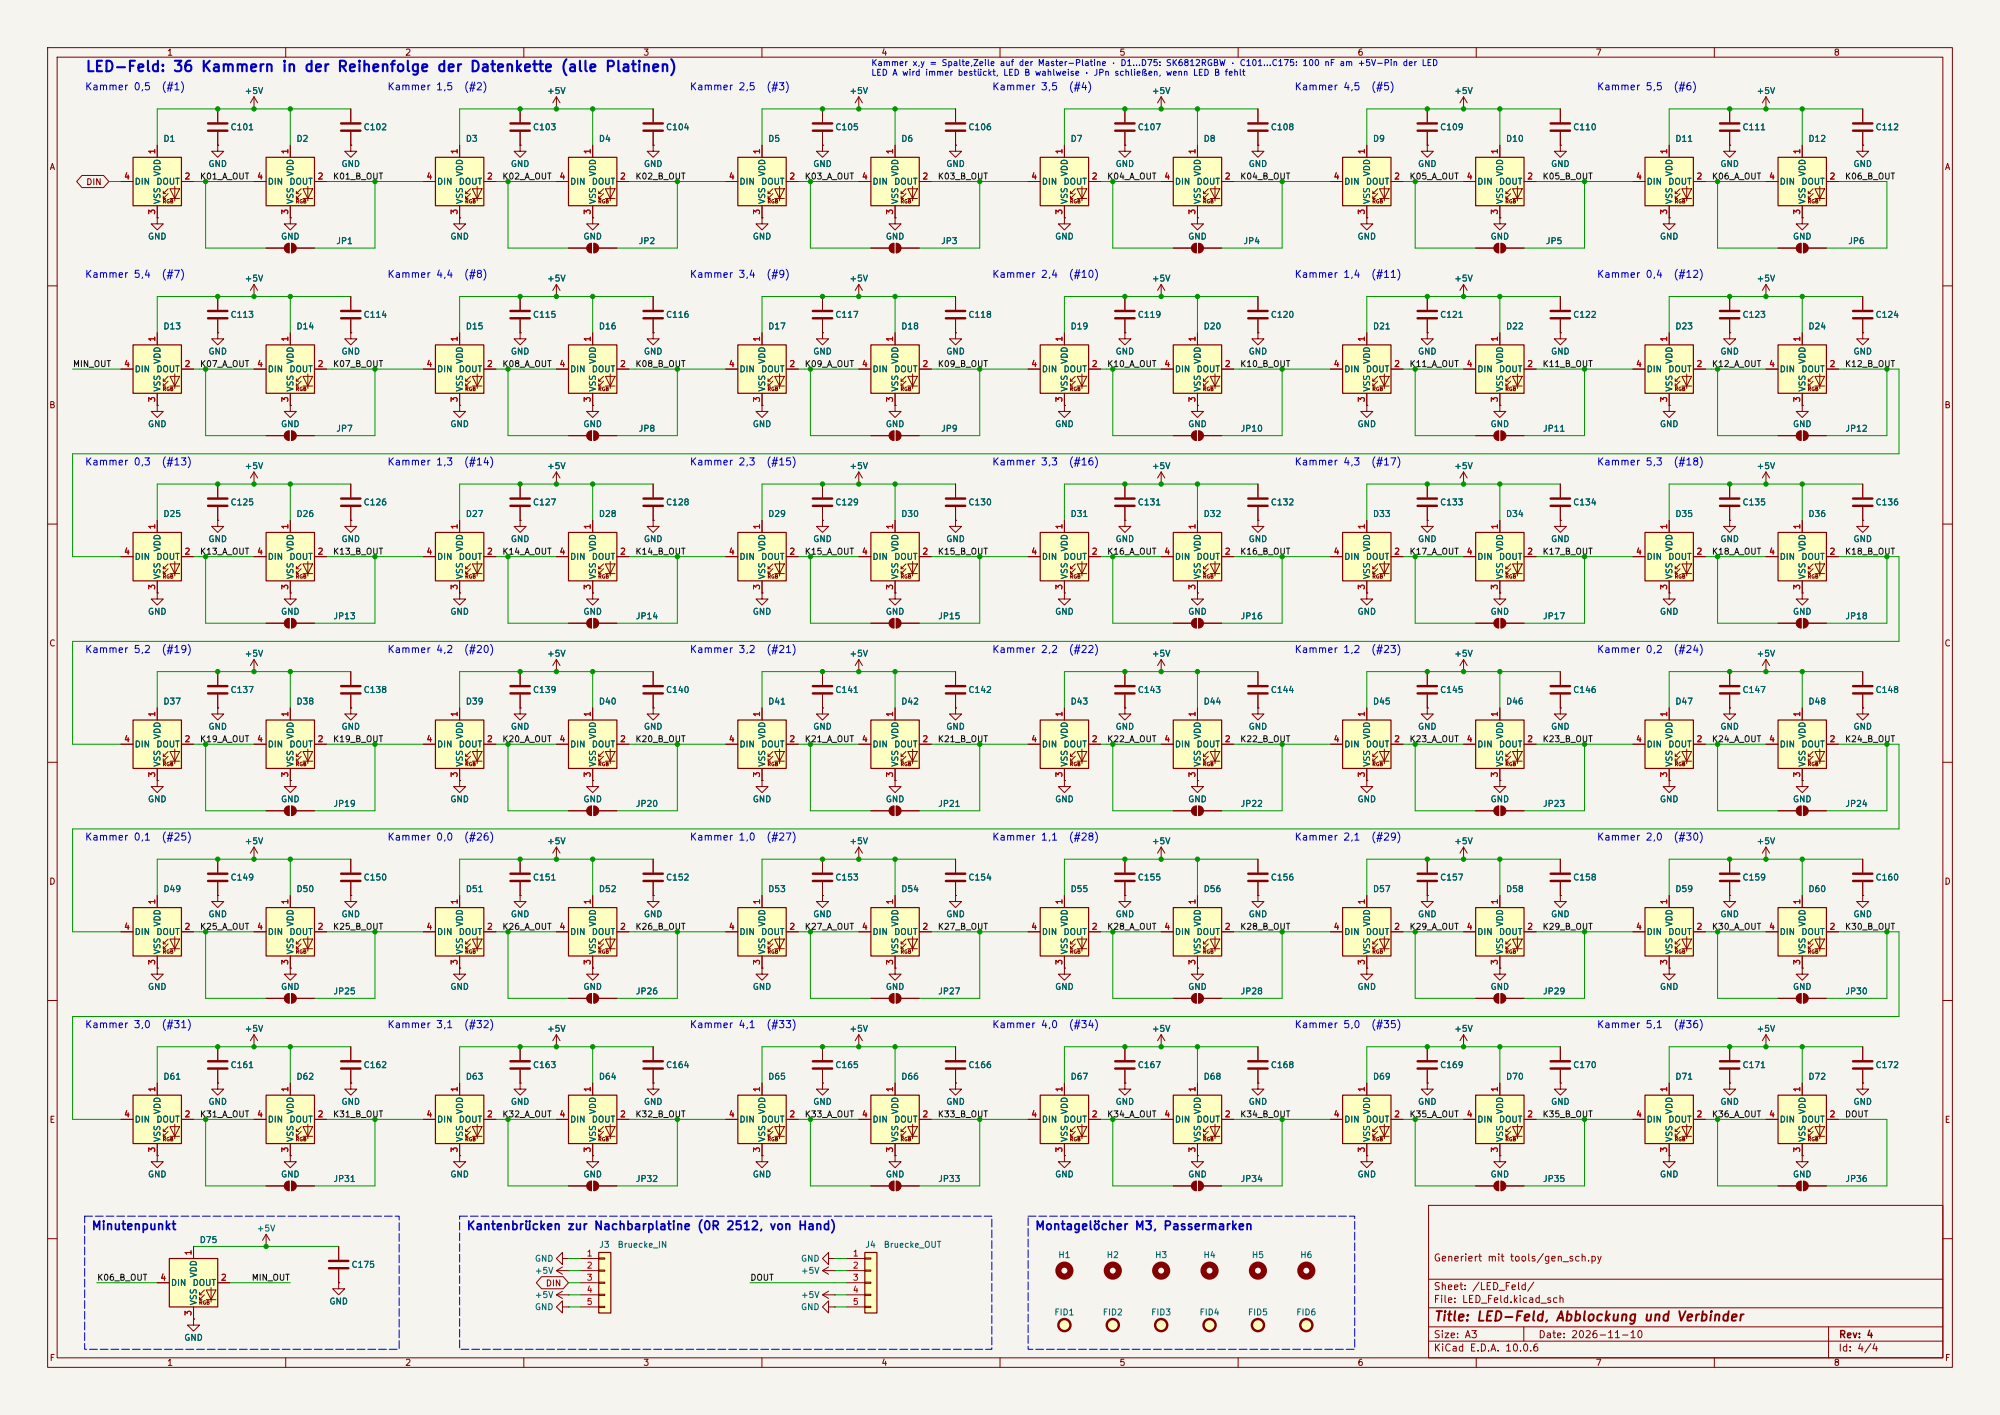
[picture p56: page 4]

LED-Feld: 36 Kammern in der Reihenfolge der Datenkette (alle Platinen)

Kammer x,y = Spalte,Zeile auf der Master-Platine · D1…D75: SK6812RGBW · C101…C175: 100 nF am +5V-Pin der LED
LED A wird immer bestückt, LED B wahlweise · JPn schließen, wenn LED B fehlt Kammer 2,2 (#22)

3 DIN 4 C110 GND +5V +5V C123 GND JP6 C112 D12 VDD

Kantenbrücken zur Nachbarplatine (0R 2512, von Hand)

Generiert mit tools/gen_sch.py

Sheet: /LED_Feld/
File: LED_Feld.kicad_sch
Title: LED-Feld, Abblockung und Verbinder
