rtreichl/Wordclock/02_Electronics/KiCad/WortUhr.kicad_pcb

## KiCad design 02_Electronics/KiCad/WortUhr.kicad_pcb (2026-11-11)

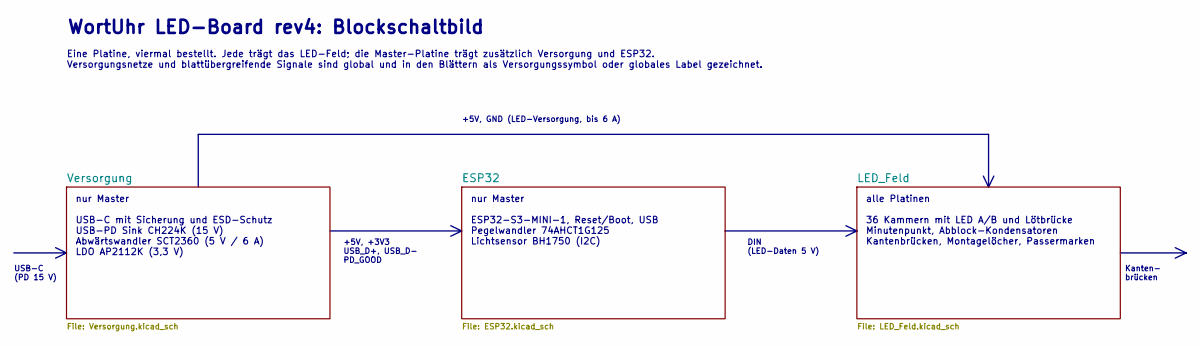
[picture p57: schematic WortUhr.kicad_sch, WortUhr LED-Board (4x identisch, Master/Slave)]

Notes on the sheet:
WortUhr LED-Board rev4: Blockschaltbild
Eine Platine, viermal bestellt. Jede trägt das LED-Feld; die Master-Platine trägt zusätzlich Versorgung und ESP32. Versorgungsnetze und blattübergreifende Signale sind global und in den Blättern als Versorgungssymbol oder globales Label gezeichnet.
nur Master USB-C mit Sicherung und ESD-Schutz USB-PD Sink CH224K (15 V) Abwärtswandler SCT2360 (5 V / 6 A) LDO AP2112K (3,3 V)
nur Master ESP32-S3-MINI-1, Reset/Boot, USB Pegelwandler 74AHCT1G125 Lichtsensor BH1750 (I2C)
alle Platinen 36 Kammern mit LED A/B und Lötbrücke Minutenpunkt, Abblock-Kondensatoren Kantenbrücken, Montagelöcher, Passermarken
+5V, +3V3 USB_D+, USB_D- PD_GOOD
DIN (LED-Daten 5 V)
+5V, GND (LED-Versorgung, bis 6 A)
USB-C (PD 15 V)
Kanten- brücken

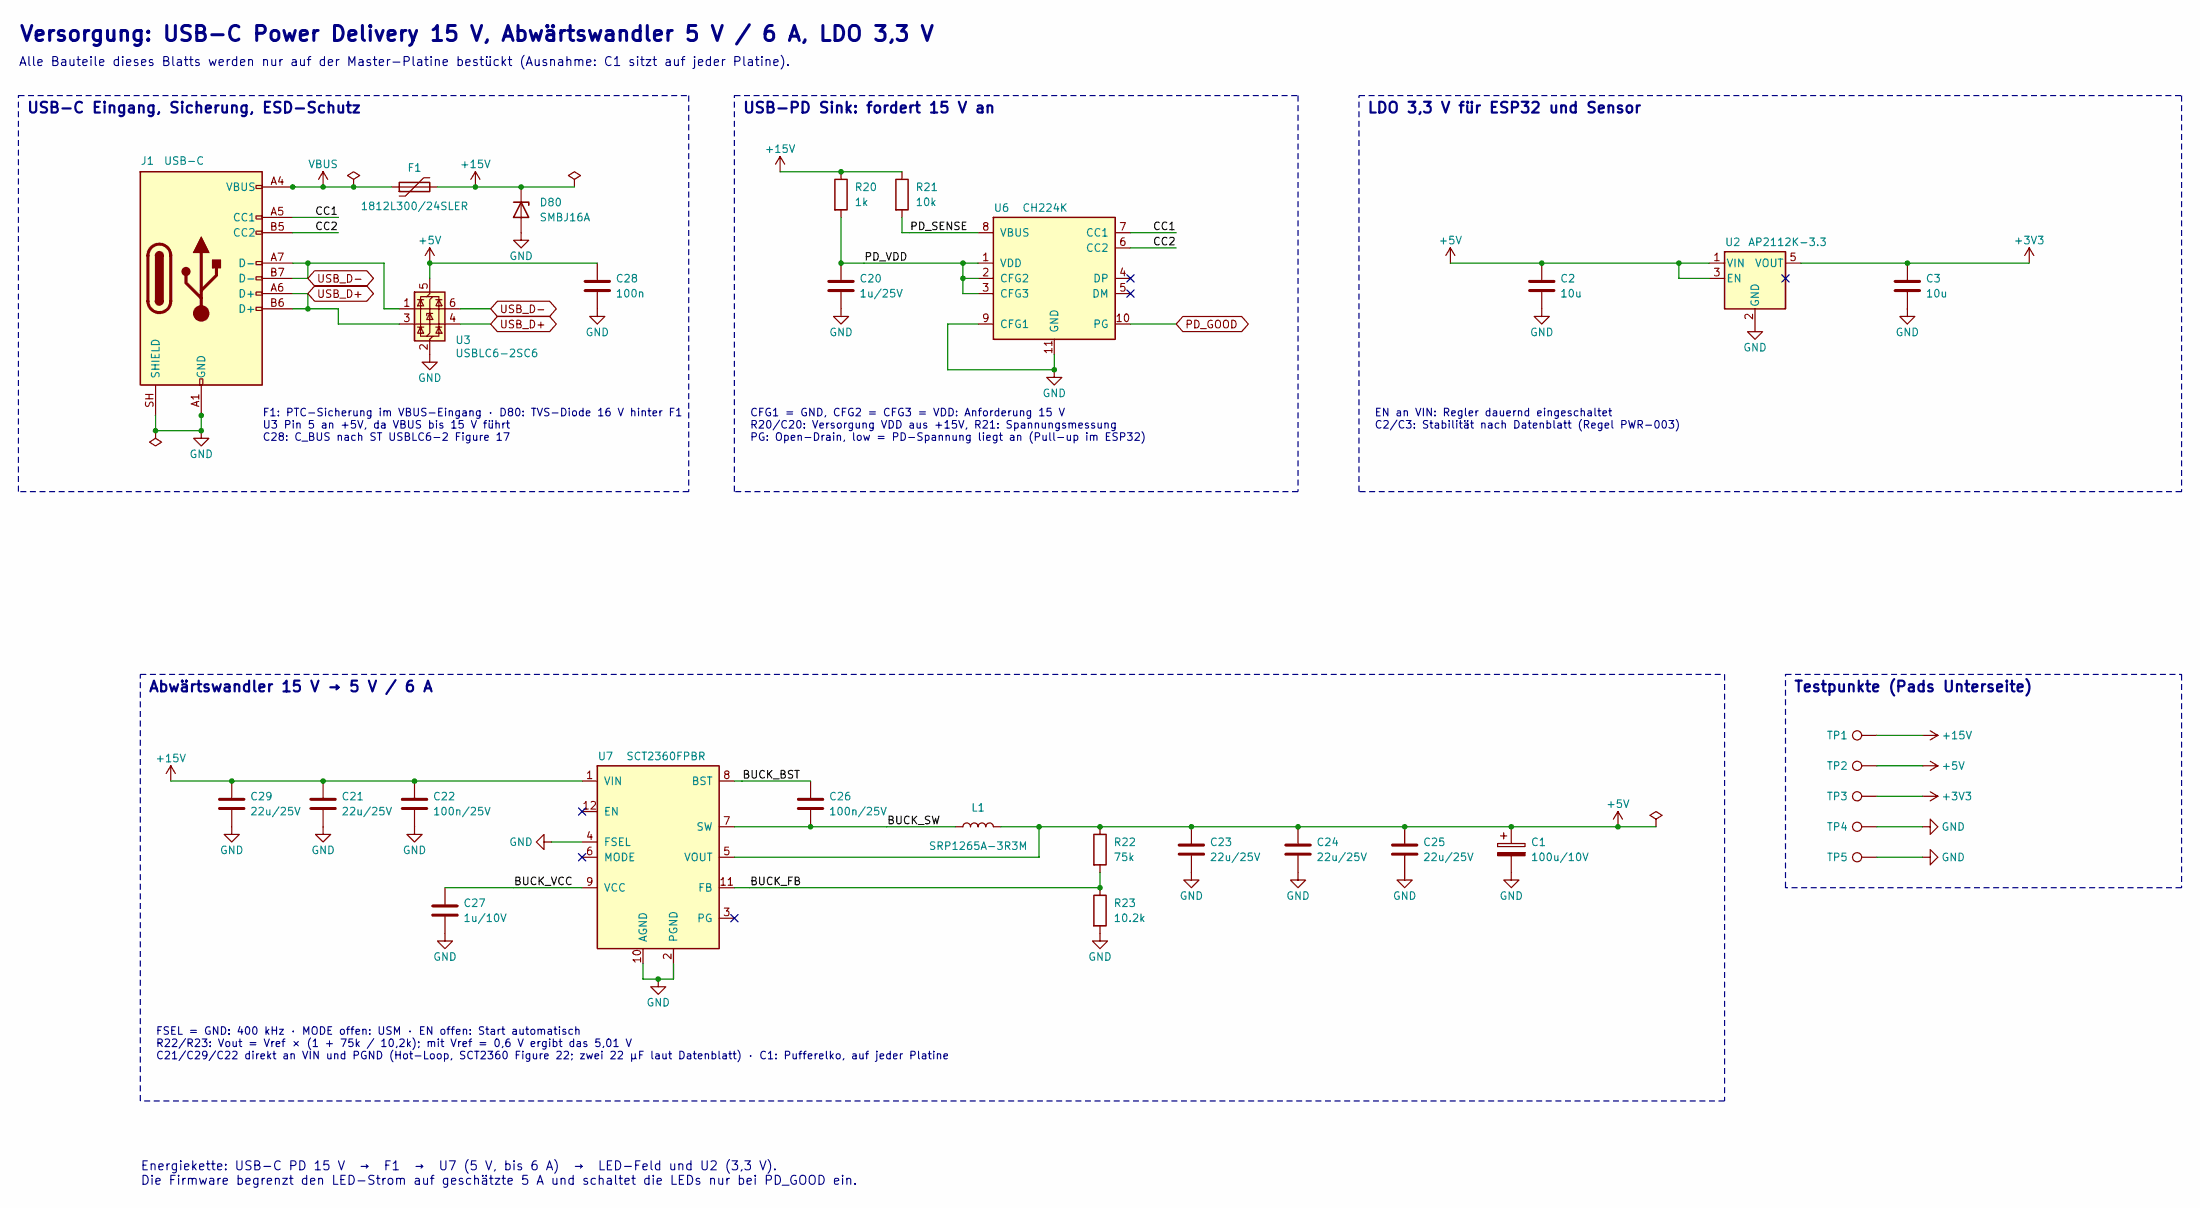
[picture p58: schematic Versorgung.kicad_sch, Versorgung: USB-C PD, Wandler, LDO]

Parts:
C1: 100u/10V; CP_Elec_6.3x7.7; MPN UWT1A101MCL1GB; DigiKey 493-2165-1-ND
C2, C3: 10u; C_0805_2012Metric; MPN TMK212BBJ106MG-T; DigiKey 587-6025-1-ND
C20: 1u/25V; C_0603_1608Metric; MPN C0603C105K3RACTU; DigiKey 399-C0603C105K3RACTUCT-ND
C21, C23, C24, C25, C29: 22u/25V; C_1206_3216Metric; MPN CC1206MKX5R8BB226; DigiKey 311-3522-1-ND
C22, C26: 100n/25V; C_0603_1608Metric; MPN C0603C104K5RACTU; DigiKey 399-C0603C104K5RACTUCT-ND
C27: 1u/10V; C_0603_1608Metric; MPN C0603C105K3RACTU; DigiKey 399-C0603C105K3RACTUCT-ND
C28: 100n; C_0603_1608Metric; MPN C0603C104K5RACTU; DigiKey 399-C0603C104K5RACTUCT-ND
D80: SMBJ16A; D_SMB; MPN SMBJ16A
F1: 1812L300/24SLER; Fuse_1812_4532Metric; MPN 1812L300/24SLER; DigiKey 18-1812L300/24SLERCT-ND
J1: USB-C; USB_C_Receptacle_HRO_TYPE-C-31-M-12; MPN TYPE-C-31-M-12
L1: SRP1265A-3R3M; L_Bourns_SRP1245A; MPN SRP1265A-3R3M; DigiKey SRP1265A-3R3MCT-ND
R20: 1k; R_1206_3216Metric; MPN RC1206FR-071KL; DigiKey 311-1.00KFRCT-ND
R21: 10k; R_0603_1608Metric; MPN ERJ-3EKF1002V; DigiKey P10.0KHCT-ND
R22: 75k; R_0603_1608Metric; MPN ERJ-3EKF7502V; DigiKey P75.0KHCT-ND
R23: 10.2k; R_0603_1608Metric; MPN ERJ-3EKF1022V; DigiKey P10.2KHCT-ND
TP1: +15V; TestPoint_Pad_D1.5mm
TP2: +5V; TestPoint_Pad_D1.5mm
TP3: +3V3; TestPoint_Pad_D1.5mm
TP4, TP5: GND; TestPoint_Pad_D1.5mm
U2: AP2112K-3.3; SOT-23-5; MPN AP2112K-3.3TRG1; DigiKey AP2112K-3.3TRG1DICT-ND
U3: USBLC6-2SC6; SOT-23-6; MPN USBLC6-2SC6; DigiKey 497-5235-1-ND
U6: CH224K; SSOP-10-1EP_3.9x4.9mm_P1mm_EP2.1x3.3mm; MPN CH224K
U7: SCT2360FPBR; QFN-12_SCT2360; MPN SCT2360FPBR

Connections:
+3V3: C3.1, TP3.1, U2.5 (VOUT); also elsewhere on the board
+5V: C1.1, C2.1, C23.1, C24.1, C25.1, C28.1, L1.2, R22.1, TP2.1, U2.1 (VIN), U2.3 (EN), U3.5 (VBUS), U7.5 (VOUT); also elsewhere on the board
+15V: C21.1, C22.1, C29.1, D80.1 (K), F1.2, R20.1, R21.1, TP1.1, U7.1 (VIN)
/Versorgung/BUCK_BST: C26.1, U7.8 (BST)
/Versorgung/BUCK_FB: R22.2, R23.1, U7.11 (FB)
/Versorgung/BUCK_SW: C26.2, L1.1, U7.7 (SW)
/Versorgung/BUCK_VCC: C27.1, U7.9 (VCC)
/Versorgung/CC1: J1.A5 (CC1), U6.7 (CC1)
/Versorgung/CC2: J1.B5 (CC2), U6.6 (CC2)
/Versorgung/PD_SENSE: R21.2, U6.8 (VBUS)
/Versorgung/PD_VDD: C20.1, R20.2, U6.1 (VDD), U6.2 (CFG2), U6.3 (CFG3)
GND: C1.2, C2.2, C3.2, C20.2, C21.2, C22.2, C23.2, C24.2, C25.2, C27.2, C28.2, C29.2, D80.2 (A), J1.A1 (GND), J1.A12 (GND), J1.B1 (GND), J1.B12 (GND), J1.SH (SHIELD), R23.2, TP4.1, TP5.1, U2.2 (GND), U3.2 (GND), U6.9 (CFG1), U6.11 (GND), U7.2 (PGND), U7.4 (FSEL), U7.10 (AGND); also elsewhere on the board
PD_GOOD: U6.10 (PG); also elsewhere on the board
USB_D+: J1.A6 (D+), J1.B6 (D+), U3.3 (I/O2), U3.4 (I/O2); also elsewhere on the board
USB_D-: J1.A7 (D-), J1.B7 (D-), U3.1 (I/O1), U3.6 (I/O1); also elsewhere on the board
VBUS: F1.1, J1.A4 (VBUS), J1.A9 (VBUS), J1.B4 (VBUS), J1.B9 (VBUS)

Notes on the sheet:
Versorgung: USB-C Power Delivery 15 V, Abwärtswandler 5 V / 6 A, LDO 3,3 V
Alle Bauteile dieses Blatts werden nur auf der Master-Platine bestückt (Ausnahme: C1 sitzt auf jeder Platine).
USB-C Eingang, Sicherung, ESD-Schutz
F1: PTC-Sicherung im VBUS-Eingang · D80: TVS-Diode 16 V hinter F1 U3 Pin 5 an +5V, da VBUS bis 15 V führt C28: C_BUS nach ST USBLC6-2 Figure 17
USB-PD Sink: fordert 15 V an
CFG1 = GND, CFG2 = CFG3 = VDD: Anforderung 15 V R20/C20: Versorgung VDD aus +15V, R21: Spannungsmessung PG: Open-Drain, low = PD-Spannung liegt an (Pull-up im ESP32)
LDO 3,3 V für ESP32 und Sensor
EN an VIN: Regler dauernd eingeschaltet C2/C3: Stabilität nach Datenblatt (Regel PWR-003)
Abwärtswandler 15 V → 5 V / 6 A
FSEL = GND: 400 kHz · MODE offen: USM · EN offen: Start automatisch R22/R23: Vout = Vref × (1 + 75k / 10,2k); mit Vref = 0,6 V ergibt das 5,01 V C21/C29/C22 direkt an VIN und PGND (Hot-Loop, SCT2360 Figure 22; zwei 22 µF laut Datenblatt) · C1: Pufferelko, auf jeder Platine
Testpunkte (Pads Unterseite)
Energiekette: USB-C PD 15 V → F1 → U7 (5 V, bis 6 A) → LED-Feld und U2 (3,3 V). Die Firmware begrenzt den LED-Strom auf geschätzte 5 A und schaltet die LEDs nur bei PD_GOOD ein.

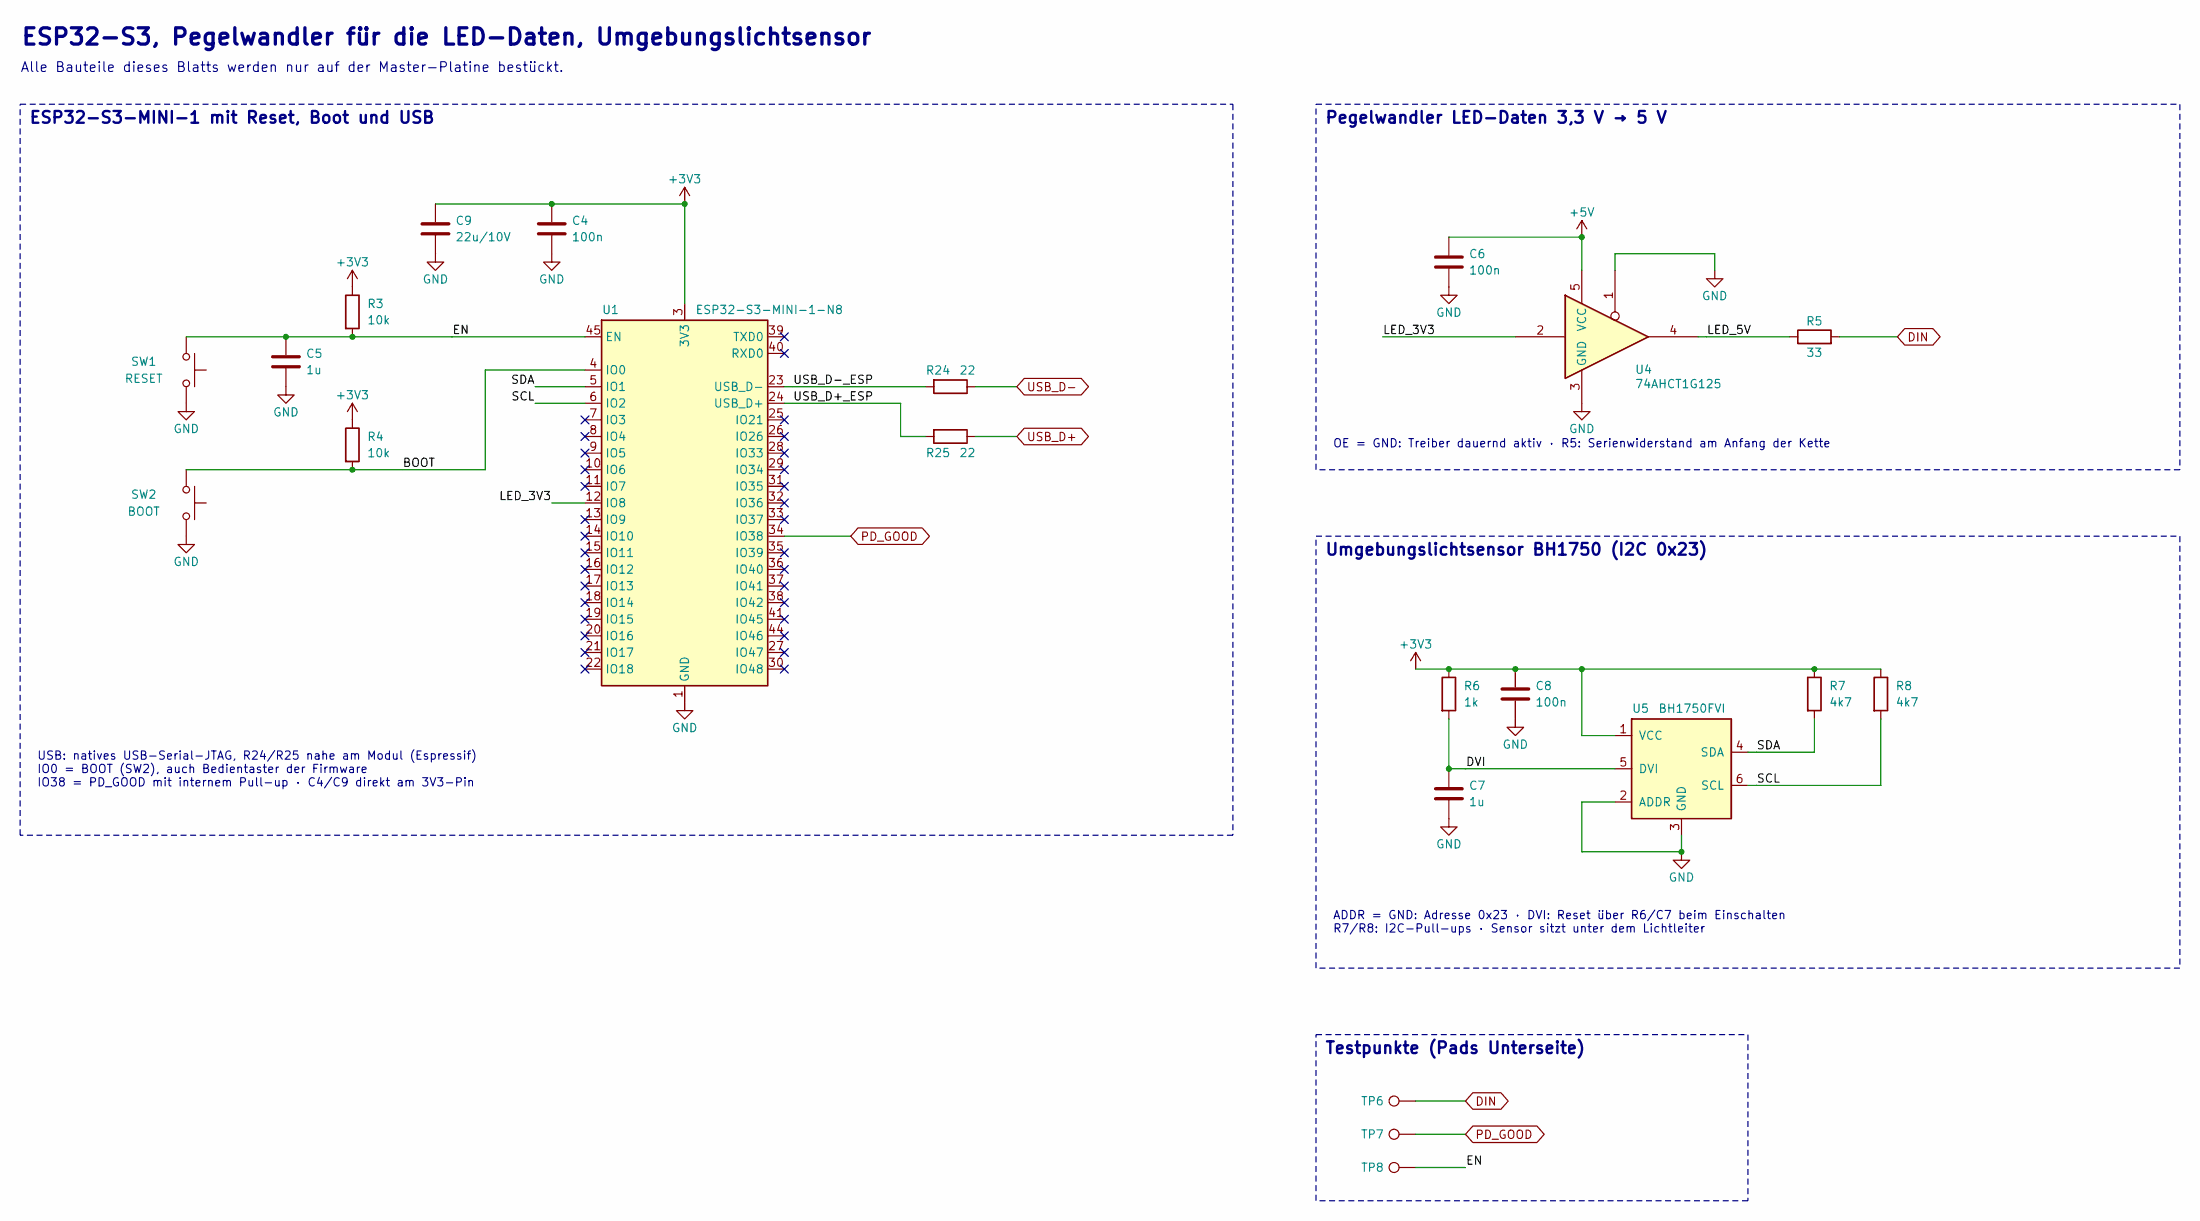
[picture p59: schematic ESP32.kicad_sch, ESP32-S3, Pegelwandler, Lichtsensor]

Parts:
C4, C6, C8: 100n; C_0603_1608Metric; MPN C0603C104K5RACTU; DigiKey 399-C0603C104K5RACTUCT-ND
C5, C7: 1u; C_0603_1608Metric; MPN C0603C105K3RACTU; DigiKey 399-C0603C105K3RACTUCT-ND
C9: 22u/10V; C_0805_2012Metric; MPN C0805C226M8PACTU; DigiKey 399-C0805C226M8PACTUCT-ND
R3, R4: 10k; R_0603_1608Metric; MPN ERJ-3EKF1002V; DigiKey P10.0KHCT-ND
R5: 33; R_0603_1608Metric; MPN ERJ-3EKF33R0V; DigiKey P33.0HCT-ND
R6: 1k; R_0603_1608Metric; MPN ERJ-3EKF1001V; DigiKey P1.00KHCT-ND
R7, R8: 4k7; R_0603_1608Metric; MPN ERJ-3EKF4701V; DigiKey P4.70KHCT-ND
R24, R25: 22; R_0402_1005Metric; MPN ERJ-2RKF22R0X; DigiKey P22.0LCT-ND
SW1: RESET; SW_SPST_TL3342; MPN TL3342F160QG/TR; DigiKey EG2531CT-ND
SW2: BOOT; SW_SPST_TL3342; MPN TL3342F160QG/TR; DigiKey EG2531CT-ND
TP6: DIN; TestPoint_Pad_D1.5mm
TP7: PD_GOOD; TestPoint_Pad_D1.5mm
TP8: EN; TestPoint_Pad_D1.5mm
U1: ESP32-S3-MINI-1-N8; ESP32-S2-MINI-1; MPN ESP32-S3-MINI-1-N8; DigiKey 5407-ESP32-S3-MINI-1-N8CT-ND
U4: 74AHCT1G125; SOT-23-5; MPN SN74AHCT1G125DBVR; DigiKey 296-4708-1-ND
U5: BH1750FVI; WSOF6I_BH1750; MPN BH1750FVI-TR; DigiKey BH1750FVICT-ND

Connections:
+3V3: C4.1, C8.1, C9.1, R3.1, R4.1, R6.1, R7.1, R8.1, U1.3 (3V3), U5.1 (VCC); also elsewhere on the board
+5V: C6.1, U4.5 (VCC); also elsewhere on the board
/ESP32/BOOT: R4.2, SW2.1, U1.4 (IO0)
/ESP32/DVI: C7.1, R6.2, U5.5 (DVI)
/ESP32/EN: C5.1, R3.2, SW1.1, TP8.1, U1.45 (EN)
/ESP32/LED_3V3: U1.12 (IO8), U4.2
/ESP32/LED_5V: R5.1, U4.4
/ESP32/SCL: R8.2, U1.6 (IO2), U5.6 (SCL)
/ESP32/SDA: R7.2, U1.5 (IO1), U5.4 (SDA)
/ESP32/USB_D+_ESP: R25.2, U1.24 (USB_D+)
/ESP32/USB_D-_ESP: R24.2, U1.23 (USB_D-)
DIN: R5.2, TP6.1; also elsewhere on the board
GND: C4.2, C5.2, C6.2, C7.2, C8.2, C9.2, SW1.2, SW2.2, U1.1 (GND), U1.2 (GND), U1.42 (GND), U1.43 (GND), U1.46 (GND), U1.47 (GND), U1.48 (GND), U1.49 (GND), U1.50 (GND), U1.51 (GND), U1.52 (GND), U1.53 (GND), U1.54 (GND), U1.55 (GND), U1.56 (GND), U1.57 (GND), U1.58 (GND), U1.59 (GND), U1.60 (GND), U1.61 (GND), U1.62 (GND), U1.63 (GND), U1.64 (GND), U1.65 (GND), U4.1, U4.3 (GND), U5.2 (ADDR), U5.3 (GND); also elsewhere on the board
PD_GOOD: TP7.1, U1.34 (IO38); also elsewhere on the board
USB_D+: R25.1; also elsewhere on the board
USB_D-: R24.1; also elsewhere on the board

Notes on the sheet:
ESP32-S3, Pegelwandler für die LED-Daten, Umgebungslichtsensor
Alle Bauteile dieses Blatts werden nur auf der Master-Platine bestückt.
ESP32-S3-MINI-1 mit Reset, Boot und USB
USB: natives USB-Serial-JTAG, R24/R25 nahe am Modul (Espressif) IO0 = BOOT (SW2), auch Bedientaster der Firmware IO38 = PD_GOOD mit internem Pull-up · C4/C9 direkt am 3V3-Pin
Pegelwandler LED-Daten 3,3 V → 5 V
OE = GND: Treiber dauernd aktiv · R5: Serienwiderstand am Anfang der Kette
Umgebungslichtsensor BH1750 (I2C 0x23)
ADDR = GND: Adresse 0x23 · DVI: Reset über R6/C7 beim Einschalten R7/R8: I2C-Pull-ups · Sensor sitzt unter dem Lichtleiter
Testpunkte (Pads Unterseite)

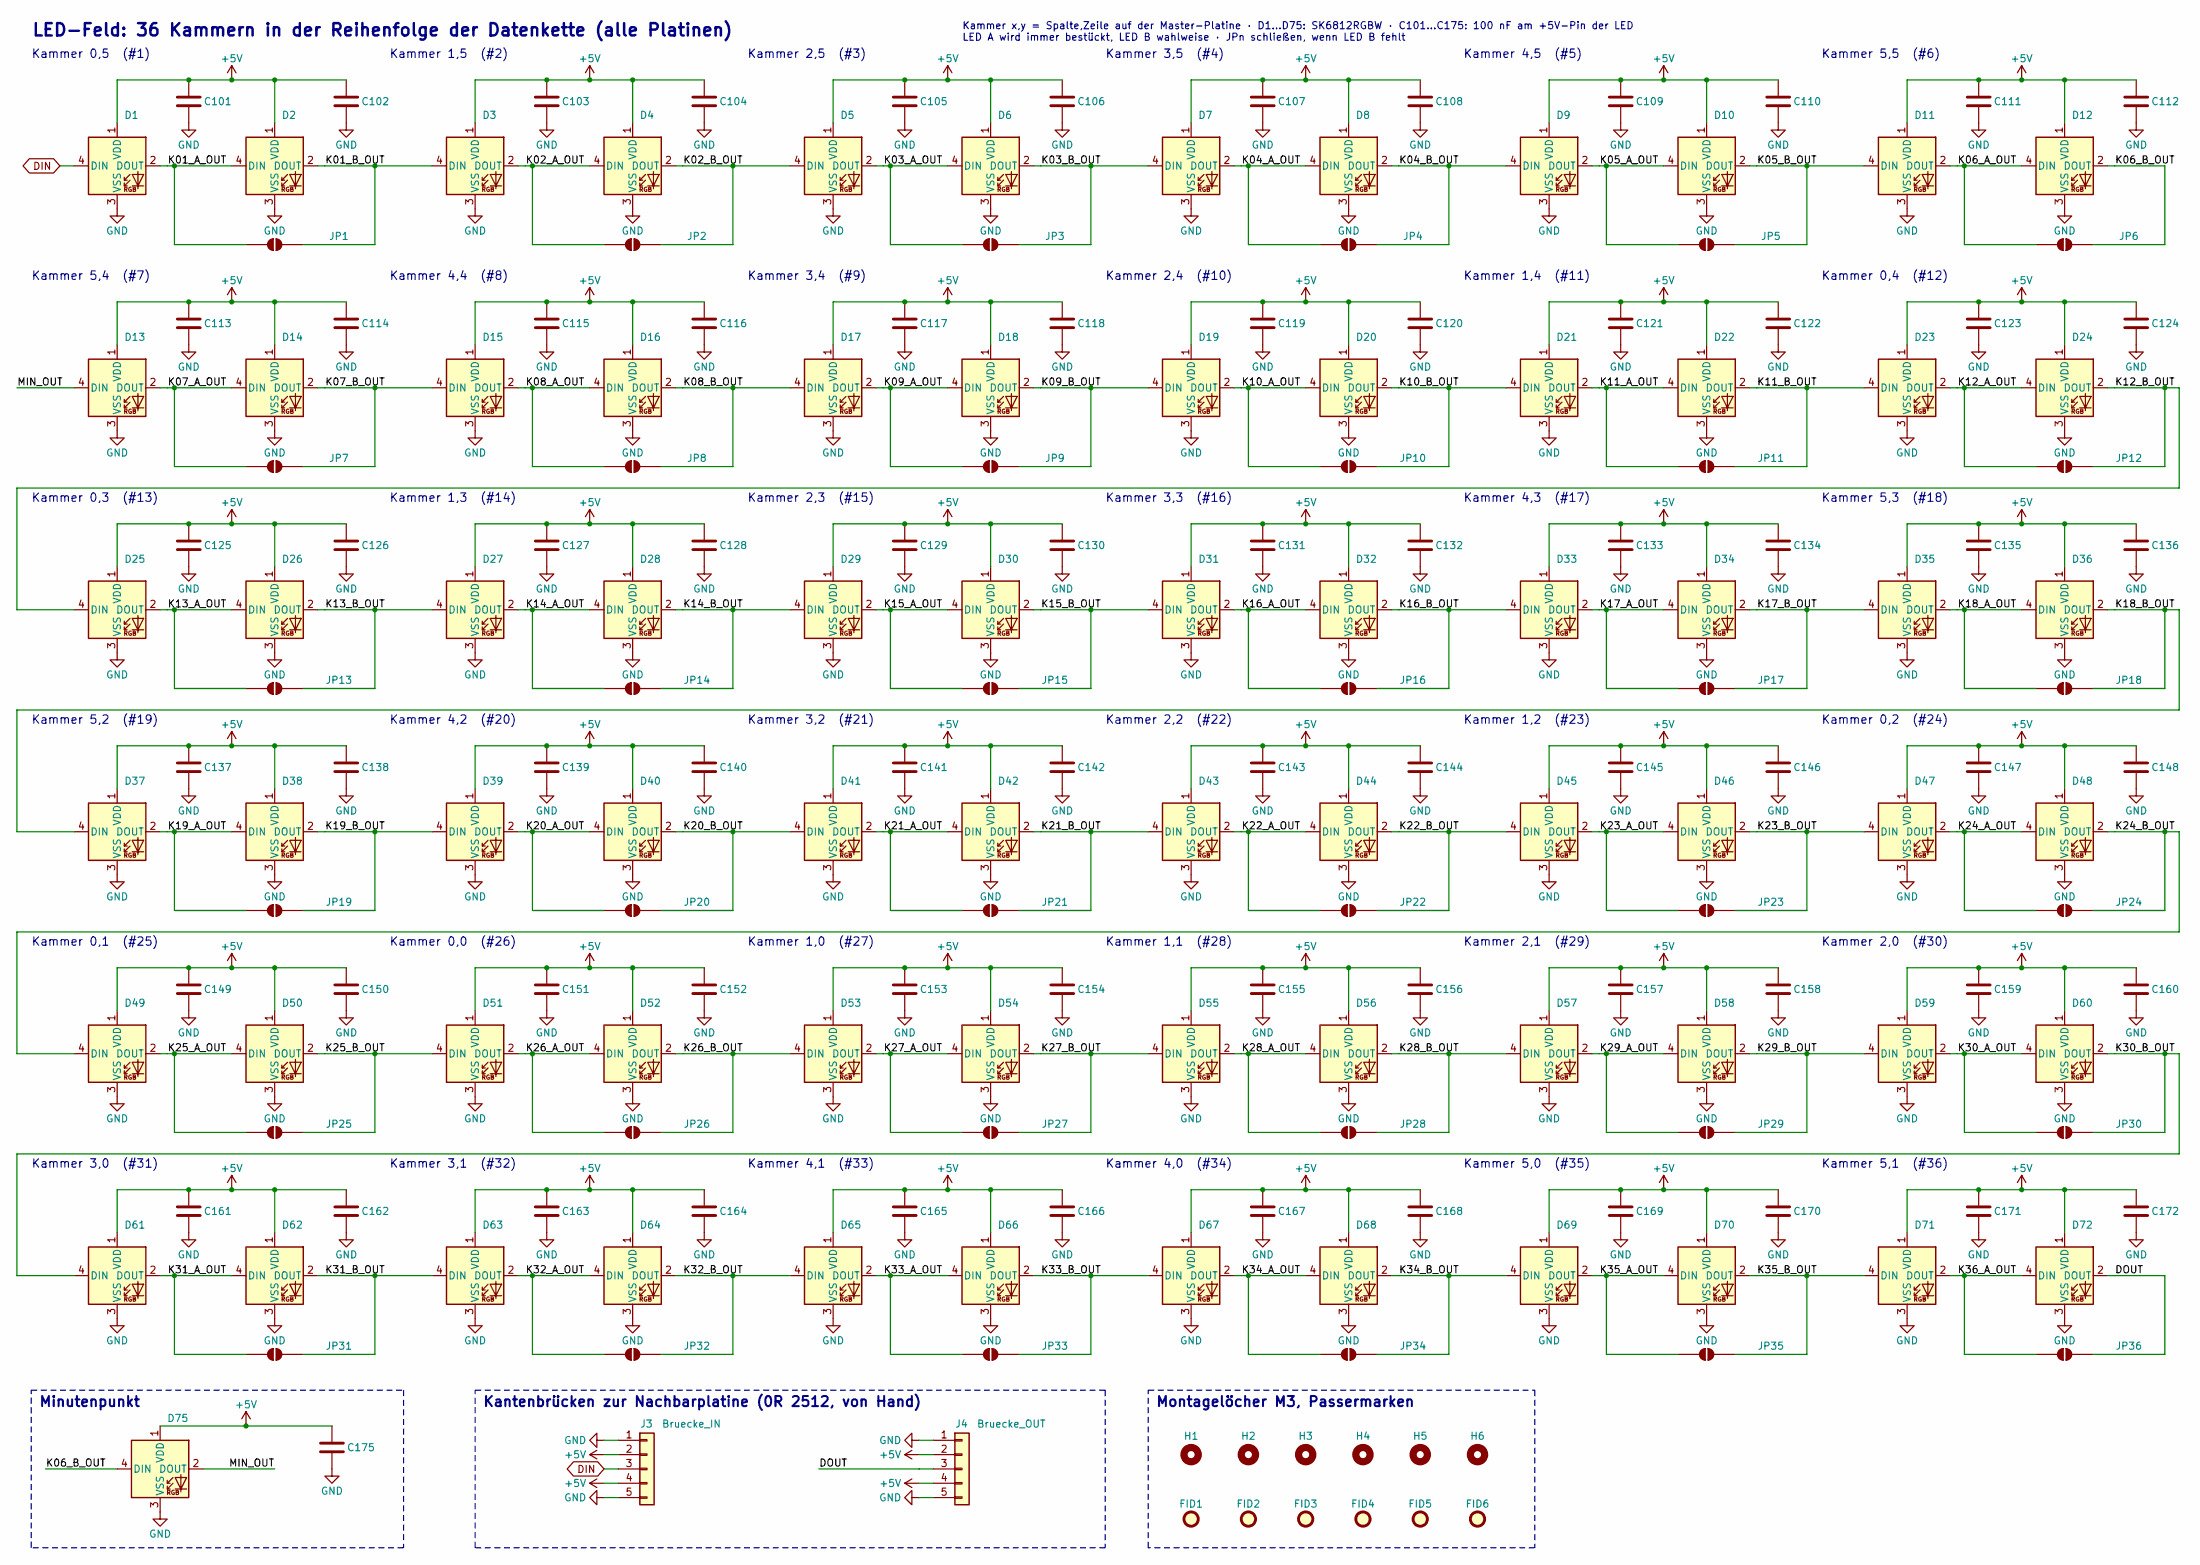
[picture p60: schematic LED_Feld.kicad_sch, LED-Feld, Abblockung und Verbinder]

Parts:
C101, C102, C103, C104, C105, C106, C107, C108, C109, C110, C111, C112, C113, C114, C115, C116, C117, C118, C119, C120, C121, C122, C123, C124, C125, C126, C127, C128, C129, C130, C131, C132, C133, C134, C135, C136, C137, C138, C139, C140, C141, C142, C143, C144, C145, C146, C147, C148, C149, C150, C151, C152, C153, C154, C155, C156, C157, C158, C159, C160, C161, C162, C163, C164, C165, C166, C167, C168, C169, C170, C171, C172, C175: 100n; C_0603_1608Metric; MPN C0603C104K5RACTU; DigiKey 399-C0603C104K5RACTUCT-ND
D1, D2, D3, D4, D5, D6, D7, D8, D9, D10, D11, D12, D13, D14, D15, D16, D17, D18, D19, D20, D21, D22, D23, D24, D25, D26, D27, D28, D29, D30, D31, D32, D33, D34, D35, D36, D37, D38, D39, D40, D41, D42, D43, D44, D45, D46, D47, D48, D49, D50, D51, D52, D53, D54, D55, D56, D57, D58, D59, D60, D61, D62, D63, D64, D65, D66, D67, D68, D69, D70, D71, D72, D75: SK6812RGBW; LED_WS2812B_PLCC4_5.0x5.0mm_P3.2mm
FID1, FID2, FID3, FID4, FID5, FID6: Fiducial; Fiducial_1mm_Mask2mm
H1, H2, H3, H4, H5, H6: M3; MountingHole_4.3mm_M4
J3: Bruecke_IN; EdgeBridge_5x2512
J4: Bruecke_OUT; EdgeBridge_5x2512
JP1, JP2, JP3, JP4, JP5, JP6, JP7, JP8, JP9, JP10, JP11, JP12, JP13, JP14, JP15, JP16, JP17, JP18, JP19, JP20, JP21, JP22, JP23, JP24, JP25, JP26, JP27, JP28, JP29, JP30, JP31, JP32, JP33, JP34, JP35, JP36: Bruecke LED B; SolderJumper-2_P1.3mm_Open_RoundedPad1.0x1.5mm

Connections:
+5V: C101.2, C102.2, C103.2, C104.2, C105.2, C106.2, C107.2, C108.2, C109.2, C110.2, C111.2, C112.2, C113.2, C114.2, C115.2, C116.2, C117.2, C118.2, C119.2, C120.2, C121.2, C122.2, C123.2, C124.2, C125.2, C126.2, C127.2, C128.2, C129.2, C130.2, C131.2, C132.2, C133.2, C134.2, C135.2, C136.2, C137.2, C138.2, C139.2, C140.2, C141.2, C142.2, C143.2, C144.2, C145.2, C146.2, C147.2, C148.2, C149.2, C150.2, C151.2, C152.2, C153.2, C154.2, C155.2, C156.2, C157.2, C158.2, C159.2, C160.2, C161.2, C162.2, C163.2, C164.2, C165.2, C166.2, C167.2, C168.2, C169.2, C170.2, C171.2, C172.2, C175.2, D1.1 (VDD), D2.1 (VDD), D3.1 (VDD), D4.1 (VDD), D5.1 (VDD), D6.1 (VDD), D7.1 (VDD), D8.1 (VDD), D9.1 (VDD), D10.1 (VDD), D11.1 (VDD), D12.1 (VDD), D13.1 (VDD), D14.1 (VDD), D15.1 (VDD), D16.1 (VDD), D17.1 (VDD), D18.1 (VDD), D19.1 (VDD), D20.1 (VDD), D21.1 (VDD), D22.1 (VDD), D23.1 (VDD), D24.1 (VDD), D25.1 (VDD), D26.1 (VDD), D27.1 (VDD), D28.1 (VDD), D29.1 (VDD), D30.1 (VDD), D31.1 (VDD), D32.1 (VDD), D33.1 (VDD), D34.1 (VDD), D35.1 (VDD), D36.1 (VDD), D37.1 (VDD), D38.1 (VDD), D39.1 (VDD), D40.1 (VDD), D41.1 (VDD), D42.1 (VDD), D43.1 (VDD), D44.1 (VDD), D45.1 (VDD), D46.1 (VDD), D47.1 (VDD), D48.1 (VDD), D49.1 (VDD), D50.1 (VDD), D51.1 (VDD), D52.1 (VDD), D53.1 (VDD), D54.1 (VDD), D55.1 (VDD), D56.1 (VDD), D57.1 (VDD), D58.1 (VDD), D59.1 (VDD), D60.1 (VDD), D61.1 (VDD), D62.1 (VDD), D63.1 (VDD), D64.1 (VDD), D65.1 (VDD), D66.1 (VDD), D67.1 (VDD), D68.1 (VDD), D69.1 (VDD), D70.1 (VDD), D71.1 (VDD), D72.1 (VDD), D75.1 (VDD), J3.2, J3.4, J4.2, J4.4; also elsewhere on the board
/LED_Feld/DOUT: D72.2 (DOUT), J4.3, JP36.2 (B)
/LED_Feld/K01_A_OUT: D1.2 (DOUT), D2.4 (DIN), JP1.1 (A)
/LED_Feld/K01_B_OUT: D2.2 (DOUT), D3.4 (DIN), JP1.2 (B)
/LED_Feld/K02_A_OUT: D3.2 (DOUT), D4.4 (DIN), JP2.1 (A)
/LED_Feld/K02_B_OUT: D4.2 (DOUT), D5.4 (DIN), JP2.2 (B)
/LED_Feld/K03_A_OUT: D5.2 (DOUT), D6.4 (DIN), JP3.1 (A)
/LED_Feld/K03_B_OUT: D6.2 (DOUT), D7.4 (DIN), JP3.2 (B)
/LED_Feld/K04_A_OUT: D7.2 (DOUT), D8.4 (DIN), JP4.1 (A)
/LED_Feld/K04_B_OUT: D8.2 (DOUT), D9.4 (DIN), JP4.2 (B)
/LED_Feld/K05_A_OUT: D9.2 (DOUT), D10.4 (DIN), JP5.1 (A)
/LED_Feld/K05_B_OUT: D10.2 (DOUT), D11.4 (DIN), JP5.2 (B)
/LED_Feld/K06_A_OUT: D11.2 (DOUT), D12.4 (DIN), JP6.1 (A)
/LED_Feld/K06_B_OUT: D12.2 (DOUT), D75.4 (DIN), JP6.2 (B)
/LED_Feld/K07_A_OUT: D13.2 (DOUT), D14.4 (DIN), JP7.1 (A)
/LED_Feld/K07_B_OUT: D14.2 (DOUT), D15.4 (DIN), JP7.2 (B)
/LED_Feld/K08_A_OUT: D15.2 (DOUT), D16.4 (DIN), JP8.1 (A)
/LED_Feld/K08_B_OUT: D16.2 (DOUT), D17.4 (DIN), JP8.2 (B)
/LED_Feld/K09_A_OUT: D17.2 (DOUT), D18.4 (DIN), JP9.1 (A)
/LED_Feld/K09_B_OUT: D18.2 (DOUT), D19.4 (DIN), JP9.2 (B)
/LED_Feld/K10_A_OUT: D19.2 (DOUT), D20.4 (DIN), JP10.1 (A)
/LED_Feld/K10_B_OUT: D20.2 (DOUT), D21.4 (DIN), JP10.2 (B)
/LED_Feld/K11_A_OUT: D21.2 (DOUT), D22.4 (DIN), JP11.1 (A)
/LED_Feld/K11_B_OUT: D22.2 (DOUT), D23.4 (DIN), JP11.2 (B)
/LED_Feld/K12_A_OUT: D23.2 (DOUT), D24.4 (DIN), JP12.1 (A)
/LED_Feld/K12_B_OUT: D24.2 (DOUT), D25.4 (DIN), JP12.2 (B)
/LED_Feld/K13_A_OUT: D25.2 (DOUT), D26.4 (DIN), JP13.1 (A)
/LED_Feld/K13_B_OUT: D26.2 (DOUT), D27.4 (DIN), JP13.2 (B)
/LED_Feld/K14_A_OUT: D27.2 (DOUT), D28.4 (DIN), JP14.1 (A)
/LED_Feld/K14_B_OUT: D28.2 (DOUT), D29.4 (DIN), JP14.2 (B)
/LED_Feld/K15_A_OUT: D29.2 (DOUT), D30.4 (DIN), JP15.1 (A)
/LED_Feld/K15_B_OUT: D30.2 (DOUT), D31.4 (DIN), JP15.2 (B)
/LED_Feld/K16_A_OUT: D31.2 (DOUT), D32.4 (DIN), JP16.1 (A)
/LED_Feld/K16_B_OUT: D32.2 (DOUT), D33.4 (DIN), JP16.2 (B)
/LED_Feld/K17_A_OUT: D33.2 (DOUT), D34.4 (DIN), JP17.1 (A)
/LED_Feld/K17_B_OUT: D34.2 (DOUT), D35.4 (DIN), JP17.2 (B)
/LED_Feld/K18_A_OUT: D35.2 (DOUT), D36.4 (DIN), JP18.1 (A)
/LED_Feld/K18_B_OUT: D36.2 (DOUT), D37.4 (DIN), JP18.2 (B)
/LED_Feld/K19_A_OUT: D37.2 (DOUT), D38.4 (DIN), JP19.1 (A)
/LED_Feld/K19_B_OUT: D38.2 (DOUT), D39.4 (DIN), JP19.2 (B)
/LED_Feld/K20_A_OUT: D39.2 (DOUT), D40.4 (DIN), JP20.1 (A)
/LED_Feld/K20_B_OUT: D40.2 (DOUT), D41.4 (DIN), JP20.2 (B)
/LED_Feld/K21_A_OUT: D41.2 (DOUT), D42.4 (DIN), JP21.1 (A)
/LED_Feld/K21_B_OUT: D42.2 (DOUT), D43.4 (DIN), JP21.2 (B)
/LED_Feld/K22_A_OUT: D43.2 (DOUT), D44.4 (DIN), JP22.1 (A)
/LED_Feld/K22_B_OUT: D44.2 (DOUT), D45.4 (DIN), JP22.2 (B)
/LED_Feld/K23_A_OUT: D45.2 (DOUT), D46.4 (DIN), JP23.1 (A)
/LED_Feld/K23_B_OUT: D46.2 (DOUT), D47.4 (DIN), JP23.2 (B)
/LED_Feld/K24_A_OUT: D47.2 (DOUT), D48.4 (DIN), JP24.1 (A)
/LED_Feld/K24_B_OUT: D48.2 (DOUT), D49.4 (DIN), JP24.2 (B)
/LED_Feld/K25_A_OUT: D49.2 (DOUT), D50.4 (DIN), JP25.1 (A)
/LED_Feld/K25_B_OUT: D50.2 (DOUT), D51.4 (DIN), JP25.2 (B)
/LED_Feld/K26_A_OUT: D51.2 (DOUT), D52.4 (DIN), JP26.1 (A)
/LED_Feld/K26_B_OUT: D52.2 (DOUT), D53.4 (DIN), JP26.2 (B)
/LED_Feld/K27_A_OUT: D53.2 (DOUT), D54.4 (DIN), JP27.1 (A)
/LED_Feld/K27_B_OUT: D54.2 (DOUT), D55.4 (DIN), JP27.2 (B)
/LED_Feld/K28_A_OUT: D55.2 (DOUT), D56.4 (DIN), JP28.1 (A)
/LED_Feld/K28_B_OUT: D56.2 (DOUT), D57.4 (DIN), JP28.2 (B)
/LED_Feld/K29_A_OUT: D57.2 (DOUT), D58.4 (DIN), JP29.1 (A)
/LED_Feld/K29_B_OUT: D58.2 (DOUT), D59.4 (DIN), JP29.2 (B)
/LED_Feld/K30_A_OUT: D59.2 (DOUT), D60.4 (DIN), JP30.1 (A)
/LED_Feld/K30_B_OUT: D60.2 (DOUT), D61.4 (DIN), JP30.2 (B)
/LED_Feld/K31_A_OUT: D61.2 (DOUT), D62.4 (DIN), JP31.1 (A)
/LED_Feld/K31_B_OUT: D62.2 (DOUT), D63.4 (DIN), JP31.2 (B)
/LED_Feld/K32_A_OUT: D63.2 (DOUT), D64.4 (DIN), JP32.1 (A)
/LED_Feld/K32_B_OUT: D64.2 (DOUT), D65.4 (DIN), JP32.2 (B)
/LED_Feld/K33_A_OUT: D65.2 (DOUT), D66.4 (DIN), JP33.1 (A)
/LED_Feld/K33_B_OUT: D66.2 (DOUT), D67.4 (DIN), JP33.2 (B)
/LED_Feld/K34_A_OUT: D67.2 (DOUT), D68.4 (DIN), JP34.1 (A)
/LED_Feld/K34_B_OUT: D68.2 (DOUT), D69.4 (DIN), JP34.2 (B)
/LED_Feld/K35_A_OUT: D69.2 (DOUT), D70.4 (DIN), JP35.1 (A)
/LED_Feld/K35_B_OUT: D70.2 (DOUT), D71.4 (DIN), JP35.2 (B)
/LED_Feld/K36_A_OUT: D71.2 (DOUT), D72.4 (DIN), JP36.1 (A)
/LED_Feld/MIN_OUT: D13.4 (DIN), D75.2 (DOUT)
DIN: D1.4 (DIN), J3.3; also elsewhere on the board
GND: C101.1, C102.1, C103.1, C104.1, C105.1, C106.1, C107.1, C108.1, C109.1, C110.1, C111.1, C112.1, C113.1, C114.1, C115.1, C116.1, C117.1, C118.1, C119.1, C120.1, C121.1, C122.1, C123.1, C124.1, C125.1, C126.1, C127.1, C128.1, C129.1, C130.1, C131.1, C132.1, C133.1, C134.1, C135.1, C136.1, C137.1, C138.1, C139.1, C140.1, C141.1, C142.1, C143.1, C144.1, C145.1, C146.1, C147.1, C148.1, C149.1, C150.1, C151.1, C152.1, C153.1, C154.1, C155.1, C156.1, C157.1, C158.1, C159.1, C160.1, C161.1, C162.1, C163.1, C164.1, C165.1, C166.1, C167.1, C168.1, C169.1, C170.1, C171.1, C172.1, C175.1, D1.3 (VSS), D2.3 (VSS), D3.3 (VSS), D4.3 (VSS), D5.3 (VSS), D6.3 (VSS), D7.3 (VSS), D8.3 (VSS), D9.3 (VSS), D10.3 (VSS), D11.3 (VSS), D12.3 (VSS), D13.3 (VSS), D14.3 (VSS), D15.3 (VSS), D16.3 (VSS), D17.3 (VSS), D18.3 (VSS), D19.3 (VSS), D20.3 (VSS), D21.3 (VSS), D22.3 (VSS), D23.3 (VSS), D24.3 (VSS), D25.3 (VSS), D26.3 (VSS), D27.3 (VSS), D28.3 (VSS), D29.3 (VSS), D30.3 (VSS), D31.3 (VSS), D32.3 (VSS), D33.3 (VSS), D34.3 (VSS), D35.3 (VSS), D36.3 (VSS), D37.3 (VSS), D38.3 (VSS), D39.3 (VSS), D40.3 (VSS), D41.3 (VSS), D42.3 (VSS), D43.3 (VSS), D44.3 (VSS), D45.3 (VSS), D46.3 (VSS), D47.3 (VSS), D48.3 (VSS), D49.3 (VSS), D50.3 (VSS), D51.3 (VSS), D52.3 (VSS), D53.3 (VSS), D54.3 (VSS), D55.3 (VSS), D56.3 (VSS), D57.3 (VSS), D58.3 (VSS), D59.3 (VSS), D60.3 (VSS), D61.3 (VSS), D62.3 (VSS), D63.3 (VSS), D64.3 (VSS), D65.3 (VSS), D66.3 (VSS), D67.3 (VSS), D68.3 (VSS), D69.3 (VSS), D70.3 (VSS), D71.3 (VSS), D72.3 (VSS), D75.3 (VSS), J3.1, J3.5, J4.1, J4.5; also elsewhere on the board

Notes on the sheet:
LED-Feld: 36 Kammern in der Reihenfolge der Datenkette (alle Platinen)
Kammer x,y = Spalte,Zeile auf der Master-Platine · D1…D75: SK6812RGBW · C101…C175: 100 nF am +5V-Pin der LED LED A wird immer bestückt, LED B wahlweise · JPn schließen, wenn LED B fehlt
Kammer 0,5 (#1)
Kammer 1,5 (#2)
Kammer 2,5 (#3)
Kammer 3,5 (#4)
Kammer 4,5 (#5)
Kammer 5,5 (#6)
Kammer 5,4 (#7)
Kammer 4,4 (#8)
Kammer 3,4 (#9)
Kammer 2,4 (#10)
Kammer 1,4 (#11)
Kammer 0,4 (#12)
Kammer 0,3 (#13)
Kammer 1,3 (#14)
Kammer 2,3 (#15)
Kammer 3,3 (#16)
Kammer 4,3 (#17)
Kammer 5,3 (#18)
Kammer 5,2 (#19)
Kammer 4,2 (#20)
Kammer 3,2 (#21)
Kammer 2,2 (#22)
Kammer 1,2 (#23)
Kammer 0,2 (#24)
Kammer 0,1 (#25)
Kammer 0,0 (#26)
Kammer 1,0 (#27)
Kammer 1,1 (#28)
Kammer 2,1 (#29)
Kammer 2,0 (#30)
Kammer 3,0 (#31)
Kammer 3,1 (#32)
Kammer 4,1 (#33)
Kammer 4,0 (#34)
Kammer 5,0 (#35)
Kammer 5,1 (#36)
Minutenpunkt
Kantenbrücken zur Nachbarplatine (0R 2512, von Hand)
Montagelöcher M3, Passermarken

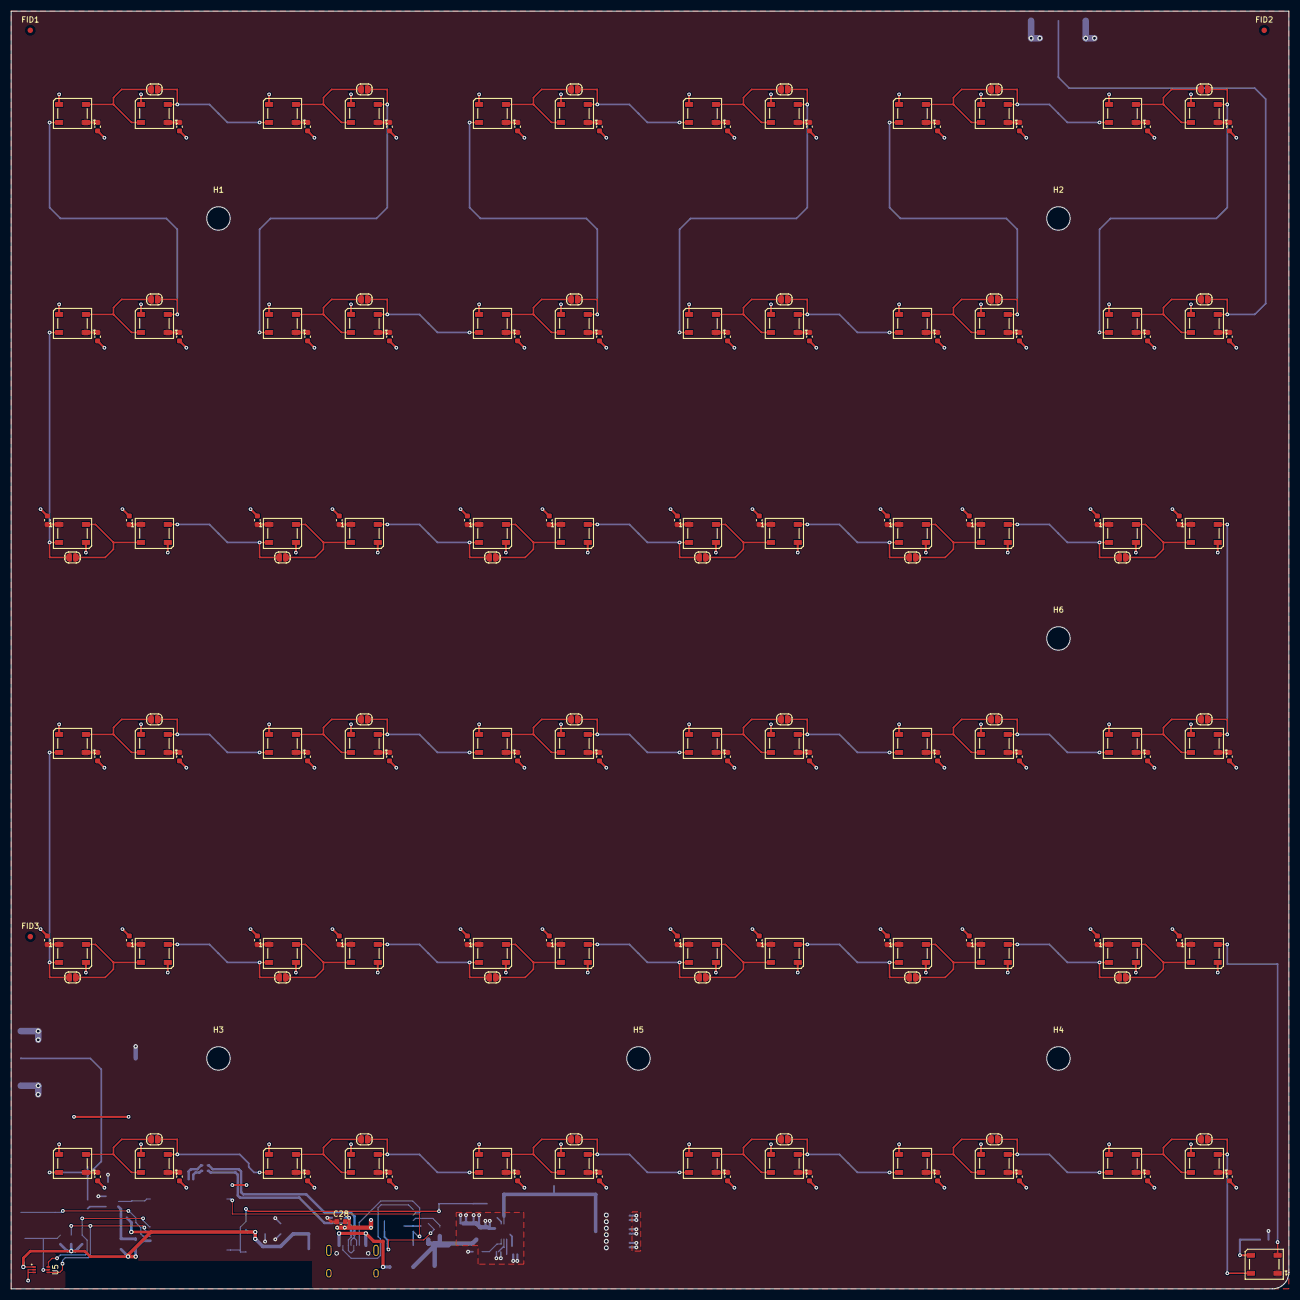
[picture p61: board WortUhr.kicad_pcb from above]

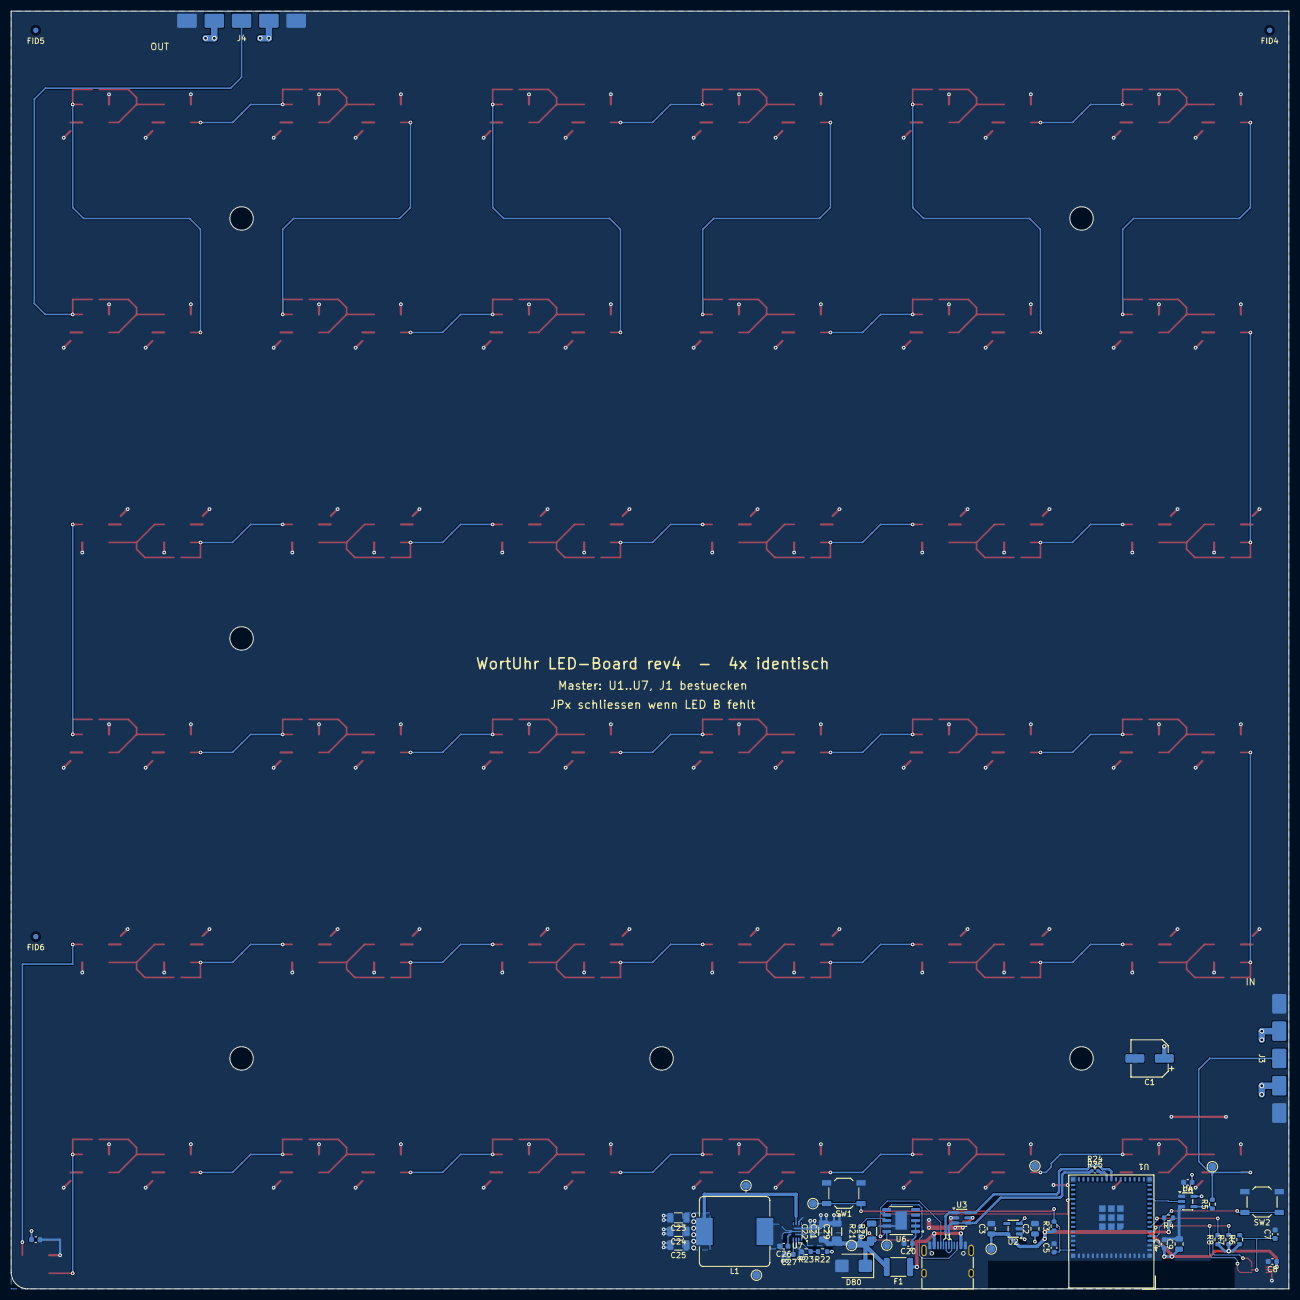
[picture p62: board WortUhr.kicad_pcb from below]

Board: 2 copper layers, 234.0 x 234.0 mm, 248 parts (56 on the bottom side), 99 nets.
