rtreichl/Wordclock/02_Electronics/KiCad/tools/gen_pcb.py

# -*- coding: utf-8 -*-
"""Erzeugt WortUhr.kicad_pcb aus design.py (mit KiCad-Python ausfuehren).

- Platzierung aller Bauteile (LED-Feld oben, Master-Teile unten)
- Routing des kompletten LED-Feldes (Datenkette, GND-Vias, Bruecken)
- +5V-Flaeche oben, GND-Flaeche unten (die Antennen-Sperrflaeche bringt der Footprint von U1 mit)
Die Master-Elektronik ist platziert, aber nicht geroutet: danach route_buck_usb.py und route_master.py (siehe build_pcb.py).
"""
import os, sys, math
sys.path.insert(0, os.path.dirname(__file__))
import pcbnew
import design as D
import kicad_env

PRJ = os.path.dirname(os.path.dirname(os.path.abspath(__file__)))
KIFP = kicad_env.footprint_dir()
O = 40.0                      # KiCad-Koordinate des Uhrmittelpunkts (x und y)
W_SIG, W_GND = 0.3, 0.4
VIA_D, VIA_DRILL = 0.7, 0.3          # Restring 0.2 mm (JLCPCB 2 Lagen: min. 0.18 mm)

mm = pcbnew.FromMM


def V(x, y):
    return pcbnew.VECTOR2I(mm(O + x), mm(O + y))


board = pcbnew.BOARD()
board.SetCopperLayerCount(2)
ds = board.GetDesignSettings()
ds.SetBoardThickness(mm(1.6))
ds.m_TrackMinWidth = mm(0.1)          # JLCPCB 2 Lagen: min. 0.1 mm
ds.m_CopperEdgeClearance = mm(0.3)    # Projektregel; die Grenze des Fertigers prueft qualify_pcb.py
nets = {}


def net(name):
    return rawnet(FULLNET.get(name, name))


def load_fp(fpid):
    lib, name = fpid.split(":")
    path = os.path.join(PRJ, lib + ".pretty") if lib == "WortUhr" else KIFP + lib + ".pretty"
    fp = pcbnew.FootprintLoad(path, name)
    assert fp, fpid
    fp.SetFPID(pcbnew.LIB_ID(lib, name))
    return fp


placed = {}


def place(part, x, y, rot, side="F"):
    fp = load_fp(part.fp)
    fp.SetReference(part.ref)
    fp.SetValue(part.value)
    fp.SetPath(pcbnew.KIID_PATH("/" + D.sheet_uuid(D.sheet_of(part.ref)) + "/" + part.uuid))
    for k, v in dict(part.extra, Variante=part.variant).items():
        f = pcbnew.PCB_FIELD(fp, pcbnew.FIELD_T_USER, k)
        f.SetText(v); f.SetVisible(False); f.SetLayer(pcbnew.F_Fab)
        fp.Add(f)
    board.Add(fp)
    fp.SetPosition(V(x, y))
    if side == "B":
        fp.Flip(V(x, y), pcbnew.FLIP_DIRECTION_LEFT_RIGHT)
    fp.SetOrientationDegrees(rot)
    for p in fp.Pads():
        n = PADNET.get((part.ref, p.GetNumber()))
        if n:
            p.SetNet(rawnet(n))
        elif p.GetNumber() not in ("", "MP"):
            pass  # z.B. USB-C SBU-Pads ohne Symbolpin
    for f in (fp.Reference(), fp.Value()):   # Bestueckungsdruck: JLCPCB min. 1,0 mm Hoehe / 0,15 mm Strich
        if f.GetLayer() in (pcbnew.F_SilkS, pcbnew.B_SilkS):
            h = max(pcbnew.ToMM(f.GetTextHeight()), 1.0)
            f.SetTextSize(pcbnew.VECTOR2I(mm(h), mm(h))); f.SetTextThickness(mm(max(0.15, h * 0.15)))
    if part.ref in D.MASTER_PLACE:       # Master-Teile voll an die Flaechen (keine Waermefallen)
        for p in fp.Pads():
            p.SetLocalZoneConnection(pcbnew.ZONE_CONNECTION_FULL)
    placed[part.ref] = fp
    return fp


def pad_xy(ref, num):
    for p in placed[ref].Pads():
        if p.GetNumber() == num:
            q = p.GetPosition()
            return (pcbnew.ToMM(q.x) - O, pcbnew.ToMM(q.y) - O)
    raise KeyError(ref + "." + num)


def track(pts, netname, layer=pcbnew.F_Cu, w=W_SIG):
    for (x1, y1), (x2, y2) in zip(pts, pts[1:]):
        if abs(x1 - x2) < 1e-6 and abs(y1 - y2) < 1e-6:
            continue
        t = pcbnew.PCB_TRACK(board)
        t.SetStart(V(x1, y1)); t.SetEnd(V(x2, y2))
        t.SetWidth(mm(w)); t.SetLayer(layer); t.SetNet(net(netname))
        board.Add(t)


def chamfer(pts, r=2.0):
    """Rechte Winkel durch 45-Grad-Stuecke ersetzen."""
    out = [pts[0]]
    for i in range(1, len(pts) - 1):
        a, b, c = pts[i - 1], pts[i], pts[i + 1]
        la = abs(b[0] - a[0]) + abs(b[1] - a[1]); lc = abs(c[0] - b[0]) + abs(c[1] - b[1])
        q_ = min(r, la / 2, lc / 2)
        if q_ < 0.05 or not ((a[0] == b[0]) != (b[0] == c[0])):
            out.append(b); continue
        ua = ((b[0] - a[0]) / la, (b[1] - a[1]) / la); uc = ((c[0] - b[0]) / lc, (c[1] - b[1]) / lc)
        out += [(b[0] - ua[0] * q_, b[1] - ua[1] * q_), (b[0] + uc[0] * q_, b[1] + uc[1] * q_)]
    out.append(pts[-1])
    return out


def via(x, y, netname, d=VIA_D, drill=VIA_DRILL):
    v = pcbnew.PCB_VIA(board)
    v.SetPosition(V(x, y)); v.SetWidth(mm(d)); v.SetDrill(mm(drill))
    v.SetViaType(pcbnew.VIATYPE_THROUGH); v.SetNet(net(netname))
    board.Add(v)


def line(layer, a, b, w=0.1):
    s = pcbnew.PCB_SHAPE(board)
    s.SetShape(pcbnew.SHAPE_T_SEGMENT); s.SetStart(V(*a)); s.SetEnd(V(*b))
    s.SetLayer(layer); s.SetWidth(mm(w)); board.Add(s)


def text(layer, s, x, y, size=1.5, rot=0, mirror=False):
    t = pcbnew.PCB_TEXT(board)
    t.SetText(s); t.SetPosition(V(x, y)); t.SetLayer(layer)
    t.SetTextSize(pcbnew.VECTOR2I(mm(size), mm(size))); t.SetTextThickness(mm(size * 0.15))
    t.SetTextAngleDegrees(rot); t.SetMirrored(mirror)
    board.Add(t)


parts = {p.ref: p for p in D.build_parts()}

# Pad-Netze direkt aus der Schaltplan-Netzliste (garantiert Paritaet)
import subprocess, re, tempfile
_nl = os.path.join(tempfile.gettempdir(), "wortuhr_net.net")
subprocess.run([kicad_env.cli(), "sch", "export", "netlist", "-o", _nl,
                os.path.join(PRJ, "WortUhr.kicad_sch")], check=True, capture_output=True)
_t = open(_nl, encoding="utf-8").read()
PADNET = {}
for _blk in re.split(r"\(net\s+\(code ", _t[_t.find("(nets"):])[1:]:
    _name = re.search(r'\(name "([^"]*)"\)', _blk).group(1)
    for _r, _p in re.findall(r'\(ref "([^"]*)"\)\s*\(pin "([^"]*)"', _blk):
        PADNET[(_r, _p)] = _name


FULLNET = {v.rsplit("/", 1)[-1]: v for v in PADNET.values()}


def rawnet(name):
    if name not in nets:
        ni = pcbnew.NETINFO_ITEM(board, name, len(nets) + 1)
        board.Add(ni)
        nets[name] = ni
    return nets[name]

# ---------------------------------------------------------------- Umriss
R = D.CORNER_R
a, b = D.BOARD_MIN, D.BOARD_MAX
line(pcbnew.Edge_Cuts, (a, a), (b, a)); line(pcbnew.Edge_Cuts, (b, a), (b, b - R))
line(pcbnew.Edge_Cuts, (b - R, b), (a, b)); line(pcbnew.Edge_Cuts, (a, b), (a, a))
arc = pcbnew.PCB_SHAPE(board); arc.SetShape(pcbnew.SHAPE_T_ARC)
arc.SetCenter(V(b - R, b - R)); arc.SetStart(V(b, b - R)); arc.SetArcAngleAndEnd(pcbnew.EDA_ANGLE(90, pcbnew.DEGREES_T))
arc.SetLayer(pcbnew.Edge_Cuts); arc.SetWidth(mm(0.1)); board.Add(arc)

# ---------------------------------------------------------------- LED-Feld
# Kammer-lokale Geometrie fuer Laufrichtung links->rechts (dir=+1);
# dir=-1 = Punktspiegelung an der Kammermitte (alles um 180° gedreht).
via_in, via_out = {}, {}
for c, ((k, j), d) in enumerate(D.PATH):
    cx, cy = D.cell_center(k, j)
    T = lambda x, y: (cx + d * x, cy + d * y)
    rot = 180 if d > 0 else 0          # LEDs
    rp = 0 if d > 0 else 180           # Kondensatoren / Bruecken
    nA, nB = 2 * c + 1, 2 * c + 2
    pA, pB = parts[f"D{nA}"], parts[f"D{nB}"]
    a_out, b_out = pA.pins["2"], pB.pins["2"]
    a_in = pA.pins["4"]
    place(pA, *T(-D.LED_OFF, 0), rot)
    place(pB, *T(+D.LED_OFF, 0), rot)
    # Abblock-C am +5V-Pin (Punkt 1): +5V-Pad zum Pin, eigenes GND-Via direkt am GND-Pad
    rc = 90 if d > 0 else 270
    place(parts[f"C{100+nA}"], *T(-2.9, 2.425), rc)
    place(parts[f"C{100+nB}"], *T(12.1, 2.425), rc)
    place(parts[f"JP{c+1}"], *T(7.5, -4.4), rp)
    for r in (f"D{nA}", f"D{nB}", f"C{100+nA}", f"C{100+nB}", f"JP{c+1}"):
        placed[r].Reference().SetVisible(False)
    # Daten innerhalb der Kammer: A.DOUT -> B.DIN
    track([T(-5.05, -1.65), T(0.0, -1.65), T(3.3, 1.65), T(5.05, 1.65)], a_out)
    # Ein-/Ausgangs-Vias
    track([T(-9.95, 1.65), T(-11.7, 1.65)], a_in); via(*T(-11.7, 1.65), a_in); via_in[c] = T(-11.7, 1.65)
    track([T(9.95, -1.65), T(11.7, -1.65)], b_out); via(*T(11.7, -1.65), b_out); via_out[c] = T(11.7, -1.65)
    # GND
    track([T(-9.95, -1.65), T(-9.95, -3.5)], "GND", w=W_GND); via(*T(-9.95, -3.5), "GND")
    track([T(5.05, -1.65), T(5.05, -3.5)], "GND", w=W_GND); via(*T(5.05, -3.5), "GND")
    for cref, vdd in ((f"C{100+nA}", T(-5.05, 1.65)), (f"C{100+nB}", T(9.95, 1.65))):
        gx, gy = pad_xy(cref, "1"); px_, py_ = pad_xy(cref, "2")
        track([vdd, (px_, py_)], "+5V", w=W_GND)
        vg = (gx + d * 1.25, gy + d * 1.25)
        track([(gx, gy), vg], "GND", w=W_GND); via(*vg, "GND")
    # Bruecke JP: Pad1 -> B.DIN, Pad2 -> B.DOUT
    track([T(6.85, -4.4), T(1.5, -4.4), T(0.0, -2.9), T(0.0, -1.65)], a_out)
    track([T(8.15, -4.4), T(11.7, -4.4), T(11.7, -1.65)], b_out)

# Minuten-LED in der Aussenecke, zwischen Kammer MINUTE_AFTER und der naechsten
mx, my = D.MINUTE_LED_POS
place(parts["D75"], mx, my, 180)                    # Pads wie LED A bei Laufrichtung +1
place(parts["C175"], mx, my - 4.5, 0, "B")
placed["D75"].Reference().SetVisible(False); placed["C175"].Reference().SetVisible(False)
m_in, m_out = parts["D75"].pins["4"], parts["D75"].pins["2"]
xi, yi = pad_xy("D75", "4"); xo, yo = pad_xy("D75", "2"); xg, yg = pad_xy("D75", "3")
p1 = via_out[D.MINUTE_AFTER]
track([p1, (p1[0], yi)], m_in, pcbnew.B_Cu); via(p1[0], yi, m_in); track([(p1[0], yi), (xi, yi)], m_in)
track([(xo, yo), (xo, yo - 2.4)], m_out); via(xo, yo - 2.4, m_out)
p2 = via_in[D.MINUTE_AFTER + 1]
track([(xo, yo - 2.4), (xo, p2[1] + 3.6), (p2[0], p2[1] + 3.6), p2], m_out, pcbnew.B_Cu)
track([(xg, yg), (xg - 2.0, yg)], "GND", w=W_GND); via(xg - 2.0, yg, "GND")
# Abblock-C auf der Unterseite: GND an die GND-Via der LED, +5V per Via an die +5V-Flaeche oben
for pn in ("1", "2"):
    x, y = pad_xy("C175", pn); n = parts["C175"].pins[pn]
    if n == "GND":
        track([(x, y), (xg - 2.0, y), (xg - 2.0, yg)], n, pcbnew.B_Cu, w=W_GND)
    else:
        track([(x, y), (x, y - 1.6)], n, pcbnew.B_Cu, w=W_GND); via(x, y - 1.6, n)

# Spruenge zwischen den Kammern (Unterseite)
for c in range(35):
    if c == D.MINUTE_AFTER:
        continue                                     # laeuft ueber die Minuten-LED
    (k1, j1), _ = D.PATH[c]; (k2, j2), _ = D.PATH[c + 1]
    p1, p2 = via_out[c], via_in[c + 1]
    n = parts[f"D{2*c+2}"].pins["2"]
    c1, c2 = D.cell_center(k1, j1), D.cell_center(k2, j2)
    if j1 == j2:
        xm = 44.0 if c == 0 else (c1[0] + c2[0]) / 2      # c == 0: Platz fuer das USB-Paar an U1
        pts = [p1, (xm, p1[1]), (xm, p2[1]), p2]
    elif abs(p1[0] - p2[0]) < 1e-6:
        pts = [p1, p2]
    else:
        ym = (c1[1] + c2[1]) / 2
        pts = [p1, (p1[0], ym), (p2[0], ym), p2]
    track(chamfer(pts), n, pcbnew.B_Cu)

# ---------------------------------------------------------------- Kantenbruecken J_IN / J_OUT
# 5 Pads je Kante (GND, +5V, Daten, +5V, GND) fuer 0R-2512 ueber den 1-mm-Spalt zur Nachbarplatine.
EDGE_PAD = D.BOARD_MIN + 0.45 + 1.3          # Padmitte 2.25 mm von der Schnittkante


def place_bridge(ref, x, y, rot, axis):
    for r in (rot, rot + 180):
        if ref in placed:
            board.Remove(placed.pop(ref))
        place(parts[ref], x, y, r, "B")
        xs = [pad_xy(ref, str(i))[axis] for i in range(1, 6)]
        if all(abs(v - EDGE_PAD) < 0.01 for v in xs):
            return
    raise RuntimeError("Bruecke %s falsch orientiert" % ref)


place_bridge("J3", EDGE_PAD, D.CONN_POS, 270, 0)   # linke Kante
place_bridge("J4", D.CONN_POS, EDGE_PAD, 180, 1)   # obere Kante
for ref in ("J3", "J4"):
    for p in placed[ref].Pads():
        p.SetLocalZoneConnection(pcbnew.ZONE_CONNECTION_FULL)
    for pn in ("2", "4"):
        x, y = pad_xy(ref, pn)
        vx_, vy_ = (x + 3.2, y) if ref == "J3" else (x, y + 3.2)
        track([(x, y), (vx_, vy_)], "+5V", pcbnew.B_Cu, w=1.2); via(vx_, vy_, "+5V", 0.9, 0.5)
        vx2, vy2 = (vx_, vy_ + 1.6) if ref == "J3" else (vx_ + 1.6, vy_)
        track([(vx_, vy_), (vx2, vy2)], "+5V", pcbnew.B_Cu, w=1.2); via(vx2, vy2, "+5V", 0.9, 0.5)

# J_IN: Daten -> erster LED-Eingang (Via)
x3, y3 = pad_xy("J3", "3")
vx, vy = via_in[0]
track(chamfer([(x3, y3), (17.0, y3), (17.0, vy), (vx, vy)]), "DIN", pcbnew.B_Cu)
# J_OUT: letzte Kammer -> Daten (rechts am Feld vorbei, dann oberhalb der Kammer (5,0))
x3, y3 = pad_xy("J4", "3")
vx, vy = via_out[35]
xr = D.cell_center(5, 0)[0] + D.C0 - 0.5
track(chamfer([(vx, vy), (xr, vy), (xr, 14.6), (x3, 14.6), (x3, y3)]), "DOUT", pcbnew.B_Cu)

# Puffer-Elko (jede Platine) unter der Wand nahe J_IN
place(parts["C1"], 26.0, D.CONN_POS, 0, "B")
x, y = pad_xy("C1", "1"); via(x, y - 2.2, "+5V", 0.8, 0.4); track([(x, y), (x, y - 2.2)], "+5V", pcbnew.B_Cu, w=0.8)

# Passermarken (Fiducials) fuer die Bestueckung
for i, (x, y, side) in enumerate(D.FIDUCIALS):
    place(parts[f"FID{i+1}"], x, y, 0, side)

# Montageloecher
for i, (x, y) in enumerate(D.MOUNT_HOLES):
    place(parts[f"H{i+1}"], x, y, 0)

# ---------------------------------------------------------------- Master
for ref, (x, y, rot, side) in D.MASTER_PLACE.items():
    place(parts[ref], x, y, rot, side)
# R5 (Pegelwandler-Ausgang) direkt an die DIN-Leitung
x5, y5 = pad_xy("R5", "2")
track([(x5, y5), (x5, via_in[0][1])], "DIN", pcbnew.B_Cu)
for ref in ("J1",):
    fp = placed[ref]; bb = fp.GetBoundingBox(False)
    print(ref, "bbox y", round(pcbnew.ToMM(bb.GetTop()) - O, 2), round(pcbnew.ToMM(bb.GetBottom()) - O, 2))

assert len(placed) == len(parts), set(parts) - set(placed)
# ROUTING_GUIDE.md: kritische Teile sperren (Steckverbinder, Kantenbruecken, Funkmodul, Montageloecher, Passermarken)
LOCK = {"J1", "J3", "J4", "U1"} | {r for r in placed if r.startswith(("H", "FID"))}
for r in LOCK:
    placed[r].SetLocked(True)

# ---------------------------------------------------------------- 3D-Modelle
# Fehlende Herstellermodelle -> massgenaue Platzhalter aus ${KIPRJMOD}/3dmodels
def set_model(ref, fname, off=(0, 0, 0), rot=(0, 0, 0), keep=False):
    fp = placed[ref]
    if not keep:
        fp.Models().clear()
    m = pcbnew.FP_3DMODEL()
    m.m_Filename = fname
    m.m_Offset = pcbnew.VECTOR3D(*off); m.m_Rotation = pcbnew.VECTOR3D(*rot)
    fp.Models().push_back(m)


set_model("U1", "${KIPRJMOD}/3dmodels/ESP32-S3-MINI-1_Platzhalter.step")
set_model("J1", "${KIPRJMOD}/3dmodels/USB_C_HRO_TYPE-C-31-M-12_Platzhalter.step")
set_model("U5", "${KIPRJMOD}/3dmodels/BH1750_WSOF6I_Platzhalter.step")
# 0R-2512-Bruecken (Darstellung nur an J_OUT, Mitte ueber dem Spalt)
for i, xo in enumerate((-10, -5, 0, 5, 10)):
    set_model("J4", "${KICAD10_3DMODEL_DIR}/Resistor_SMD.3dshapes/R_2512_6332Metric.step",
              (xo, 2.25, 0), (0, 0, 90), keep=i > 0)

# ---------------------------------------------------------------- Flaechen
def zone(layer, netname, poly, prio=0, clearance=0.3):
    z = pcbnew.ZONE(board)
    z.SetLayer(layer); z.SetNet(net(netname)); z.SetAssignedPriority(prio)
    ol = z.Outline(); ol.NewOutline()
    for x, y in poly:
        ol.Append(mm(O + x), mm(O + y))
    z.SetLocalClearance(mm(clearance)); z.SetMinThickness(mm(0.25))
    z.SetThermalReliefGap(mm(0.3)); z.SetThermalReliefSpokeWidth(mm(0.5))
    z.SetPadConnection(pcbnew.ZONE_CONNECTION_THERMAL)
    z.SetIslandRemovalMode(pcbnew.ISLAND_REMOVAL_MODE_ALWAYS)
    board.Add(z)
    return z


full = [(a, a), (b, a), (b, b), (a, b)]
zone(pcbnew.F_Cu, "+5V", full)
zone(pcbnew.B_Cu, "GND", full)


# ---------------------------------------------------------------- Beschriftung
text(pcbnew.B_SilkS, "WortUhr LED-Board rev%s  -  4x identisch" % D.REV, 117.0, 120.0, 2.0, mirror=True)
text(pcbnew.B_SilkS, "Master: U1..U7, J1 bestuecken", 117.0, 124.0, 1.5, mirror=True)
text(pcbnew.B_SilkS, "JPx schliessen wenn LED B fehlt", 117.0, 127.5, 1.5, mirror=True)
text(pcbnew.B_SilkS, "IN", 7.5, D.CONN_POS - 14.0, 1.2, mirror=True)
text(pcbnew.B_SilkS, "OUT", D.CONN_POS + 15.0, 7.0, 1.2, mirror=True)

pcbnew.ZONE_FILLER(board).Fill(board.Zones())
out = os.path.join(PRJ, "WortUhr.kicad_pcb")
pcbnew.SaveBoard(out, board)
print("saved", out, "footprints", len(placed), "tracks", len(board.GetTracks()))

# Entwurfsregeln auch in der Projektdatei setzen (KiCad liest die Regeln aus der .kicad_pro)
import json
_pro = os.path.join(PRJ, "WortUhr.kicad_pro")
_d = json.load(open(_pro, encoding="utf-8"))
_r = _d["board"]["design_settings"]["rules"]
_ns = _d.setdefault("net_settings", {})
_cl = _ns["classes"][0]
def _nc(name, w, clr=0.2, vd=0.7, vh=0.3):
    return dict(_cl, name=name, track_width=w, clearance=clr, via_diameter=vd, via_drill=vh, priority=len(_ns["classes"]))
_ns["classes"] = [dict(_cl, track_width=0.2, clearance=0.2, via_diameter=0.7, via_drill=0.3)] + [
    _nc("PWR_15V", 0.8, vd=0.8, vh=0.4), _nc("PWR_VBUS", 0.6, vd=0.8, vh=0.4), _nc("PWR_3V3", 0.5, vd=0.8, vh=0.4),
    _nc("PWR_5V", 0.6, vd=0.8, vh=0.4), _nc("GND", 0.4), _nc("USB", 0.2, clr=0.15), _nc("LED_DATA", 0.3)]
_ns["netclass_patterns"] = [{"netclass": c, "pattern": p_} for c, p_ in (("PWR_15V", "+15V"), ("PWR_VBUS", "VBUS"), ("PWR_3V3", "+3V3"), ("PWR_5V", "+5V"), ("GND", "GND"),
                            ("USB", "USB_D*"), ("USB", "*/USB_D*"), ("LED_DATA", "*/K??_*_OUT"), ("LED_DATA", "DIN"), ("LED_DATA", "*/DOUT"), ("LED_DATA", "*/MIN_OUT"), ("LED_DATA", "*/LED_5V"))]
_r["min_copper_edge_clearance"] = 0.3
_r["min_track_width"] = 0.1
json.dump(_d, open(_pro, "w", encoding="utf-8"), indent=2)
