rtreichl/Wordclock/(commit log)

2026-11-07 Initial commit: WortUhr KiCad project, FreeCAD front plate and design files
    [FrontPlatte-Körper.step, FrontPlatte.FCStd, Frontplatte-500mm-Sencilla.dxf, Unbenannt-Slice001.1.3mf, Unbenannt-Slice001.1.step, Unbenannt-Slice001.2.step, Unbenannt-Slice001.3.step, Unbenannt-Slice001.4.step]
2026-11-07 Add .gitignore and untrack local/generated files
    Removes KiCad lock, autosave, cache, backup and local settings files,
    FreeCAD backup copies and local .claude settings from version control.
    The files remain on disk.
2026-11-07 Add 1 mm front plate and 4-part light grid with integrated dovetails
    - Front plate (1 mm) built from Frontplatte-500mm-Sencilla.dxf
    - Light grid rebuilt: 144 equal 30x30 mm cells centred on the letters
    - Grid split into 4 printable quarters (max 244 mm) with integrated
    sliding dovetail joints (0.19 mm clearance, 0.4 mm lead-in)
    - Exports: STEP, print-ready 3MF and target LED positions CSV
    [FrontPlatte-Bestellung.FCStd, Frontplatte_1mm.step, Gitter_Q1_obenlinks.step, Gitter_Q1_obenlinks_druckfertig.3mf, Gitter_Q2_obenrechts.step, Gitter_Q2_obenrechts_druckfertig.3mf, Gitter_Q3_untenlinks.step, Gitter_Q3_untenlinks_druckfertig.3mf]
2026-11-07 Add diffuser pockets to light grid and export diffuser parts
    - 144 pockets 35.4 x 35.4 x 2.1 mm with 1.5 mm corner reliefs for
    square 35 x 35 x 2 mm diffusers, flush below the front plate
    - Re-exported grid quarters (STEP and print-ready 3MF)
    - Diffuser DXF and STEP for ordering
    [Diffusor_35x35.dxf, Diffusor_35x35x2.step, FrontPlatte-Bestellung.FCStd, Gitter_Q1_obenlinks.step, Gitter_Q1_obenlinks_druckfertig.3mf, Gitter_Q2_obenrechts.step, Gitter_Q2_obenrechts_druckfertig.3mf, Gitter_Q3_untenlinks.step]
2026-11-07 Switch to 30 mm diffusers and add 48 magnet holes for steel front plate
    - Cells keep 30x30 mm opening, corner radius 5 mm acts as diffuser seat
    - Diffuser pockets 30.4 x 30.4 x 2.1 mm for 30 x 30 x 2 mm diffusers
    - 48 magnet holes D3.2 x 6.1 mm (32 in frame, 16 at inner crossings),
    12 per quarter, for 3x6 mm NdFeB magnets holding the Corten plate
    - Re-exported grid quarters, diffuser DXF/STEP, magnet positions CSV
    [Diffusor_30x30.dxf, Diffusor_30x30x2.step, FrontPlatte-Bestellung.FCStd, Gitter_Q1_obenlinks.step, Gitter_Q1_obenlinks_druckfertig.3mf, Gitter_Q2_obenrechts.step, Gitter_Q2_obenrechts_druckfertig.3mf, Gitter_Q3_untenlinks.step]
2026-11-07 Redesign LED PCB as one board used 4x, with master variant and light sensor
    - Schematic and PCB generated by scripts (WortUhr/tools): 6x6 cells per
    board, 2 SK6812 RGBW positions per cell with solder bridge for 1-LED
    population, +5V/GND pours, LED field fully routed
    - Same board rotated 0/90/180/270 deg under the four grid parts, chained
    via JST-XH J_IN/J_OUT facing each other at the seams
    - Master variant: ESP32-S3-MINI-1, USB-C + 5V barrel jack (Schottky OR),
    AP2112K-3.3 (replaces wrong 1.2V R-78B), 74AHCT1G125 level shifter,
    BH1750 under Mentor 1282.1000 light pipe; routed with Freerouting
    - ERC 0, DRC 0 errors, 0 unconnected, schematic parity 0
    - Grid: M2 screw holes, light pip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
    [FrontPlatte-Bestellung.FCStd, Frontplatte_1mm.step, Frontplatte_1mm_mit_Lichtleiter.dxf, Gitter_Q1_obenlinks.step, Gitter_Q1_obenlinks_druckfertig.3mf, Gitter_Q2_obenrechts.step, Gitter_Q2_obenrechts_druckfertig.3mf, Gitter_Q3_untenlinks.step]
2026-11-07 Replace JST board connectors with 0R 2512 edge bridges
    J_IN/J_OUT are now 5 edge pads (GND, +5V, data, +5V, GND) per seam.
    A 0 ohm 2512 resistor is soldered across the ~1 mm gap to the neighbour
    board, keeping the back flat (0.6 mm instead of 9 mm JST headers).
    Adds the EdgeBridge_5x2512 project footprint; bridges are excluded
    from the BOM.
    [design.py, gen_pcb.py, gen_sch.py]
2026-11-07 Switch PCB mounting to M3 and add holes H5/H6
    Mounting holes are now 3.2 mm for M3 screws. Two extra holes at free
    web crossings give every rear-frame bar at least two screws.
2026-11-07 Add placeholder 3D models for parts without KiCad models
    Dimension-accurate placeholders for ESP32-S3-MINI-1, HRO TYPE-C-31-M-12,
    CUI PJ-036AH-SMT (11.4 mm high) and BH1750, assigned by gen_pcb.py.
    The 0R bridges are shown on J_OUT using the stock R_2512 model.
    [BH1750_WSOF6I_Platzhalter.step, BarrelJack_CUI_PJ-036AH-SMT_Platzhalter.step, ESP32-S3-MINI-1_Platzhalter.step, USB_C_HRO_TYPE-C-31-M-12_Platzhalter.step]
2026-11-07 Make master autorouting robust
    - Block new top-layer tracks over the LED field so Freerouting cannot
    split the +5V pour into islands
    - Remove copied vias that are connected on one layer only
    - Pre-route R5 to the DIN line; copper-to-edge clearance 0.3 mm (JLCPCB)
    [gen_pcb.py, route_master.py]
2026-11-07 Regenerate schematic and PCB
    Output of gen_sch.py, gen_pcb.py and route_master.py with edge bridges,
    M3 holes H1-H6 and 3D models. ERC 0, DRC 0 errors, 0 unconnected,
    schematic parity 0 (11 silkscreen notes remain).
    [WortUhr.kicad_pcb, WortUhr.kicad_sch]
2026-11-07 Export PCB 3D models (master and slave variant)
    STEP exports of the LED board with all components, used for the
    FreeCAD assembly and collision checks.
    [LED-Board_master.step, LED-Board_slave.step]
2026-11-07 Integrate PCBs in FreeCAD, add M3 pilot holes and rear frame bars
    - Four PCBs placed in the assembly (0/90/180/270 deg), no collisions
    - Grid parts: M3 pilot holes 2.6 mm x 9 mm at all six board holes
    - Wall-mountable rear frame, 10 mm thick, as 8 straight bars with
    countersunk M3x20 bosses, keyholes in the top bars and cut-outs for
    C1, USB-C and barrel jack
    - Two print plates that fit a 254 x 254 mm bed
    [FrontPlatte-Bestellung.FCStd, Gitter_Q1_obenlinks.step, Gitter_Q1_obenlinks_druckfertig.3mf, Gitter_Q2_obenrechts.step, Gitter_Q2_obenrechts_druckfertig.3mf, Gitter_Q3_untenlinks.step, Gitter_Q3_untenlinks_druckfertig.3mf, Gitter_Q4_untenrechts.step]
2026-11-07 Update assembly notes for bridges, M3, rear frame and stack height
    Documents the 19 edge bridges (no data bridge Q3->Q4), screw lengths,
    rear frame print plates and the 36 mm total depth.
2026-11-07 Add photorealistic Blender render of the clock
    - Render/render_wortuhr.py: Cycles scene built from FreeCAD meshes
    (Corten front plate with patina, opal diffusers, lit words, wall
    mounting with 35 mm stand-off), options for samples, resolution, view
    - Render/meshes: STL exports of front plate, diffusers (lit/unlit),
    grid parts, PCBs, rear frame and light pipe
    - Render/WortUhr_Szene.blend and two 2000x2000 renders (angle, front)
    showing "IST ZWANZIG VOR ZWOELF"
    [WortUhr_Szene.blend, diffusor_an.stl, diffusor_aus.stl, frontplatte.stl, gitter_Q1_obenlinks.stl, gitter_Q2_obenrechts.stl, gitter_Q3_untenlinks.stl, gitter_Q4_untenrechts.stl]
2026-11-07 Restructure repository into numbered top-level folders
    - 00_Design: graphics and letter layout (Affinity, SVG, DXF)
    - 01_Mechanic: FreeCAD main model and fabrication files
    (Frontplatte, Gitter, Rueckrahmen, Diffusor)
    - 02_Electronics: KiCad project with generators, PCB 3D exports,
    assembly notes
    - 03_Software: WLED ledmaps
    - 04_Rendering: Blender render
    - 99_Archive: older models and intermediate files
    Adds a top-level README and updates paths in gen_ledmap.py and
    BESTUECKUNG.md. All files moved with history preserved.
    [BH1750_WSOF6I_Platzhalter.step, BarrelJack_CUI_PJ-036AH-SMT_Platzhalter.step, Diffusor_30x30.dxf, Diffusor_30x30x2.step, ESP32-S3-MINI-1_Platzhalter.step, FrontPlatte-Bestellung.FCStd, FrontPlatte-Körper.step, FrontPlatte.FCStd]
2026-11-07 Store DRC rules in the KiCad project file
    KiCad reads design rules from WortUhr.kicad_pro, which still had a
    0.5 mm copper-to-edge clearance. Set 0.3 mm edge clearance and 0.1 mm
    minimum track width (JLCPCB) there, and let gen_pcb.py write them on
    every run. DRC: 0 errors, 0 unconnected, schematic parity 0.
    [gen_pcb.py]
2026-11-07 Add ESPHome firmware for the ESP32-S3 master board
    - NTP time (de.pool.ntp.org, cloudflare) independent of Home Assistant,
    api reboot_timeout 0s, web server + fallback hotspot for local control
    - Word clock logic in wortuhr.h (5-minute steps, greetings, WLAN hint,
    fading), automatic brightness from the BH1750 computed on the device
    - wortuhr_layout.h generated from the letter SVG and PCB chain order
    - Compiles with ESPHome 2026.10.2 (RAM 32 %, flash 24 %)
    - .gitignore: secrets.yaml, venv/build dirs, Blender backups, staging
    [wortuhr.h, wortuhr.yaml, wortuhr_layout.h]
2026-11-07 Qualify PCB against JLCPCB capabilities
    - Vias 0.7/0.3 mm (annular ring 0.2 mm, JLCPCB 2-layer minimum 0.18 mm),
    also for Freerouting and copied vias
    - Six fiducials (3 per side) for Standard PCBA double-sided assembly
    - Silkscreen text at least 1.0 mm high / 0.15 mm stroke
    - Master parts fully connected to the pours (no starved thermals)
    - route_master removes dangling stubs; build_pcb.py retries routing
    until DRC is clean (0 errors, 0 unconnected, parity 0)
    - Refreshed 3D exports
    [LED-Board_master.step, LED-Board_slave.step, WortUhr.kicad_pcb, WortUhr.kicad_sch]
2026-11-07 Fix thin walls in grid parts found by print qualification
    - Dovetail sockets came within 0.2 mm of the diffuser pockets at the top.
    Sockets now end at z = 20.4 mm, tenons at 20.0 mm (2.5 mm floor);
    parts are slid together from below
    - Q4: removed 1.0 / 0.17 mm slivers next to the USB-C and barrel-jack
    frame cut-outs
    - Thinnest wall now 2.38-2.50 mm (ray measurement); fix scripts in
    01_Mechanic/tools
    [FrontPlatte-Bestellung.FCStd, Gitter_Q1_obenlinks.step, Gitter_Q1_obenlinks_druckfertig.3mf, Gitter_Q2_obenrechts.step, Gitter_Q2_obenrechts_druckfertig.3mf, Gitter_Q3_untenlinks.step, Gitter_Q3_untenlinks_druckfertig.3mf, Gitter_Q4_untenrechts.step]
2026-11-07 Add qualified production data, reports and build workflow
    05_Production contains only data that passed all checks for its
    manufacturer, each with a QUALIFIKATION.md report and SHA256 sums:
    - PCB (JLCPCB): 28/28 - Gerber, drill, BOM/CPL master and slave,
    schematic PDF, STEP
    - Grid Q1-Q4: released for Bambu Lab P1S; JLC3DP blocked (dovetail
    clearance 0.19 mm < 0.5 mm, tolerance +-0.4 %)
    - Rear frame: released for P1S and JLC3DP
    - WLED ledmaps, firmware build check (binaries not stored, they contain
    secrets)
    Blocked with report: front plate (word NEUN not contiguous in the letter
    grid) and diffuser (laserteile-online.eu does not cut acrylic).
    Checks in 05_Production/tools against publish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
    [BOM_Master.csv, BOM_Slave.csv, Gitter_Q1_obenlinks.step, Gitter_Q1_obenlinks_druckfertig.3mf, Gitter_Q2_obenrechts.step, Gitter_Q2_obenrechts_druckfertig.3mf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]
2026-11-08 Fix CI: run KiCad container as root, move actions to Node 24
    The kicad/kicad image runs as user 'kicad', so actions/checkout could not
    write to /__w/_temp (EACCES). Bump checkout/setup-python/upload/download
    artifact to their Node 24 releases. Find the repo root by 05_Production
    instead of .git, since checkout without git in the container has no .git.
    [gen_ledmap.py, make_reports.py, qualify_firmware.py, qualify_pcb.py]
2026-11-08 Fix NEUN in letter grid: row 8 now reads ZEHNEUNEVIER
    Swap the E (col 7) and N (col 8) glyphs in row 8 of the design SVG/DXF
    and the 1 mm order DXF, so NEUN is contiguous. Rebuild the front plate
    solid (volume unchanged), STEP and render mesh with rebuild_frontplate.py.
    Drop tracked __pycache__ files.
    [FrontPlatte-Bestellung.FCStd, Frontplatte-500mm-Sencilla.dxf, Frontplatte_1mm.step, Frontplatte_1mm_mit_Lichtleiter.dxf, frontplatte.stl]
2026-11-08 Light NEUN as a contiguous word in the firmware
    Regenerate wortuhr_layout.h from the corrected grid, remove the NEUN
    special case from wortuhr.h and from the firmware/laser checks.
    [qualify_firmware.py, qualify_laser.py, wortuhr.h, wortuhr_layout.h]
2026-11-08 Release front plate for laserteile-online.eu (18/18 checks)
    Regenerated qualification reports after the NEUN fix; the R12 order DXF
    is now in 05_Production/01_Frontplatte_Laser.
    [Frontplatte_Corten_1mm_R12.dxf]
2026-11-08 Enlarge PCB mounting holes to 4.3 mm
    H1-H6 now use MountingHole_4.3mm_M4 (for M3 screws): +-0.65 mm play
    absorbs print tolerances of the grid parts (JLC3DP +-0.4 %, P1S) and
    assembly tolerances. Tracks unchanged, zones refilled; DRC 0 errors,
    0 unconnected, parity 0. H4 (screw head on the PCB) now gets a washer.
    [WortUhr.kicad_pcb, WortUhr.kicad_sch]
2026-11-08 Add JLC3DP variant of the grid parts, thicken Q4 wall
    make_jlc3dp_variant.py builds <part>_JLC3DP from the P1S parts: 0.5 mm
    seam, tenons redrawn parallel to the unchanged sockets with 0.5 mm
    clearance (flank, tip, top), 0.5 mm undercut per side. Measured gap
    between neighbours: 0.500 mm. Q4: wall between component recess and
    cell raised from 2.38 to 2.53 mm (both variants).
    [FrontPlatte-Bestellung.FCStd, Gitter_Q1_obenlinks_JLC3DP.step, Gitter_Q1_obenlinks_JLC3DP_druckfertig.3mf, Gitter_Q2_obenrechts_JLC3DP.step, Gitter_Q2_obenrechts_JLC3DP_druckfertig.3mf, Gitter_Q3_untenlinks_JLC3DP.step, Gitter_Q3_untenlinks_JLC3DP_druckfertig.3mf, Gitter_Q4_untenrechts.step]
2026-11-08 Update PCB STEP exports and hole check for 4.3 mm holes
    [LED-Board_master.step, LED-Board_slave.step]
2026-11-08 Qualify P1S and JLC3DP grid variants separately
    Each variant is rated only against its own manufacturer. JLC3DP checks
    are now quantitative: measured clearance, PCB hole pattern vs +-0.4 %,
    dovetail offset along the seam, seam under oversize.
    [make_reports.py, qualify_print.py]
2026-11-08 Release grid parts for JLC3DP, PCB re-qualified (28/28)
    [Gitter_Q1_obenlinks_JLC3DP.step, Gitter_Q1_obenlinks_JLC3DP_druckfertig.3mf, Gitter_Q2_obenrechts_JLC3DP.step, Gitter_Q2_obenrechts_JLC3DP_druckfertig.3mf, Gitter_Q3_untenlinks_JLC3DP.step, Gitter_Q3_untenlinks_JLC3DP_druckfertig.3mf, Gitter_Q4_untenrechts.step, Gitter_Q4_untenrechts_JLC3DP.step]
2026-11-08 FreeCAD model: PCB mounting holes 4.3 mm
    update_pcb_holes.py drills the six holes of each board solid in the
    assembly from 3.2 to 4.3 mm, matching the KiCad layout.
    [FrontPlatte-Bestellung.FCStd]
2026-11-08 Qualify diffuser for self-cut and Cutworks
    Replaces the laserteile-online.eu check (metals only). Self-cut: 29.9 mm
    stop, +-0.2 mm, 0.15 mm clearance per side. Cutworks: general CO2-laser
    acrylic rules (no public design rules), confirm XT material. 7/7.
    [make_reports.py, qualify_laser.py]
2026-11-08 CI: export render meshes and render with Blender 5.2.3
    The mechanics job exports the meshes from the FreeCAD model; a new
    rendering job downloads Blender 5.2.3 (Linux) and renders the angled
    and front views (Cycles CPU, 64 samples, 1200 px). Artifact:
    WortUhr-Renderings.
2026-11-08 Rendering: mesh export script, re-render with NEUN fix
    export_meshes.py writes the render meshes from the FreeCAD model (was a
    one-off before). Renders now show row 8 ZEHNEUNEVIER, the JLC/P1S Q4
    wall fix and 4.3 mm PCB holes.
    [WortUhr_Szene.blend, frontplatte.stl, gitter_Q1_obenlinks.stl, gitter_Q2_obenrechts.stl, gitter_Q3_untenlinks.stl, gitter_Q4_untenrechts.stl, pcb_PCB_Q1.stl, pcb_PCB_Q2.stl]
2026-11-08 Release diffuser for self-cut and Cutworks (7/7)
    [Diffusor_30x30_R12.dxf]
2026-11-08 Add PCB routing guide and apply it to Freerouting
    ROUTING_GUIDE.md holds the project's layout rules and how each one is
    implemented (or why not: top layer stays the +5V plane). route_master:
    100 passes, top horizontal / bottom vertical, +3V3 netclass 0.5 mm.
2026-11-08 PCB: minute LED D75 in the outer corner, decoupling per routing guide
    D75 (SK6812RGBW) + C175 sit at the outer corner (local 230/230) and are
    chained right after cell (5,5); 73 LEDs per board, 292 in total. Outer
    board corner radius 6 -> 3 mm to fit the LED. C4 moved next to the
    ESP32 3V3 pin (19.4 -> 4.3 mm), C5 next to EN. Connectors, ESP32,
    holes and fiducials locked. DRC 0 / unconnected 0 / parity 0.
    [LED-Board_master.step, LED-Board_slave.step, WortUhr.kicad_pcb, WortUhr.kicad_sch]
2026-11-08 Front plate: four minute dots, 4 mm, 18 mm from the edges
    [Frontplatte-500mm-Sencilla.dxf, Frontplatte_1mm.step, Frontplatte_1mm_mit_Lichtleiter.dxf]
2026-11-08 Grid: light chambers for the minute dots (P1S and JLC3DP)
    Per corner: LED recess 7.4 mm, light channel 5 mm tapering from the LED
    to below the dot (last 5 mm straight), pocket 5.9 x 2.1 mm for a round
    5.6 mm diffuser. Walls >= 2.5 mm. The PCB model gets the minute LEDs.
    [Diffusor_Minutenpunkt_D5.6x2.step, FrontPlatte-Bestellung.FCStd, Gitter_Q1_obenlinks.step, Gitter_Q1_obenlinks_JLC3DP.step, Gitter_Q1_obenlinks_JLC3DP_druckfertig.3mf, Gitter_Q1_obenlinks_druckfertig.3mf, Gitter_Q2_obenrechts.step, Gitter_Q2_obenrechts_JLC3DP.step]
2026-11-08 Firmware: minute dots (minute mod 5, clockwise from top left)
    Layout header now maps cells to LEDs with one minute LED per board
    (num_leds 292 / 148). WLED ledmaps skip the minute LEDs.
    [wortuhr.h, wortuhr.yaml, wortuhr_layout.h]
2026-11-08 Rendering: 11:42 with two minute dots, extra blue night view
    render_wortuhr.py gets --color (warm|blau|R,G,B) and --dark. New image
    WortUhr_front_blau_dunkel.png; the CI rendering job renders all three.
    [WortUhr_Szene.blend, diffusor_an.stl, diffusor_aus.stl, frontplatte.stl, gitter_Q1_obenlinks.stl, gitter_Q2_obenrechts.stl, gitter_Q3_untenlinks.stl, gitter_Q4_untenrechts.stl]
2026-11-08 Re-qualify everything with minute dots: all components released
    PCB 30/30, front plate 19/19, diffuser 15/15 (incl. 4 minute dots),
    grid 88/88 (P1S + JLC3DP), rear frame 114/114, firmware 13/13, WLED 3/3.
    [BOM_Master.csv, BOM_Slave.csv, Diffusor_Minutenpunkt_D5.6_R12.dxf, Frontplatte_Corten_1mm_R12.dxf, Gitter_Q1_obenlinks.step, Gitter_Q1_obenlinks_JLC3DP.step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]
2026-11-08 PCB images for review without KiCad, also built in CI
    pcb_images.py renders 3D views (top, bottom, angled), a multipage PDF
    with one page per layer and copper SVGs. Stored in 02_Electronics/Bilder
    and uploaded by the pcb job as artifact WortUhr-Platine-Bilder.
2026-11-08 Routing guide: power-integrity review and rule set
    Add the PI review prompt as part 2, its project mapping, precedence
    rules and a rule set of 18 rule IDs with a maintenance procedure.
2026-11-08 PCB: rework layout to the rule set, routed via Freerouting MCP
    LED A decoupling now closes its loop at the LED GND pin without vias
    (DEC-002, 37 fewer vias). C8 under U5 pin 1, R3 at the EN pin. +3V3 trunk
    and VBUS fan-out pre-routed at full width, no automatic neck-down
    (PWR-001); only U5 pin 1 stays 0.25 mm for 0.5 mm pitch. Routing split
    into route_master --prepare and route_finish for the MCP workflow.
    DRC 0 errors, 0 unconnected, parity 0; 198 vias (was 236).
    [LED-Board_master.step, LED-Board_slave.step, WortUhr.kicad_pcb]
2026-11-08 Re-qualify PCB after layout rework (30/30)
    [LED-Board_master.step, LED-Board_slave.step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]
2026-11-08 PCB rev3: USB-C PD supply, structured schematic, rework per review list
    Schematic in four sheets with power symbols and wires. Barrel jack and
    diodes replaced by CH224K (15 V) and SCT2360 (5 V / 6 A), 100 uF bulk per
    board for the 1 ms soft start, 22 uF at the ESP32. Decoupling at the LED
    +5V pin with own GND via, sensor and level shifter rotated, I2C on
    IO1/IO2, LED data on IO8, USB as a pair (0.45/0.15 mm), 45-degree jumps,
    persistent net classes. Routed via Freerouting MCP. DRC 0, parity 0.
    [Abblockung.kicad_sch, ESP32.kicad_sch, LED-Board_master.step, LED-Board_slave.step, LED_Feld.kicad_sch, Versorgung.kicad_sch, WortUhr.kicad_pcb, WortUhr.kicad_sch]
2026-11-08 Firmware: new pins, PD status input, 5 A current limit
2026-11-08 Re-qualify PCB rev3 and firmware
    [BOM_Master.csv, BOM_Slave.csv, LED-Board_master.step, LED-Board_slave.step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]
2026-11-08 FreeCAD model: boards rebuilt from PCB rev3 STEP
    update_pcb_model.py replaces the four PCB objects with the current STEP
    exports, adds a placeholder for L1 and checks collisions. No collision
    with the grids; L1 reaches 1 mm into the Q4 long rear frame bar.
    [FrontPlatte-Bestellung.FCStd]
2026-11-09 PCB rev3: buck and USB placement per datasheet layout
    [ESP32.kicad_sch, Versorgung.kicad_sch]
2026-11-09 PCB rev3: hand-routed buck converter and USB pair without vias
2026-11-09 PCB rev3: hand-route I2C, EN, PD_GOOD and GND bridges in pipeline
2026-11-09 PCB rev3: master area fully routed, routing images
    [WortUhr.kicad_pcb]
2026-11-09 PCB qualification: check track angles, update supply notes
2026-11-09 Re-qualify PCB rev3 after routing (31/31), update production data
    [LED-Board_master.step, LED-Board_slave.step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]
2026-11-09 FreeCAD model and 3D export: boards rebuilt from routed PCB rev3
    [FrontPlatte-Bestellung.FCStd, LED-Board_master.step, LED-Board_slave.step]
2026-11-09 PCB rev3: datasheet review, R20 1206, USB series resistors, C_BUS at U3
    [Abblockung.kicad_sch, ESP32.kicad_sch, LED_Feld.kicad_sch, Versorgung.kicad_sch]
2026-11-09 PCB rev3: wider 3V3 with double vias, short U3 GND path, GND links
    [route_master.py]
2026-11-09 PCB rev3: routed after datasheet review, updated images
    [WortUhr.kicad_pcb]
2026-11-09 PCB qualification: include C28 decoupling check
2026-11-09 Re-qualify PCB rev3 after datasheet review (31/31), update production data
    [BOM_Master.csv, LED-Board_master.step, LED-Board_slave.step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]
2026-11-09 FreeCAD model and 3D export: boards from reworked PCB rev3
    [FrontPlatte-Bestellung.FCStd, LED-Board_master.step, LED-Board_slave.step]
2026-11-09 Rear frame Q4 long: pocket for inductor L1, print plate 1 updated
    [FrontPlatte-Bestellung.FCStd, Rueckrahmen_Druckplatte1_lange_Leisten.3mf, Rueckrahmen_Q4_untenrechts_lang.step]
2026-11-09 PCB rev3: L1 and F1 part numbers, silkscreen rev3
    [Versorgung.kicad_sch, WortUhr.kicad_pcb]
2026-11-09 PCB qualification: LCSC numbers for verified parts, updated notes
2026-11-09 Re-qualify after L1 pocket and part selection, update production data
    [BOM_Master.csv, FrontPlatte-Bestellung.FCStd, LED-Board_master.step, LED-Board_slave.step, Rueckrahmen_Druckplatte1_lange_Leisten.3mf, Rueckrahmen_Q4_untenrechts_lang.step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]
2026-11-09 PCB rev3: MPN and DigiKey part numbers as symbol properties
    [Abblockung.kicad_sch, ESP32.kicad_sch, Versorgung.kicad_sch, WortUhr.kicad_pcb]
2026-11-09 PCB qualification: DigiKey BOM for one complete set
2026-11-09 Production data: DigiKey BOM added, re-qualified
    [BOM_DigiKey.csv, LED-Board_master.step, LED-Board_slave.step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]
2026-11-09 PCB rev3: DigiKey numbers verified via API for all available parts
    [ESP32.kicad_sch, Versorgung.kicad_sch, WortUhr.kicad_pcb]
2026-11-09 PCB qualification: separate list for parts not sold by DigiKey
2026-11-09 Production data: complete DigiKey BOM and sourcing list
    [BOM_DigiKey.csv, BOM_Separat_Beschaffung.csv, LED-Board_master.step, LED-Board_slave.step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]
2026-11-09 PCB rev3: L1 changed to SRP1265A-3R3M (same pads, in stock)
    [Versorgung.kicad_sch, WortUhr.kicad_pcb]
2026-11-09 Rear frame: deeper L1 pocket for 6.5 mm inductor, model updated
    [FrontPlatte-Bestellung.FCStd, LED-Board_master.step, LED-Board_slave.step, Rueckrahmen_Druckplatte1_lange_Leisten.3mf, Rueckrahmen_Q4_untenrechts_lang.step]
2026-11-09 Re-qualify after L1 change, update production data
    [BOM_DigiKey.csv, BOM_Master.csv, LED-Board_master.step, LED-Board_slave.step, Rueckrahmen_Druckplatte1_lange_Leisten.3mf, Rueckrahmen_Q4_untenrechts_lang.step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]
2026-11-10 Schematic: readable layout per new rules SCH-001..010
    The schematic generator now draws function blocks with frames, titles
    and design notes, wires inside blocks, and named power symbols. The LED
    decoupling capacitors sit next to their LED; the Abblockung sheet is
    gone. The root sheet is a block diagram. Sheets are A3 instead of A2.
    The netlist is unchanged (137 nets, same names and pins). In the PCB
    file only the sheet path of the 73 LED capacitors changed.
    gen_sch.py checks its own drawing (nets against design.py, overlapping
    text, wires through text or symbols) and has a --check mode that
    compares the project files with the generator output. qualify_pcb.py
    runs these checks and counts E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
    [Abblockung.kicad_sch, ESP32.kicad_sch, LED_Feld.kicad_sch, Versorgung.kicad_sch, WortUhr.kicad_pcb, WortUhr.kicad_sch]
2026-11-10 Checks: firmware pins, current limit in every mode, decoupling list, power widths
    design.py is now the source for the ESP32 pin map, the decoupling map and the minimum power track widths. qualify_firmware.py compares the firmware pins and the pin numbers in the docs with it; qualify_pcb.py checks every capacitor's role (DEC-010), the pad distance of all decoupling capacitors (DEC-009), the power track widths with the documented exception (PWR-001), the antenna keepout (RF-001) and the module pin names.
    Firmware: the 5 A limit and the PD lockout now also cover plain light and the test effects (guard interval in wortuhr.yaml, shared estimate in wortuhr.h). Built, not tested on hardware.
    Docs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
2026-11-10 PCB rev3: C20 moved to U6 pin 1, PD_VDD rerouted
    C20 (VDD decoupling of the CH224K) was 8.3 mm from pin 1 and reached it through two vias. It now sits 2.3 mm below the pin; the supply from R20 runs through the capacitor to the pin, with the via behind the capacitor.
    Only the PD_VDD net was changed in the routed board; no new Freerouting run. The placement is in design.py and the fixed pre-route in route_master.py (syntax-checked only). DRC 0 errors, parity 0, qualification 39/39. No collision with grid or rear frame (read-only check); FreeCAD model, 3D export and production data still show the old position.
    [WortUhr.kicad_pcb]
2026-11-10 Cleanup: central tool paths, complete build_pcb, stale docs, CLAUDE.md
    kicad_env.py is the only place with install paths (KICAD_CLI, KICAD10_SYMBOL_DIR, KICAD10_FOOTPRINT_DIR, FREEROUTING_JAR, FREEROUTING_JAVA) and records the Freerouting build the board was routed with. build_pcb.py now runs route_buck_usb.py too.
    Docs: barrel jack, J2, D73, D74 removed; BESTUECKUNG.md updated to rev3 (C1 value, master parts, WLED current limit, build section); README lists ESPHome, 05_Production and the guide; CLAUDE.md describes principles, workflows and checks.
    Removed the unused barrel jack 3D model and a tracked .pyc; .history/ is ignored.
    [BarrelJack_CUI_PJ-036AH-SMT_Platzhalter.step]
2026-11-10 Single source: grid dimensions and LCSC numbers in design.py, production data check
    GRID_PX, GRID_PY, CLOCK_CENTER and PITCH now live only in design.py; the laser and print qualification, the mesh export, update_pcb_model.py and make_jlc3dp_variant.py read them from there. PITCH is unchanged (38.4607 mm). The LCSC numbers moved from qualify_pcb.py to design.py; the generated BOMs are identical.
    check_production.py compares the files in 05_Production with the checksums in their reports and with the source files of the same name; it runs in the workflow. update_pcb_model.py can read the board STEP files from the qualification staging (WORTUHR_STEP_DIR). Removed the unused WortUhr.step from 20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
    [WortUhr.step]
2026-11-10 Analysis of the rev3 power supply: nine findings
    Calculated from the datasheets and the board, nothing measured. Major: converter heating at 5 A continuous load, one input capacitor instead of the recommended two, edge bridges without a part with a documented current rating. Proposed rules THM-001, PWR-005 and TST-001 are in the report only.
2026-11-10 PCB rev4: second input capacitor, 25 V output capacitors, TVS, test points
    From the rev3 analysis: C29 (22 uF / 25 V) next to C21 at the converter input (A2); C23 to C25 are now 22 uF / 25 V in 1206 (A4); D80 (SMBJ16A) on +15V behind F1 (A8); TP1 to TP8 as 1.5 mm pads on the bottom side (A9). Title block and silkscreen say rev4.
    The changes were made in the routed board without a new Freerouting run. Placement is in design.py, the changed zones and vias at the converter in route_buck_usb.py (syntax-checked only). The netlist only gained the new parts. DRC 0 errors, parity 0, qualification 39/39, no collision with grid or rear frame.
    Open: the SMBJ16A values are not checked against a datash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
    [ESP32.kicad_sch, LED_Feld.kicad_sch, Versorgung.kicad_sch, WortUhr.kicad_pcb, WortUhr.kicad_sch]
2026-11-10 FreeCAD model, 3D export and render meshes: boards rebuilt from PCB rev4
    update_pcb_model.py with the STEP files from the rev4 qualification. No collision between the boards and grid or rear frame.
    [FrontPlatte-Bestellung.FCStd, LED-Board_master.step, LED-Board_slave.step, pcb_PCB_Q1.stl, pcb_PCB_Q2.stl, pcb_PCB_Q3.stl, pcb_PCB_Q4_Master.stl, rueckrahmen.stl]
2026-11-10 Re-qualify for PCB rev4, update production data
    All parts released: PCB 39/39, front plate 19, diffuser 15, grid 88, rear frame 114, firmware 17 (with build), WLED 3. Reports refer to 1fda351.
    [BOM_DigiKey.csv, BOM_Master.csv, BOM_Separat_Beschaffung.csv, LED-Board_master.step, LED-Board_slave.step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]
2026-11-10 Add old/new comparison of PCB layers and schematic sheets
    vergleich.py exports two git states (or the working tree) with kicad-cli as
    black-and-white PDFs, rasterises them and overlays each layer and sheet:
    red = only in the old state, green = only in the new state, grey = unchanged.
    Output: Vergleich.pdf (changed pages first), single PNGs, Vergleich.md.
    The board is plotted on A2 in the working copy only, because it extends
    beyond the A4 sheet.
2026-11-10 Workflow: comparison job for PCB and schematic
    New job compares against the PR target branch, on push against the state
    before the push, otherwise against the parent commit. Result as artifact
    WortUhr-Vergleich and in the run summary. Default local output folder
    02_Electronics/Vergleich is ignored.
2026-11-10 Resolve legacy items: archive one-off scripts, drop 3D-Export, rename chamber nets
    The eight finished one-time scripts moved to 99_Archive/Einmal-Skripte with a README. 02_Electronics/3D-Export is gone: its STEP files were identical to the released ones, and update_pcb_model.py now reads those (or fresh ones via WORTUHR_STEP_DIR).
    SCH-009: the chamber data nets are Knn_A_OUT/Knn_B_OUT instead of Cnn_A_OUT/Cnn_B_OUT (71 nets) in design.py, board, net class pattern and guide. The netlist is identical apart from the names. PCB 39/39.
    update_pcb_model.py was not run after the path change.
    [LED-Board_master.step, LED-Board_slave.step, LED_Feld.kicad_sch, WortUhr.kicad_pcb]
2026-11-10 Re-qualify after net rename, update production data
    PCB 39/39; the other parts are unchanged since the rev4 qualification. Schematic PDF with the new net names.
    [LED-Board_master.step, LED-Board_slave.step]
